udayjain2102/nittanymotorsports/mule/docs/REPORT.md

# NM26 mule: design report

Generated by `python report.py` on 2026-10-11. It holds every design check the code runs, the key analysis results, and every automated test with its outcome. Don't edit it by hand; re-run the script. For what was done and why, see [PROJECT_LOG.md](PROJECT_LOG.md). For the physical tests, see [TEST_PLAN.md](TEST_PLAN.md).

## Key results

| Quantity | Value | From |
|---|---|---|
| Frame | 124 members, 49.4 kg, 71 pieces | `mule.py`, `fab.py` |
| Torsional stiffness | 2399 N·m/deg | `fea.py` |
| Roll-over 6/5/9 kN (legacy AF4 loads), worse of hoop-base supports and inertia relief, safety factor vs welded 4130 yield 340 MPa (criterion under advisor review) | main 1.22, front 1.11 | `fea.py` |
| Frontal impact 95 kN (F.8.7.2), frame safety factor vs welded UTS | 1.26 | `fea.py` |
| Wheel-load cases, worst frame safety factor | 1.34 | `loads.py` |
| Worst link buckling safety factor | 3.8 (rear pushrod (kerb in 1g corner)) | `loads.py` |
| Springs front / rear | 282 / 208 lb/in | `springs.py` |
| Launch, frame safety factor | 1.39 | `powertrain.py` |
| 2000 N pedal, frame safety factor | 1.27 | `brakes.py` |
| 20 g harness crash, frame safety factor vs welded UTS | 1.34 | `harness.py` |
| Mass, front split, CG height, tilt angle | 300 kg, 48.2 %, 325 mm, 61.9 deg | `mass.py` |

## Design checks: 232/232 pass

### FSAE rules (V, F, T) (`mule.py`): 28/28 pass

| | Check | Result |
|---|---|---|
| PASS | V.1.2 wheelbase >=1525 | 1750 |
| PASS | V.1.3.2 small/large track >=75% | 1.00 |
| PASS | V.1.4.2 lower SIS to ground <=90 (should <=75) | 57.1 |
| PASS | F.6.4.4 upper SIS top edge 290-345 above lower SIS bottom | 325.8 |
| PASS | F.3.4.1 size J I>=11320, A>=173 | I=43221 A=270 |
| PASS | F.3.4.1 size H I>=11320, A>=173 | I=24065 A=222 |
| PASS | F.3.4.1 size A I>=11320, A>=173 | I=11626 A=174 |
| PASS | F.3.4.1 size B I>=8509, A>=114 | I=8722 A=123 |
| PASS | F.3.4.1 size C I>=6695, A>=91 | I=6885 A=94 |
| PASS | F.5.8.4 main hoop inside width at base >=380 | 559 |
| PASS | F.5.9.4 MH brace attach <=160 below top | 19.0 |
| PASS | F.5.9.5 MH/brace included angle >=30 | 40.8 deg |
| PASS | F.6.3.4 FH brace attach <=50 below top | 15.9 |
| PASS | F.5.7.4 FH top >= steering wheel top | 866 vs 720 |
| PASS | F.5.7.5 FH <=250 forward of steering wheel | 64 |
| PASS | T.1.4.4 controls below FH top | steering wheel |
| PASS | F.5.6.4a helmet >=50 from MH-FH line | 70 |
| PASS | F.5.6.4b helmet >=50 from MH-brace line | 259 |
| PASS | T.2.1.d upright seat (<=30 deg) | 20 |
| PASS | F.5.6.6 hip->pedal >=915 | 915 |
| PASS | F.8.4.3 bulkhead <=400x350 (no X-brace needed) | 385x335 |
| PASS | F.8.6.3 pedal box 25 mm clear of AIP | 31 |
| PASS | F.8.5.6a IA bottom leading edge <=175 above lower SIS bottom | 63 |
| PASS | F.8.4.2 IA >=200 long, >=200 wide, >=100 high |  |
| PASS | T.2.6.1 shoulder belt angle -20..+10 | -8.1 deg |
| PASS | T.2.6.2 shoulder belt spacing 175-235 | 200 |
| PASS | T.1.5.1a seat not below top of lowest tube | 90 vs 88.9 |
| PASS | frame clear of front tires (steer room >=80) | 327 |

### FSAE frame structure rules (F.1.17, F.3.2.1, F.5, F.6, T.1.3, V.1.1) (`frame_rules.py`): 40/40 pass

| | Check | Result |
|---|---|---|
| PASS | F.5.2.1 every bend radius (tube centreline) >= 3 x tube OD | H: CLR 102 vs 95, J: CLR 127 vs 114 |
| PASS | frame tubes that share no joint stay >= 3 mm apart (no tube passes through another; ours, fab) | none |
| PASS | F.3.2.1 every tube meets the size its job requires | all OK |
| PASS | F.1.17 / F.5.6.2 Primary Structure triangulated in side view (right): no primary joint can move in a pin-jointed truss | 19 joints; none movable |
| PASS | F.1.17 / F.5.6.2 Primary Structure triangulated in side view (left): no primary joint can move in a pin-jointed truss | 19 joints; none movable |
| PASS | F.5.6.3 main hoop bends below its braces are at nodes triangulated in side view | all triangulated |
| PASS | F.5.6.3 front hoop bends below its braces are at nodes triangulated in side view | all triangulated |
| PASS | F.5.2.3 every bent primary member has a same-size support tube within 30 deg of its plane at its farthest point | all supported |
| PASS | F.5.7.3/F.5.7.2 front hoop is one piece from the lowest frame member side to side | 1 piece(s), ends at y [73, 73] |
| PASS | F.5.7 front hoop above the upper side impact < 20 deg from vertical | 0.0 deg |
| PASS | F.5.8.3/F.5.8.2 main hoop is one piece from the lowest frame member side to side | 1 piece(s), ends at y [73, 73] |
| PASS | F.5.8 main hoop above the upper side impact < 10 deg from vertical | 0.0 deg |
| PASS | F.5.8.3b main hoop below the upper side impact not rearward > 10 deg | -0.0 deg |
| PASS | F.5.9 two mh braces, one per side, each straight | 2 brace(s) |
| PASS | F.5.9.3 main hoop and its braces on opposite sides of the vertical through the top | hoop body dx 0 |
| PASS | F.6.3 two fh braces, one per side, each straight | 2 brace(s) |
| PASS | F.6.3.2 front hoop braces extend forward |  |
| PASS | F.6.3.3 front hoop braces end at the bulkhead or a triangulated node |  |
| PASS | F.6.3.5 front hoop above the side impact does not lean rearward > 10 deg (else extra braces) |  |
| PASS | F.5.11.4 no engine or suspension mounts on the main hoop or brace spans | none |
| PASS | F.6.2.3a upper bulkhead support within 50 mm of the bulkhead top and of the upper side impact at the front hoop |  |
| PASS | F.6.2.3c lower bulkhead support from the bulkhead base to the front hoop base |  |
| PASS | F.6.2.3d bulkhead support diagonal fitted (triangulation checked by the truss test) |  |
| PASS | F.6.2 front bulkhead is a closed perimeter (the AIP mounts around it) | closed |
| PASS | F.3.2.1 every lap / anti-sub tab node sits on a harness-size (or larger) tube | all |
| PASS | F.6.2.3b upper bulkhead support <= 100 mm above the upper side impact, or triangulated back (side-view truss test) | 43 mm |
| PASS | F.6.4.4/5 upper side impact connects the main hoop and front hoop |  |
| PASS | F.6.4.4/5 lower side impact connects the main hoop and front hoop |  |
| PASS | F.6.4.6 diagonal side impact joins upper and lower members between the hoops |  |
| PASS | F.6.4.3 three or more side impact members each side |  |
| PASS | F.6.5.1 shoulder harness bar is one piece attached to the main hoop both sides |  |
| PASS | F.6.5.2 shoulder bar straight (a bent bar would need braces at the bends) |  |
| PASS | F.6.5.3 shoulder bar loaded only by the shoulder harness | only harness tabs |
| PASS | F.6.6.2a upper brace support runs from the brace foot to the upper side impact node on the main hoop |  |
| PASS | F.6.6.2b lower brace support ends at the lower side impact node on the main hoop |  |
| PASS | F.5.14 steering rack inside the Primary Structure (no separate protection needed) | rack ends z ±210 |
| PASS | T.1.3.1 driver's hips inside the Major Structure | 0 of 36 hip points outside (hip half-width 200 assumed) |
| PASS | T.1.3.2 driver's legs ahead of the front hoop inside the structural tubing in side and front view (95th male, estimated) | knee top at x 1432, y 506; 0 side-view / 0 front-view leg points outside |
| PASS | T.1.3.2 / ours: no tube within 10 mm of the driver's legs and feet (95th male capsules, estimated) | 22 mm (FBH support upper) |
| PASS | V.1.1 nothing in the tyre zones: above, beside, or within 75 mm fore/aft (frame, attenuator) | clear |

### Frame strength: roll-over, frontal impact, buckling (`fea.py`): 12/12 pass

| | Check | Result |
|---|---|---|
| PASS | frontal impact: 95 kN IA peak (F.8.7.2) through the front structure, FoS >= 1.0 vs welded UTS | 1.26 (FBH support upper); crash case: local yield accepted |
| PASS | Main hoop roll-over 6/5/9 kN (legacy AF4 loads; ours), worse of hoop-base supports and inertia relief, FoS >= 1.0 vs 340 MPa | 1.22; vs F.3.4.2 welded 180 MPa: 0.65 |
| PASS | Main hoop roll-over deflection <= 25 mm | 9.7 mm |
| PASS | Front hoop roll-over 6/5/9 kN (legacy AF4 loads; ours), worse of hoop-base supports and inertia relief, FoS >= 1.0 vs 340 MPa | 1.11; vs F.3.4.2 welded 180 MPa: 0.59 |
| PASS | Front hoop roll-over deflection <= 25 mm | 7.1 mm |
| PASS | buckling: roll-over (6/5/9 kN, worst support), Euler load >= 1.0 x compression in every frame tube (pin-ended; ours) | 2.26 (Main hoop brace) |
| PASS | buckling: frontal impact 95 kN (F.8.7.2), Euler load >= 1.0 x compression in every frame tube (pin-ended; ours) | 2.94 (Upper side impact) |
| PASS | buckling: wheel loads, Euler load >= 1.5 x compression in every frame tube (pin-ended; ours) | 4.92 (Main hoop brace) |
| PASS | buckling: launch, Euler load >= 1.5 x compression in every frame tube (pin-ended; ours) | 3.20 (Engine bay floor diagonal) |
| PASS | buckling: 2000 N pedal, Euler load >= 1.5 x compression in every frame tube (pin-ended; ours) | 35.11 (Front hoop lower brace) |
| PASS | buckling: 20 g harness, Euler load >= 1.0 x compression in every frame tube (pin-ended; ours) | 42.88 (Diagonal side impact) |
| PASS | buckling: wing mounts, Euler load >= 1.5 x compression in every frame tube (pin-ended; ours) | 70.63 (Wing strut) |

### Suspension kinematics (`suspension.py`): 12/12 pass

| | Check | Result |
|---|---|---|
| PASS | front roll centre 15-60 mm | 39 mm |
| PASS | front no lock-up over +/-50 mm (V.3.1.1: 50 mm usable; design +50/-25) |  |
| PASS | front camber gain -1.2..-0.3 deg per 25 mm bump | -0.75 deg @+25, -1.57 @+50, +1.35 @-50; track +0.1 mm @+50 |
| PASS | front Bl inside 13in wheel (\|dy\|<=125, 30<=inset<=110) | dy=118 inset=62 |
| PASS | front Bu inside 13in wheel (\|dy\|<=125, 30<=inset<=110) | dy=120 inset=102 |
| PASS | front KPI 0-10 deg, scrub 0-40 mm | KPI 9.6 deg, scrub 38 mm |
| PASS | rear roll centre 25-80 mm | 50 mm |
| PASS | rear no lock-up over +/-50 mm (V.3.1.1: 50 mm usable; design +50/-25) |  |
| PASS | rear camber gain -1.2..-0.3 deg per 25 mm bump | -0.70 deg @+25, -1.44 @+50, +1.36 @-50; track +0.5 mm @+50 |
| PASS | rear Bl inside 13in wheel (\|dy\|<=125, 30<=inset<=110) | dy=114 inset=65 |
| PASS | rear Bu inside 13in wheel (\|dy\|<=125, 30<=inset<=110) | dy=110 inset=80 |
| PASS | rear KPI 0-10 deg, scrub 0-80 mm | KPI 3.8 deg, scrub 55 mm |

### Rockers and shocks (`rocker.py`): 12/12 pass

| | Check | Result |
|---|---|---|
| PASS | front shock stays in 165-230 mm over +50/-25 mm wheel | 169-224 mm (static 207) |
| PASS | front motion ratio within 10% of springs.py target | 0.72 vs 0.72 |
| PASS | front ratio change over travel -5..+20% (not regressive) | +12% (bump vs droop) |
| PASS | front rocker swing < 35 deg each way | +9/-20 deg |
| PASS | front shock body clears frame tubes >= 5 mm | 41 mm (upper ring_sus) |
| PASS | front rocker arms 40-150 mm | pushrod arm 92, shock arm 109 mm |
| PASS | rear shock stays in 165-230 mm over +50/-25 mm wheel | 168-225 mm (static 207) |
| PASS | rear motion ratio within 10% of springs.py target | 0.75 vs 0.75 |
| PASS | rear ratio change over travel -5..+20% (not regressive) | +11% (bump vs droop) |
| PASS | rear rocker swing < 35 deg each way | +8/-17 deg |
| PASS | rear shock body clears frame tubes >= 5 mm | 72 mm (steer) |
| PASS | rear rocker arms 40-150 mm | pushrod arm 60, shock arm 135 mm |

### Steering (`steering.py`): 5/5 pass

| | Check | Result |
|---|---|---|
| PASS | bump steer \|toe\| <= 0.25 deg over +/-50 mm | -50: -0.11, -25: -0.05, +25: +0.06, +50: +0.12 deg |
| PASS | rear bump steer \|toe\| <= 0.25 deg over +/-50 mm (toe link) | -50: -0.01, -25: -0.00, +25: +0.00, +50: +0.01 deg |
| PASS | rack travel for 23 deg inner lock <= 35 mm | 29.6 mm each side |
| PASS | Ackermann 0-120 % | inner 23.0 / outer 20.6 deg = 50 % |
| PASS | tyre/rim clears arms, rods, frame at full lock (3D) | min gap 10 mm (lower bh_lsus) |

### Side view, caster, pitch, steering ratio (`sideview.py`): 10/10 pass

| | Check | Result |
|---|---|---|
| PASS | front caster 3-7 deg | 4.6 deg |
| PASS | front mechanical trail 5-30 mm | 11.5 mm |
| PASS | anti-dive / anti-squat 0-40 % | anti-dive 0 %, anti-squat 12 % |
| PASS | dive at 1.5 g braking <= 60 % of bump travel | 21 mm front, pitch 1.54 deg |
| PASS | squat at 1 g acceleration <= 60 % of bump travel | 15 mm rear |
| PASS | roll-centre migration <= 2 mm per mm of heave (+/-25 mm) | front +39/-38, rear +44/-44 mm; front RC at full dive 7 mm |
| PASS | bump steer at full lock <= 0.5 deg over +/-25 mm | 0.30 deg |
| PASS | overall steering ratio 4-7 : 1 | 4.1:1, 89 deg to full lock |
| PASS | lock-to-lock <= 180 deg (no hand-over-hand) | 178 deg |
| PASS | steering rim force at 1.5 g <= 120 N (ours) | 105 N (14.2 N*m); kickback 9.3 N*m per 1 kN on one front tyre |

### Roll, static camber, jacking (`roll.py`): 10/10 pass

| | Check | Result |
|---|---|---|
| PASS | front lateral load transfer share within front weight 48 % +0..+12 points (ours: mild understeer) | LLTD 53.0 % front (roll stiffness 55 % front, no bars) |
| PASS | roll gradient 0.5-2.0 deg/g (ours) | 1.47 deg/g, 2.2 deg at 1.5 g |
| PASS | front static camber -3.5..0 deg | -2.5 deg |
| PASS | front outside-wheel camber to ground -2.0..-0.3 deg at 1.5 g (ours) | outside -1.00, inside -4.04 deg |
| PASS | front roll centre stays above ground in roll (jacking keeps its sign) | height 28 mm (static 39); lateral shift -192 mm = -87 mm/deg (low RCs move far sideways) |
| PASS | front jacking lift <= 5 mm at 1.5 g (ours) | -9 N, lift -0.2 mm |
| PASS | rear static camber -3.5..0 deg | -2.0 deg |
| PASS | rear outside-wheel camber to ground -2.0..-0.3 deg at 1.5 g (ours) | outside -0.46, inside -3.56 deg |
| PASS | rear roll centre stays above ground in roll (jacking keeps its sign) | height 36 mm (static 50); lateral shift -214 mm = -97 mm/deg (low RCs move far sideways) |
| PASS | rear jacking lift <= 5 mm at 1.5 g (ours) | 6 N, lift 0.2 mm |

### Compliance steer and camber (pickup stiffness) (`compliance.py`): 2/2 pass

| | Check | Result |
|---|---|---|
| PASS | front compliance at 1.5g corner: toe and camber <= 0.25 deg (ours) | toe 0.109 in, camber -0.028 deg; worst arm stretch 0.062 mm |
| PASS | rear compliance at 1.5g corner: toe and camber <= 0.25 deg (ours) | toe 0.185 out, camber +0.063 deg; worst arm stretch 0.095 mm |

### Uprights and hubs (`uprights.py`): 16/16 pass

| | Check | Result |
|---|---|---|
| PASS | front bearing static safety s0 >= 1.5 (all cases) | 2.40 (SKF 6209-2RS1 (45x85x19 deep groove)) |
| PASS | front bearing L10 >= 3x 2000 km | 365 vs 3.7 Mrev |
| PASS | front hub shaft FoS >= 1.5 (bending + torsion) | 9.5 |
| PASS | front upright arms FoS >= 1.5 (7075-T6) | 2.9 (lower arm 67 mm (3g bump)) |
| PASS | front wheel studs slip torque >= 1.5x max wheel torque | 1469 vs 461 N*m |
| PASS | front rotor + caliper inside rim barrel | 145 vs 155 mm |
| PASS | front upright body clears rotor >= 10 mm | 12 mm |
| PASS | front ball joints within the bearing housing span | BJs z -102/-62, bearings -79/-24 mm from wheel centre |
| PASS | rear bearing static safety s0 >= 1.5 (all cases) | 2.22 (SKF 6209-2RS1 (45x85x19 deep groove)) |
| PASS | rear bearing L10 >= 3x 2000 km | 287 vs 3.7 Mrev |
| PASS | rear hub shaft FoS >= 1.5 (bending + torsion) | 5.2 |
| PASS | rear upright arms FoS >= 1.5 (7075-T6) | 1.6 (lower arm 64 mm (3g bump)) |
| PASS | rear wheel studs slip torque >= 1.5x max wheel torque | 1469 vs 852 N*m |
| PASS | rear rotor + caliper inside rim barrel | 145 vs 155 mm |
| PASS | rear upright body clears rotor >= 10 mm | 12 mm |
| PASS | rear ball joints within the bearing housing span | BJs z -80/-65, bearings -79/-24 mm from wheel centre |

### Powertrain (`powertrain.py`): 15/15 pass

| | Check | Result |
|---|---|---|
| PASS | top speed at redline 100-130 km/h | 117 km/h (13/50 = 3.85) |
| PASS | 1st gear can reach the traction limit | 928 vs 852 N*m |
| PASS | chain centre distance >= r1 + r2 + 25 mm | 200 mm (min 185) |
| PASS | wrap on the front sprocket >= 120 deg | 125 deg |
| PASS | even-link chain fits inside the carrier adjustment | 60 links -> centre 205 mm (+5, adjust +/-20) |
| PASS | chain tension safety >= 4 (traction-limited) | 6.7 kN vs 36 kN |
| PASS | sprockets/chain clear frame tubes >= 10 mm | 18 mm (Rear side bay diagonal (bulkhead pickups)) |
| PASS | sprockets/chain >= 50 mm above ground | 126 mm |
| PASS | chain line outboard of the engine, inboard of the spool posts | z = -180 (engine side -170, posts -234) |
| PASS | CV angle <= limit over +/-50 mm travel | 10.2 deg (shaft 277 mm) |
| PASS | CV plunge <= limit | 4.5 mm |
| PASS | rear toe link clears the CV half-shaft >= 10 mm over travel (boot included) | 54 mm |
| PASS | engine envelope clear of main hoop / firewall | engine front 470, firewall 480 |
| PASS | no frame tube passes through the engine envelope (except within 60 mm of a mount) | none |
| PASS | frame FoS >= 1.2 under full-traction launch | 1.39 (Rear susp ring) |

### Brakes and pedal box (`brakes.py`): 14/14 pass

| | Check | Result |
|---|---|---|
| PASS | lock all four at mu 1.5 with <= 700 N (T.3.1.2c) | 676 N at split 0.587 (front 83 bar, rear 38 bar) |
| PASS | balance split for mu 1.0-1.5 inside the adjuster | 0.443-0.567 (+0.02 front margin), adjuster 0.40-0.60 |
| PASS | lock-up pressure <= Wilwood max operating 138 bar (2000 psi) | front 83, rear 38 bar |
| PASS | line pressure at 2000 N <= 300 bar (T.3.2.2; ASSUMED proof rating, OPEN until written ratings) | front 267, rear 111 bar: above the 138 bar operating rating, so the parts' proof rating decides |
| PASS | MC stroke at 2000 N <= 50 % of stroke | front 10.7, rear 3.2 of 27.9 mm |
| PASS | BOTS: >= 10 mm beyond pedal travel at 2000 N | trip 55 vs 34.3 mm |
| PASS | BOTS: trips >= 10 mm before either circuit's MC bottoms | front lost 80, rear lost 80 mm |
| PASS | pedal swing at a lost circuit <= 30 deg | 27 deg |
| PASS | pedal blade FoS >= 1.5 at 2000 N | 3.91 |
| PASS | pivot bolt FoS >= 1.5 at 2000 N | 7.79 |
| PASS | balance bar FoS >= 1.5 at 2000 N | 2.36 |
| PASS | frame FoS >= 1.2 at 2000 N pedal load | 1.27 (Pedal box cross (rear)) |
| PASS | MC front inside PEDAL_BOX_LEN (F.8.6.3 stack-up) | 2084 vs 2086 |
| PASS | rotor temperature rise, one stop from top speed <= 150 C | front 126, rear 45 C |

### Cockpit templates (T.1.1, T.1.2) (`cockpit.py`): 2/2 pass

| | Check | Result |
|---|---|---|
| PASS | T.1.1 cockpit opening template passes (>= 0 mm) | worst 1 mm at y=365 (Upper side impact) |
| PASS | T.1.2 cross-section template passes to 100 mm behind the pedals (>= 0 mm) | worst 10 mm at x=1226 (Cockpit floor V (anti-sub)) |

### Harness (T.2) (`harness.py`): 8/8 pass

| | Check | Result |
|---|---|---|
| PASS | T.2.5.4a lap belt side-view angle 45-65 deg | 55.0 deg (tab at x=914 on the lower SIS) |
| PASS | T.2.7.1 anti-sub angle <= 20 deg, mount in line or forward | 0.0 deg from vertical |
| PASS | T.2.6.1 shoulder belt angle -20..+10 deg | -8.1 deg |
| PASS | T.2.4.3a tab double tearout >= 15 kN (one belt per tab) | 31.7 kN |
| PASS | T.2.4.3b tab thickness >= 1.6 mm | 3.2 mm |
| PASS | T.2.4.4 tab weld (both sides) >= 15 kN | 48.9 kN |
| PASS | T.2.5.8 / T.2.6.4 / T.2.7.5 bolt sizes | lap M10, shoulder M10, anti-sub M8 |
| PASS | frame FoS >= 1.0 vs welded UTS under a 20 g harness load | 1.34 (Shoulder harness bar); vs welded yield 0.80 (local yielding in a crash is accepted) |

### Shutdown circuit and wiring (IC.9, T.9) (`shutdown.py`): 14/14 pass

| | Check | Result |
|---|---|---|
| PASS | IC.9.2 opening e-stop kills ignition + fuel pump | powered: ['DRS servo', 'brake light', 'fan', 'starter'] |
| PASS | IC.9.2 opening bots kills ignition + fuel pump | powered: ['DRS servo', 'brake light', 'fan', 'starter'] |
| PASS | IC.9.2 opening inertia switch kills ignition + fuel pump | powered: ['DRS servo', 'brake light', 'fan', 'starter'] |
| PASS | IC.9.2 opening primary master switch kills ignition + fuel pump | powered: nothing |
| PASS | IC.9.3.2a primary master switch cuts ALL loads |  |
| PASS | IC.9.3.2b master switch direct acting (no relay upstream) | battery -> fuse -> PMS |
| PASS | every wire: load <= ampacity, fuse <= ampacity | all OK |
| PASS | every branch off the bus is fused (starter excepted) | all OK |
| PASS | switch and relay ratings >= their current | all OK |
| PASS | voltage drop to pump / ignition <= 0.5 V | fuel pump 0.23 V, ignition/ECU 0.23 V |
| PASS | T.9.2.1 battery inside the structure, below the shoulder belt mount | y=150 vs 620 |
| PASS | T.9.3.1 master switch: right side, at the main hoop, shoulder height | x=560, y=665, z=332 |
| PASS | IC.9.4.1b cockpit main switch >= 24 mm | 40 mm |
| PASS | T.3.4 brake light >= 15 cm2, LED line >= 150 mm, wheel-centre to shoulder height, on centreline | 18 cm2, y=520 |

### Rear wing and DRS (T.7, IN.6.2) (`aero.py`): 10/10 pass

| | Check | Result |
|---|---|---|
| PASS | T.7.3.3 wing is behind the head-restraint plane (inside the rear aero zone) | front -59 vs plane x 533 |
| PASS | T.7.5b no more than 250 mm behind the rear tyres | rear edge x -501 vs limit -510 |
| PASS | T.7.6.3 inboard of the rear tyres' inner faces | endplate outer face 506 vs 520 mm |
| PASS | T.7.7.1a no higher than 1200 mm in either flap position | 1188 mm |
| PASS | IN.6.2.2 200 N push on a wing mount deflects <= 25 mm (any direction) | 0.1 mm |
| PASS | T.7.1.3b wing does not oscillate: mount frequency >= 25 Hz (ours, above wheel hop) | 154 Hz |
| PASS | wing mounts: top-speed load x 1.5 + 3 g bump, FoS >= 1.5 vs welded yield | FoS 37.27 |
| PASS | flap servo stall torque >= 2 x (spring + aero moment) at top speed | servo 15 vs 14.9 N*m (aero 3.2, spring 4.2) |
| PASS | DRS reduces wing drag >= 50 % | at 60 km/h: closed 126 N down / 24 N drag, open 43 / 8 N (ASSUMED coefficients) |
| PASS | front axle keeps >= 90 % of its static load at top speed (ours: limits high-speed understeer) | front -110 N (-8 %), rear +587 N at 117 km/h, closed flap |

### Mass and CG budget (`mass.py`): 5/5 pass

| | Check | Result |
|---|---|---|
| PASS | loads.MASS covers the budget (>= total) | budget 300 kg vs assumed 310 |
| PASS | loads.CG_H covers the budget (>= CG height) | budget 325 mm vs assumed 345 |
| PASS | loads.FRONT_SPLIT within 3 % of the budget | budget 48.2 % vs assumed 48 % |
| PASS | springs.UNSPRUNG within 1.5 kg of the budget | budget 16.2 kg vs assumed 15.0 |
| PASS | tilt test IN.11.2.2: rollover angle >= 60 deg | 61.9 deg (CG 325 mm) |

### Event simulation (acceleration, skidpad) (`lapsim.py`): 5/5 pass

| | Check | Result |
|---|---|---|
| PASS | acceleration 75 m <= 5.5 s (ours; point mass, lower bound) | 5.05 s, 89 km/h at the line (Michigan 2025 median 4.617) |
| PASS | skidpad lap <= 6.0 s (ours; point mass at grip 1.2) | 5.38 s at 36 km/h, R 8.62 m (Michigan 2025 median 5.515) |
| PASS | autocross average speed >= 40 km/h (low end of the D.11.1.1 course design speed) | 62.5 s, 48 km/h on our 0.8 km course; hairpins at 5.0 m radius (car minimum 5.0 m) (Michigan 2025: best 48.878, median 55.725 s, other course) |
| PASS | drag does not limit top speed (drag-limited speed > geared top speed) | drag-limited 134 vs geared 117 km/h (drag area 1.0 m^2) |
| PASS | bolt-on rear wing with DRS would not slow any event (vs no wing; ASSUMED coefficients, wing not fitted on the base mule) | accel -0.00 s, skidpad -0.04 s, autocross -0.60 s with the wing |

### Reality-gap robustness (tube tolerances, joint flex, mass error; docs/SIM_TO_REAL.md) (`robustness.py`): 12/12 pass

| | Check | Result |
|---|---|---|
| PASS | robust: Main hoop roll-over (vs welded 4130 ultimate) FoS >= 1.00 in all 32 tolerance samples (seed 7; walls ±10 %, joints ±2 mm, stiffness 60-100 %) | worst 1.34 |
| PASS | robust: Front hoop roll-over (vs welded 4130 ultimate) FoS >= 1.00 in all 32 tolerance samples (seed 7; walls ±10 %, joints ±2 mm, stiffness 60-100 %) | worst 1.10 |
| PASS | robust: wheel loads FoS >= 1.00 in all 32 tolerance samples (seed 7; walls ±10 %, joints ±2 mm, stiffness 60-100 %) | worst 1.17 |
| PASS | robust: launch FoS >= 1.00 in all 32 tolerance samples (seed 7; walls ±10 %, joints ±2 mm, stiffness 60-100 %) | worst 1.11 |
| PASS | robust: 2000 N pedal FoS >= 1.00 in all 32 tolerance samples (seed 7; walls ±10 %, joints ±2 mm, stiffness 60-100 %) | worst 1.10 |
| PASS | robust: 20 g harness (vs welded UTS) FoS >= 1.00 in all 32 tolerance samples (seed 7; walls ±10 %, joints ±2 mm, stiffness 60-100 %) | worst 1.20 |
| PASS | robust: wing mounts / 1.5 FoS >= 1.00 in all 32 tolerance samples (seed 7; walls ±10 %, joints ±2 mm, stiffness 60-100 %) | worst 22.49 |
| PASS | robust: frontal impact 95 kN (vs welded UTS) FoS >= 1.00 in all 32 tolerance samples (seed 7; walls ±10 %, joints ±2 mm, stiffness 60-100 %) | worst 1.09 |
| PASS | robust: buckling, all cases (Euler / compression) FoS >= 1.00 in all 32 tolerance samples (seed 7; walls ±10 %, joints ±2 mm, stiffness 60-100 %) | worst 1.42 |
| PASS | robust: worst sampled torsion (joint flex modelled) >= 2 x suspension roll stiffness | 1778 vs 1003 N*m/deg (cross-check: 2/3 x nominal FEA = 1600) |
| PASS | robust: tilt >= 60 deg with every mass item ±10 % (5th percentile) | 5/50/95 %: 61.8 / 61.9 / 62.1 deg; mass 289-312 kg |
| PASS | robust: tilt >= 60 deg if mass estimates err together (high items +10 %, low items -10 %) | 61.5 deg (CG +6 mm). Weigh parts as they arrive; IN.11.2 is a hard rule |

## Automated tests (`pytest -q tests`): 97/97 pass

Each `test_all_*_checks_pass` test runs one module's checks above; the others test the math directly (hand calculations, equilibrium, limiting cases).

| Test | Outcome | Seconds |
|---|---|---|
| `tests/test_aero.py::test_all_aero_checks_pass` | pass | 0.16 |
| `tests/test_aero.py::test_forces_are_q_s_c` | pass | 0.0 |
| `tests/test_aero.py::test_axle_split_sums_to_downforce` | pass | 0.0 |
| `tests/test_aero.py::test_drs_truth_table_fails_closed` | pass | 0.0 |
| `tests/test_aero.py::test_flap_rotates_about_its_pivot` | pass | 0.0 |
| `tests/test_brakes.py::test_all_brake_checks_pass` | pass | 0.01 |
| `tests/test_brakes.py::test_axle_loads_sum_to_weight_and_transfer_forward` | pass | 0.0 |
| `tests/test_brakes.py::test_front_lock_pressure_hand_calc` | pass | 0.0 |
| `tests/test_brakes.py::test_lock_point_locks_both_axles_at_once` | pass | 0.0 |
| `tests/test_brakes.py::test_pedal_travel_lever_rule` | pass | 0.0 |
| `tests/test_brakes.py::test_pressure_at_split_matches_bar_force` | pass | 0.0 |
| `tests/test_cad_parts.py::test_part_files_match_csv` | pass | 0.0 |
| `tests/test_cad_parts.py::test_assembly_step_has_every_part` | pass | 0.35 |
| `tests/test_cockpit.py::test_templates_pass` | pass | 29.04 |
| `tests/test_cockpit.py::test_polygon_clearance_sign` | pass | 0.0 |
| `tests/test_cockpit.py::test_t12_template_size` | pass | 0.0 |
| `tests/test_fab.py::test_perpendicular_cope_long_point` | pass | 0.0 |
| `tests/test_fab.py::test_90_degree_bend_program` | pass | 0.0 |
| `tests/test_fab.py::test_pieces_cover_every_member_once` | pass | 0.0 |
| `tests/test_fab.py::test_hoops_bendable_with_legal_radius` | pass | 0.0 |
| `tests/test_fab.py::test_every_tube_end_has_a_joint_and_never_copes_onto_a_smaller_tube` | pass | 0.4 |
| `tests/test_fab.py::test_outputs_written` | pass | 10.43 |
| `tests/test_fea.py::test_cantilever_and_inertia_relief` | pass | 0.01 |
| `tests/test_fea.py::test_hoop_cases_and_torsion` | pass | 0.13 |
| `tests/test_fea.py::test_inertia_relief_stress_independent_of_support_node` | pass | 0.02 |
| `tests/test_frame_opt.py::test_current_sizing_passes_all_gates` | pass | 1.17 |
| `tests/test_frame_opt.py::test_write_changes_only_the_named_group` | pass | 0.0 |
| `tests/test_frame_rules.py::test_all_frame_rule_checks_pass` | pass | 0.64 |
| `tests/test_frame_rules.py::test_missing_side_impact_diagonal_breaks_triangulation` | pass | 0.58 |
| `tests/test_frame_rules.py::test_undersized_main_hoop_fails_tube_size` | pass | 0.61 |
| `tests/test_frame_rules.py::test_bent_main_hoop_brace_fails` | pass | 0.57 |
| `tests/test_frame_rules.py::test_mount_on_main_hoop_brace_span_fails` | pass | 0.61 |
| `tests/test_frame_rules.py::test_tube_in_front_tyre_zone_fails` | pass | 0.56 |
| `tests/test_frame_rules.py::test_kinked_upper_bulkhead_support_without_same_size_support_fails` | pass | 0.55 |
| `tests/test_frame_rules.py::test_lower_support_kink_with_smaller_ring_cross_fails` | pass | 0.57 |
| `tests/test_frame_rules.py::test_main_hoop_bend_without_side_view_tube_fails` | pass | 0.55 |
| `tests/test_frame_rules.py::test_leg_above_the_structure_fails` | pass | 0.52 |
| `tests/test_harness.py::test_all_harness_checks_pass` | pass | 0.01 |
| `tests/test_harness.py::test_tab_tearout_hand_calc` | pass | 0.0 |
| `tests/test_harness.py::test_lap_tab_placed_at_the_target_angle` | pass | 0.0 |
| `tests/test_lapsim.py::test_all_lapsim_checks_pass` | pass | 0.24 |
| `tests/test_lapsim.py::test_skidpad_is_steady_state_circle` | pass | 0.0 |
| `tests/test_lapsim.py::test_traction_limited_accel_matches_constant_acceleration` | pass | 0.0 |
| `tests/test_lapsim.py::test_autocross_on_one_long_circle_is_steady_cornering` | pass | 0.01 |
| `tests/test_loads.py::test_321_support_statics` | pass | 0.0 |
| `tests/test_loads.py::test_upright_equilibrium_every_case` | pass | 0.0 |
| `tests/test_loads.py::test_links_dont_buckle_and_frame_holds` | pass | 0.24 |
| `tests/test_mass.py::test_all_mass_checks_pass` | pass | 0.0 |
| `tests/test_mass.py::test_summary_is_mass_weighted` | pass | 0.0 |
| `tests/test_mass.py::test_frame_mass_matches_member_sum` | pass | 0.0 |
| `tests/test_powertrain.py::test_all_powertrain_checks_pass` | pass | 0.09 |
| `tests/test_powertrain.py::test_chain_length_formula_equal_sprockets` | pass | 0.0 |
| `tests/test_powertrain.py::test_centre_for_links_inverts_chain_links` | pass | 0.0 |
| `tests/test_powertrain.py::test_engine_mounts_balance_the_chain_force` | pass | 0.0 |
| `tests/test_powertrain.py::test_kit_fit_passes_small_block_and_fails_big_one` | pass | 0.0 |
| `tests/test_robustness.py::test_all_robustness_checks_pass` | pass | 14.65 |
| `tests/test_robustness.py::test_random_draws_are_fixed_per_tube` | pass | 0.0 |
| `tests/test_rocker.py::test_all_rocker_checks_pass` | pass | 0.03 |
| `tests/test_rocker.py::test_shock_compresses_in_bump` | pass | 0.0 |
| `tests/test_rocker.py::test_rocker_load_split_balances_force_and_moment` | pass | 0.06 |
| `tests/test_roll_compliance.py::test_all_roll_and_compliance_checks_pass` | pass | 0.09 |
| `tests/test_roll_compliance.py::test_no_lateral_g_gives_static_values` | pass | 0.03 |
| `tests/test_roll_compliance.py::test_rigid_links_and_frame_give_zero_compliance` | pass | 0.02 |
| `tests/test_rules.py::test_all_rule_checks_pass` | pass | 0.0 |
| `tests/test_rules.py::test_tube_sizes_meet_F_3_4_1` | pass | 0.0 |
| `tests/test_rules.py::test_frame_is_symmetric` | pass | 0.0 |
| `tests/test_rules.py::test_no_zero_length_or_duplicate_members` | pass | 0.0 |
| `tests/test_rules.py::test_belly_pan_sits_under_lowest_tubes` | pass | 0.06 |
| `tests/test_rules.py::test_suspension_links_are_symmetric_pairs` | pass | 0.0 |
| `tests/test_rules.py::test_readme_colour_key_matches_the_model` | pass | 0.0 |
| `tests/test_rules.py::test_every_cad_colour_group_has_a_part_code` | pass | 0.0 |
| `tests/test_shutdown.py::test_all_shutdown_checks_pass` | pass | 0.0 |
| `tests/test_shutdown.py::test_all_closed_runs_the_engine` | pass | 0.0 |
| `tests/test_shutdown.py::test_any_series_device_open_kills_the_engine` | pass | 0.0 |
| `tests/test_sideview.py::test_all_sideview_checks_pass` | pass | 0.27 |
| `tests/test_sideview.py::test_caster_trail_hand_calc` | pass | 0.0 |
| `tests/test_sideview.py::test_parallel_horizontal_pivots_give_zero_anti` | pass | 0.0 |
| `tests/test_sideview.py::test_ride_rate_is_series_springs` | pass | 0.0 |
| `tests/test_sideview.py::test_steering_effort_hand_calc` | pass | 0.13 |
| `tests/test_springs.py::test_springs_and_stroke_are_buyable` | pass | 0.0 |
| `tests/test_springs.py::test_spring_split_gives_mild_understeer_balance` | pass | 0.01 |
| `tests/test_springs.py::test_motion_ratio_and_travel_meet_targets` | pass | 0.0 |
| `tests/test_steering.py::test_all_steering_checks_pass` | pass | 0.1 |
| `tests/test_steering.py::test_kingpin_rotation_is_rigid` | pass | 0.0 |
| `tests/test_suspension.py::test_parallel_equal_arms_have_no_camber_gain` | pass | 0.0 |
| `tests/test_suspension.py::test_all_suspension_checks_pass` | pass | 0.0 |
| `tests/test_suspension.py::test_upright_moves_rigidly` | pass | 0.0 |
| `tests/test_test_plan.py::test_brake_numbers` | pass | 0.0 |
| `tests/test_test_plan.py::test_frame_numbers` | pass | 0.12 |
| `tests/test_test_plan.py::test_tilt_margin` | pass | 0.0 |
| `tests/test_test_plan.py::test_gearing_and_ride` | pass | 0.0 |
| `tests/test_test_plan.py::test_event_predictions` | pass | 0.0 |
| `tests/test_test_plan.py::test_mass_numbers` | pass | 0.0 |
| `tests/test_uprights.py::test_all_upright_checks_pass` | pass | 0.0 |
| `tests/test_uprights.py::test_bearing_split_overhung_lever_rule` | pass | 0.0 |
| `tests/test_uprights.py::test_lateral_load_goes_axial_and_adds_moment` | pass | 0.0 |
| `tests/test_uprights.py::test_stud_slip_torque_formula` | pass | 0.0 |
