udayjain2102/nittanymotorsports/history/frame_v5_49.4kg/docs/REPORT.md

# NM26 mule: design report

Generated by `python report.py` on 2026-10-10. It holds every design check the code runs, the key analysis results, and every automated test with its outcome. Don't edit it by hand; re-run the script. For what was done and why, see [PROJECT_LOG.md](PROJECT_LOG.md). For the physical tests, see [TEST_PLAN.md](TEST_PLAN.md).

## Key results

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

## Design checks: 232/232 pass

### FSAE rules (V, F, T) (`mule.py`): 28/28 pass

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

### Frame strength: roll-over, frontal impact, buckling (`fea.py`): 12/12 pass

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

### Suspension kinematics (`suspension.py`): 12/12 pass

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

### Rockers and shocks (`rocker.py`): 12/12 pass

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

### Steering (`steering.py`): 5/5 pass

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

### Side view, caster, pitch, steering ratio (`sideview.py`): 10/10 pass

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

### Roll, static camber, jacking (`roll.py`): 10/10 pass

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

### Compliance steer and camber (pickup stiffness) (`compliance.py`): 2/2 pass

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

### Uprights and hubs (`uprights.py`): 16/16 pass

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

### Powertrain (`powertrain.py`): 15/15 pass

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

### Brakes and pedal box (`brakes.py`): 14/14 pass

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

### Cockpit templates (T.1.1, T.1.2) (`cockpit.py`): 2/2 pass

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

### Harness (T.2) (`harness.py`): 8/8 pass

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

### Shutdown circuit and wiring (IC.9, T.9) (`shutdown.py`): 14/14 pass

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

### Rear wing and DRS (T.7, IN.6.2) (`aero.py`): 10/10 pass

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

### Mass and CG budget (`mass.py`): 5/5 pass

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

### Event simulation (acceleration, skidpad) (`lapsim.py`): 5/5 pass

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

## Automated tests (`pytest -q tests`): 97/97 pass

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

| Test | Outcome | Seconds |
|---|---|---|
| `tests/test_aero.py::test_all_aero_checks_pass` | pass | 0.17 |
| `tests/test_aero.py::test_forces_are_q_s_c` | pass | 0.0 |
| `tests/test_aero.py::test_axle_split_sums_to_downforce` | pass | 0.0 |
| `tests/test_aero.py::test_drs_truth_table_fails_closed` | pass | 0.0 |
| `tests/test_aero.py::test_flap_rotates_about_its_pivot` | pass | 0.0 |
| `tests/test_brakes.py::test_all_brake_checks_pass` | pass | 0.01 |
| `tests/test_brakes.py::test_axle_loads_sum_to_weight_and_transfer_forward` | pass | 0.0 |
| `tests/test_brakes.py::test_front_lock_pressure_hand_calc` | pass | 0.0 |
| `tests/test_brakes.py::test_lock_point_locks_both_axles_at_once` | pass | 0.0 |
| `tests/test_brakes.py::test_pedal_travel_lever_rule` | pass | 0.0 |
| `tests/test_brakes.py::test_pressure_at_split_matches_bar_force` | pass | 0.0 |
| `tests/test_cad_parts.py::test_part_files_match_csv` | pass | 0.0 |
| `tests/test_cad_parts.py::test_assembly_step_has_every_part` | pass | 0.37 |
| `tests/test_cockpit.py::test_templates_pass` | pass | 29.85 |
| `tests/test_cockpit.py::test_polygon_clearance_sign` | pass | 0.0 |
| `tests/test_cockpit.py::test_t12_template_size` | pass | 0.0 |
| `tests/test_fab.py::test_perpendicular_cope_long_point` | pass | 0.0 |
| `tests/test_fab.py::test_90_degree_bend_program` | pass | 0.0 |
| `tests/test_fab.py::test_pieces_cover_every_member_once` | pass | 0.0 |
| `tests/test_fab.py::test_hoops_bendable_with_legal_radius` | pass | 0.0 |
| `tests/test_fab.py::test_every_tube_end_has_a_joint_and_never_copes_onto_a_smaller_tube` | pass | 0.41 |
| `tests/test_fab.py::test_outputs_written` | pass | 10.3 |
| `tests/test_fea.py::test_cantilever_and_inertia_relief` | pass | 0.01 |
| `tests/test_fea.py::test_hoop_cases_and_torsion` | pass | 0.12 |
| `tests/test_fea.py::test_inertia_relief_stress_independent_of_support_node` | pass | 0.02 |
| `tests/test_frame_opt.py::test_current_sizing_passes_all_gates` | pass | 1.03 |
| `tests/test_frame_opt.py::test_write_changes_only_the_named_group` | pass | 0.0 |
| `tests/test_frame_rules.py::test_all_frame_rule_checks_pass` | pass | 0.53 |
| `tests/test_frame_rules.py::test_missing_side_impact_diagonal_breaks_triangulation` | pass | 0.5 |
| `tests/test_frame_rules.py::test_undersized_main_hoop_fails_tube_size` | pass | 0.52 |
| `tests/test_frame_rules.py::test_bent_main_hoop_brace_fails` | pass | 0.44 |
| `tests/test_frame_rules.py::test_mount_on_main_hoop_brace_span_fails` | pass | 0.52 |
| `tests/test_frame_rules.py::test_tube_in_front_tyre_zone_fails` | pass | 0.52 |
| `tests/test_frame_rules.py::test_kinked_upper_bulkhead_support_without_same_size_support_fails` | pass | 0.53 |
| `tests/test_frame_rules.py::test_lower_support_kink_with_smaller_ring_cross_fails` | pass | 0.52 |
| `tests/test_frame_rules.py::test_main_hoop_bend_without_side_view_tube_fails` | pass | 0.49 |
| `tests/test_frame_rules.py::test_leg_above_the_structure_fails` | pass | 0.52 |
| `tests/test_harness.py::test_all_harness_checks_pass` | pass | 0.01 |
| `tests/test_harness.py::test_tab_tearout_hand_calc` | pass | 0.0 |
| `tests/test_harness.py::test_lap_tab_placed_at_the_target_angle` | pass | 0.0 |
| `tests/test_lapsim.py::test_all_lapsim_checks_pass` | pass | 0.24 |
| `tests/test_lapsim.py::test_skidpad_is_steady_state_circle` | pass | 0.0 |
| `tests/test_lapsim.py::test_traction_limited_accel_matches_constant_acceleration` | pass | 0.0 |
| `tests/test_lapsim.py::test_autocross_on_one_long_circle_is_steady_cornering` | pass | 0.01 |
| `tests/test_loads.py::test_321_support_statics` | pass | 0.0 |
| `tests/test_loads.py::test_upright_equilibrium_every_case` | pass | 0.0 |
| `tests/test_loads.py::test_links_dont_buckle_and_frame_holds` | pass | 0.25 |
| `tests/test_mass.py::test_all_mass_checks_pass` | pass | 0.0 |
| `tests/test_mass.py::test_summary_is_mass_weighted` | pass | 0.0 |
| `tests/test_mass.py::test_frame_mass_matches_member_sum` | pass | 0.0 |
| `tests/test_powertrain.py::test_all_powertrain_checks_pass` | pass | 0.09 |
| `tests/test_powertrain.py::test_chain_length_formula_equal_sprockets` | pass | 0.0 |
| `tests/test_powertrain.py::test_centre_for_links_inverts_chain_links` | pass | 0.0 |
| `tests/test_powertrain.py::test_engine_mounts_balance_the_chain_force` | pass | 0.0 |
| `tests/test_powertrain.py::test_kit_fit_passes_small_block_and_fails_big_one` | pass | 0.0 |
| `tests/test_robustness.py::test_all_robustness_checks_pass` | pass | 15.11 |
| `tests/test_robustness.py::test_random_draws_are_fixed_per_tube` | pass | 0.0 |
| `tests/test_rocker.py::test_all_rocker_checks_pass` | pass | 0.03 |
| `tests/test_rocker.py::test_shock_compresses_in_bump` | pass | 0.0 |
| `tests/test_rocker.py::test_rocker_load_split_balances_force_and_moment` | pass | 0.06 |
| `tests/test_roll_compliance.py::test_all_roll_and_compliance_checks_pass` | pass | 0.09 |
| `tests/test_roll_compliance.py::test_no_lateral_g_gives_static_values` | pass | 0.03 |
| `tests/test_roll_compliance.py::test_rigid_links_and_frame_give_zero_compliance` | pass | 0.02 |
| `tests/test_rules.py::test_all_rule_checks_pass` | pass | 0.0 |
| `tests/test_rules.py::test_tube_sizes_meet_F_3_4_1` | pass | 0.0 |
| `tests/test_rules.py::test_frame_is_symmetric` | pass | 0.0 |
| `tests/test_rules.py::test_no_zero_length_or_duplicate_members` | pass | 0.0 |
| `tests/test_rules.py::test_belly_pan_sits_under_lowest_tubes` | pass | 0.02 |
| `tests/test_rules.py::test_suspension_links_are_symmetric_pairs` | pass | 0.0 |
| `tests/test_rules.py::test_readme_colour_key_matches_the_model` | pass | 0.0 |
| `tests/test_rules.py::test_every_cad_colour_group_has_a_part_code` | pass | 0.0 |
| `tests/test_shutdown.py::test_all_shutdown_checks_pass` | pass | 0.0 |
| `tests/test_shutdown.py::test_all_closed_runs_the_engine` | pass | 0.0 |
| `tests/test_shutdown.py::test_any_series_device_open_kills_the_engine` | pass | 0.0 |
| `tests/test_sideview.py::test_all_sideview_checks_pass` | pass | 0.27 |
| `tests/test_sideview.py::test_caster_trail_hand_calc` | pass | 0.0 |
| `tests/test_sideview.py::test_parallel_horizontal_pivots_give_zero_anti` | pass | 0.0 |
| `tests/test_sideview.py::test_ride_rate_is_series_springs` | pass | 0.0 |
| `tests/test_sideview.py::test_steering_effort_hand_calc` | pass | 0.13 |
| `tests/test_springs.py::test_springs_and_stroke_are_buyable` | pass | 0.0 |
| `tests/test_springs.py::test_spring_split_gives_mild_understeer_balance` | pass | 0.01 |
| `tests/test_springs.py::test_motion_ratio_and_travel_meet_targets` | pass | 0.0 |
| `tests/test_steering.py::test_all_steering_checks_pass` | pass | 0.1 |
| `tests/test_steering.py::test_kingpin_rotation_is_rigid` | pass | 0.0 |
| `tests/test_suspension.py::test_parallel_equal_arms_have_no_camber_gain` | pass | 0.0 |
| `tests/test_suspension.py::test_all_suspension_checks_pass` | pass | 0.0 |
| `tests/test_suspension.py::test_upright_moves_rigidly` | pass | 0.0 |
| `tests/test_test_plan.py::test_brake_numbers` | pass | 0.0 |
| `tests/test_test_plan.py::test_frame_numbers` | pass | 0.12 |
| `tests/test_test_plan.py::test_tilt_margin` | pass | 0.0 |
| `tests/test_test_plan.py::test_gearing_and_ride` | pass | 0.0 |
| `tests/test_test_plan.py::test_event_predictions` | pass | 0.0 |
| `tests/test_test_plan.py::test_mass_numbers` | pass | 0.0 |
| `tests/test_uprights.py::test_all_upright_checks_pass` | pass | 0.0 |
| `tests/test_uprights.py::test_bearing_split_overhung_lever_rule` | pass | 0.0 |
| `tests/test_uprights.py::test_lateral_load_goes_axial_and_adds_moment` | pass | 0.0 |
| `tests/test_uprights.py::test_stud_slip_torque_formula` | pass | 0.0 |
