udayjain2102/nittanymotorsports/WHATS_NEXT.md

# What's next

In order. Tick them off here as they're done. The costs come from [`mule/docs/BUDGET_PLAN.md`](mule/docs/BUDGET_PLAN.md), the parts from [`mule/docs/PARTS_LIST.md`](mule/docs/PARTS_LIST.md).
Last updated 2026-10-10. Engine chosen (CRF450R 2018+); frame 49.4 kg (the 50.4 kg post-audit frame minus two tubes from the topology study, merged 10 Oct), every check passing; total to a driving car about **$7,700–11,600** (list prices; see the jugaad plan for the donated/sponsored route).

## Funding is smaller: jugaad plan
- [ ] No limit yet. [`mule/docs/JUGAAD_PLAN.md`](mule/docs/JUGAAD_PLAN.md): about $6,200–10,700 paying for everything, about $4,000–6,000 with a donated engine and sponsored tube (real prices, 1 Oct 2026).
- [ ] Before applying: ask for an engine donation / crashed 2018+ CRF450R (dealers, riders, alumni), a tube sponsor (local steel distributor), and used parts from nearby teams.
- [ ] Decide steel by who welds it: 4130 (TIG, 49.4 kg) or 1020 DOM (team MIG; branch `jugaad-1020` was sized before the audit gates and must be re-run). Same price per foot.

## This week (no money needed)
- [ ] Ask nearby FSAE teams for used 13″ wheels, slicks, MTB coil shocks, rod ends and uprights.
- [ ] Ask Keizer and Hoosier about FSAE sponsorship or discounts.
- [ ] Submit the funding request for **step 0 ($100–200)** and **step 1 ($1,350–2,300)**.
- [ ] Borrow or find a CRF450R 2018+ to measure (a dealer, a team member's bike or another FSAE team). The frame can't be finalised without its mount points.

## Frame quote and review
- [ ] Send the shop the whole `mule/quote/` folder (frame STEP, material list, shop data, cover note) for a preliminary quote, in 4130 and 1020 DOM.
- [ ] Ask the faculty advisor or an FSAE alum to review the roll-over criterion (welded 4130: 340 MPa yield, 410 MPa ultimate; `SIM_TO_REAL.md`) and the TIG procedure. If the shop quotes 1020 DOM, the criterion has to be redone for that steel.

## Clean-sheet frame designs (history: C2 won at 44.3 kg; after the audit gates the same layout is 50.4 kg; the topology study took it to 49.4 kg)
Realistic target with the current safety standards: **~44–45 kg** for the frame types tried so far; the 30s need a different packaging (see WORKDONE §8).
- [x] B1 front box ahead of the leg template: 51 kg, rejected (branch `clean-sheet-B`).
- [x] C1 "short" (branch `clean-sheet-short`): 46.5 kg, 74 pieces, torsion 2305 (main: 46.4 kg, 78, 2004). Same mass, stiffer, more margin, fewer pieces; helmet clearance thinner (54 vs 65 mm). **No weight win**; keep as the candidate if stiffness/fewer pieces matter more than 0.1 kg.
- [x] **C2 node-mounted rear** (developed on branch `clean-sheet-C2`, now merged into `main`): **44.3 kg**, 73 pieces, torsion 1946, every check passing. −2.1 kg against `main`, the best concept so far. Thinner: robust tilt 60.3°, rear upright arm FoS 1.6. Combining it with C1's seat/front hoop is untested.
- [x] C3 direct-acting front shocks: **checked, not built.** No frame node is within a shock's length of the upright (nearest usable 384 mm; shocks are 207–223 mm at ride). It would need a front outrigger tower each side (≈1.2 kg), about cancelling the rockers it removes, with a wishbone clash risk. Details in PROJECT_LOG.
- [x] Winner so far: C2, merged into `main`; CAD, shop data and the quote package regenerated. If C3 or a C1+C2 combination beats it, merge that the same way.
- [x] Topology study (branch `topo-experiment`, merged 10 Oct): two tubes removed, 50.4 → 49.4 kg; adding diagonals saved only 0.08 kg for 8 tubes, so none added. Details in `mule/docs/VERSIONS.md`.
- [x] Uploaded frame v5 (49.4 kg) to Fusion as `NM26_Assembly_v8` (12 Oct).
- [ ] Give `frame_opt.py` a rule that a straight run of one tube keeps one size (it can currently size two collinear parts differently, which can't be coped).

## Frame audit, 1 Oct 2026: fix before ordering tube
A read-only audit found problems the passing checks hide. Fixed on 2 Oct (branch `audit-fixes`) except the first item, which needs the advisor. Detail in `mule/docs/PROJECT_LOG.md`.
- [ ] **Roll-hoop strength criterion (advisor decision).** Sized to 340 MPa under the worse of two supports: main 1.23, front 1.18. At 180 MPa no tube on the ladder works (1.5 × 0.095 main hoop still 1.5× over), so F.3.4.2 reads as the SES equivalency basis, not an absolute load check. Original note: `fea.py` uses a self-chosen 340/410 MPa welded allowable and legacy AF4 loads; the 2026 rules have no AF section, and F.3.4.2 sets welded steel at 180/300 MPa "for ANY steel" in SES calculations. Hoop FoS 1.02–1.09 drops to about 0.55 at 180 MPa and below 1.0 under other reasonable supports. Decide the criterion with the advisor, then re-size.
  - Same question for the crash cases (95 kN frontal, 20 g harness): they use F.3.4.2's 300 MPa welded UTS and gave the 50.4 kg frame (now 49.4 kg after the topology study). Against the welded-4130 410 MPa the roll-over case already uses, the frame sizes to **46.65 kg** (checked 2 Oct). Show the advisor both.
- [x] **F.5.2.3 bent tubes.** Fixed: check rewritten to the rule (same size, within 30°); upper support straightened, ring-bottom cross sized to the lower support. Original note: The check accepts any stiffer tube at a kink; the rule needs a support of the same diameter and thickness. The upper bulkhead support kinks about 8.5° at `ring_top` with only an out-of-plane post; the lower one kinks at `ring_bot` with a smaller cross. Straighten them or add compliant supports, and fix the check.
- [x] **F.5.6.3 main-hoop bend at `mh_bar`.** Fixed: check needs a side-view tube; new C tube from the bend to the rear ring top. Original note: It passes only because the lateral shoulder bar is counted; the rule needs side-view triangulation (or < 25 mm from an attachment point). Move the bend or add a side-view tube.
- [x] **Fab data.** Fixed: square-cut ends run past the joint (hoop legs +16 mm), hoop-corner jig points on the bent tube, tube clash check (the bulkhead diagonal went through the pedal-box node: moved). Ask the bender about the 78 mm main-hoop top straight. Original note: Hoop legs and ring posts end at node centrelines, so tubes coped onto them overhang air; several nodes take 6–7 tubes. Hoop corner nodes sit 28–35 mm outside the real bent tube. Re-issue cut lengths and jig points from the real bend radius.
- [x] **Missing analyses.** Added: frontal 95 kN (FoS 1.31 vs 300 MPa), member buckling in every case, inertia-relief roll-over. Original note: No frontal-impact load path (F.8.7.2, 95 kN through the bulkhead) and no member buckling check (main-hoop brace at about 0.63 of its Euler load).
- [x] **Robustness gate is overfit.** Fixed: the report checks 32 fresh samples (seed 7); the optimiser sizes on its own 16 with a 1.08 margin. Original note: The optimiser sized tubes against the same 16 seeded samples; fresh seeds give front-hoop FoS 0.974 and harness 0.975. Use fresh samples or a margin.
- [x] **Harness case.** Fixed: 100 kg driver, driver no longer in the inertia relief (FoS 1.33 vs 300 MPa). Original note: Driver mass is 80 kg but the cockpit is sized to the 95th-percentile male (about 100 kg); at 100 kg the 20 g case falls below 1.0.
- [x] **RULES_MATRIX** Fixed: F.5.2.1 now a real check, F.5.3.3/F.6.2.2 build items, T.1.3.2 leg check added (F.5.9.7 doesn't exist). Original note: marks F.5.2.1, F.5.3.3 and F.6.2.2 as automated with no real check; T.1.3.2 (legs below structure ahead of the front hoop) is missing.

## Before ordering frame tube: pin down the engine
The frame's engine mounts are welded in step 1, so the engine has to be known first.
- [x] Choose the engine: **Honda CRF450R 2018+** (electric start is standard from 2018; a 2017 only if it already has Honda's electric-start kit). The kit engine (Predator 420 + CVT) was ruled out: it does not fit the 450 bay (`python powertrain.py`, Option A).
- [x] Service-manual data in `ENGINE` in `powertrain.py`: primary 66/28, gears 32/15, 29/17, 27/19, 23/19, 24/23, dry mass 30.9 kg (2017–18 service manual p. 1-4/1-5). Rev limit not found yet.
- [ ] Measure the engine (or a borrowed one) for mount points, countershaft position and envelope; enter them in `ENGINE` and make `python report.py` pass **before** ordering tube.

## Step 0: mock-up ($100–200)
- [ ] Build the plywood/conduit buck (`mule/docs/BUILD_PLAN.md` §2m).
- [ ] Fit the tallest and the smallest driver; check the T.1.1/T.1.2 templates; time a 5 s exit.
- [ ] Fix anything that fails in `mule/mule.py` **before** ordering tube, and re-run `python report.py`.

## Step 1: frame ($1,350–2,300)
- [ ] Order 4130 tube from `mule/fab/tube_order_list.csv` (+25 %), plus tabs, plate and filler.
- [ ] Build the jig from `mule/fab/jig_node_coordinates.csv`; cut and cope from `mule/fab/tube_cut_sheet.csv`; bend hoops from `mule/fab/hoop_bend_program.csv`.
- [ ] Weld the frame. Run TEST_PLAN stage 1 (weight, twist stiffness: predicted 2399 N·m/deg FEA, pass ≥ 1000 measured).
- [ ] Take photos and results to the next funding request.

## Steps 2–4: to a driving car
- [ ] Step 2, rolling chassis ($1,800–2,500): suspension, used shocks, fabricated steel uprights (re-check in `uprights.py`), used wheels and tyres, cheap rack. Then TEST_PLAN stage 2.
- [ ] Step 3, engine and drive ($2,600–4,000 with a used 450). This is over the ~$2,500 per request, so split it: **3a** the engine ($1,500–2,800, a running 2018+ CRF450R with electric start), then **3b** chain, sprockets, spool, CV shafts, cooling, exhaust and fuel. Check the engine against the measured numbers before 3b.
- [ ] Before step 4: email Wilwood (GP200, PS-1 calipers), Tilton (78-series master cylinders) and the hose supplier for their **maximum (proof/burst) pressure ratings in writing**. The 2000 N pedal test needs 267 bar (3,870 psi); Wilwood's published maximum operating pressure is 2000 psi (138 bar), normal lock-up needs 80 bar. *(On hold for now.)*
- [ ] Step 4, brakes, safety and electrics ($1,800–2,600): buy only brake parts whose written proof rating covers 267 bar; buy the harness new. Then TEST_PLAN stages 3–6. **First drive.**

## After it drives
- [ ] Weigh the car and enter real masses in `mule/mass.py`: the tilt margin is about 1.5–1.9° (61.9° nominal, 61.5° if the mass estimates all err the same way).
- [ ] TEST_PLAN stage 7 (skidpad); put the measured grip back into `lapsim.py`.
- [ ] Upgrades, one request each: new tyres → Kaz rack → rear wing + DRS (bolt-on; set `aero.FITTED = True` and re-run everything) → data logging.

## Keeping the repo useful
- After every test stage, run the real-to-sim loop in `mule/docs/SIM_TO_REAL.md`: record predicted vs measured, fix the model input that was wrong, re-run `report.py`.
- Weigh every part as it arrives and enter it in `mule/mass.py`: the tilt margin is about 1.5–1.9°.
- Every FSAE rule is a hard requirement. A design change must keep all automated checks passing, and `mule/docs/RULES_MATRIX.md` lists the build/inspection items to tick off.
- **Nothing is ever deleted.** Before a change that regenerates CAD, shop data or the quote package, freeze the current version: `python snapshot.py frame_vN_<mass>kg` in `mule/` (it goes to the top-level `history/` folder), and add a git tag with the same name.
- Every design change: edit the code, run `python report.py` in `mule/`, add a line to `mule/docs/PROJECT_LOG.md`, then commit and push (GitHub re-runs every check).
- A day's work goes into `WORKDONE.md` as a short summary; the detail stays in `PROJECT_LOG.md`.
- No MATLAB needed: everything runs in Python (see the README quick start for the setup).
- New Fusion uploads go in `adi laptop files > Nittany Motorsports` as the next version. Current: `NM26_Assembly_v8` (49.4 kg frame v5, no wing, 12 Oct 2026). v7 is the 50.4 kg post-audit frame and v6 the same with a stray DRS wire; v5 (44.3 kg) and v4 are in the same folder; next is `_v9`. Every version's differences: `mule/docs/VERSIONS.md`. v4 (the first 50.1 kg frame) is still in the same folder; nothing is deleted.
