udayjain2102/nittanymotorsports/history/frame_v5_49.4kg/quote/material_list.csv

material | size | pieces | total cut length m | longest piece mm | 20 ft sticks | order
4130 round tube (normalized) | 1.500" OD x 0.095" wall | 4 | 4.01 | 2765 | 1 | 20 ft
4130 round tube (normalized) | 1.250" OD x 0.095" wall | 10 | 8.49 | 1989 | 2 | 40 ft
4130 round tube (normalized) | 1.000" OD x 0.065" wall | 16 | 6.88 | 902 | 2 | 40 ft
4130 round tube (normalized) | 1.000" OD x 0.049" wall | 29 | 12.72 | 1287 | 3 | 60 ft
4130 round tube (normalized) | 1.000" OD x 0.095" wall | 12 | 7.07 | 1244 | 2 | 40 ft
4130 sheet | 0.125" (3.2 mm) | 44 | 0.039 m2 net | 34 x 26 mm blanks | - | 12" x 12" sheet
Steel bar/tube for rocker pivot bushings | 5/8" OD, bore to suit the rocker bolt | 4 | 0.19 | 48 | - | 1 ft
