udayjain2102/nittanymotorsports/history/frame_v5_49.4kg/cad/parts/NM26-FRM-071_tube_A_Main_hoop_brace_R.step

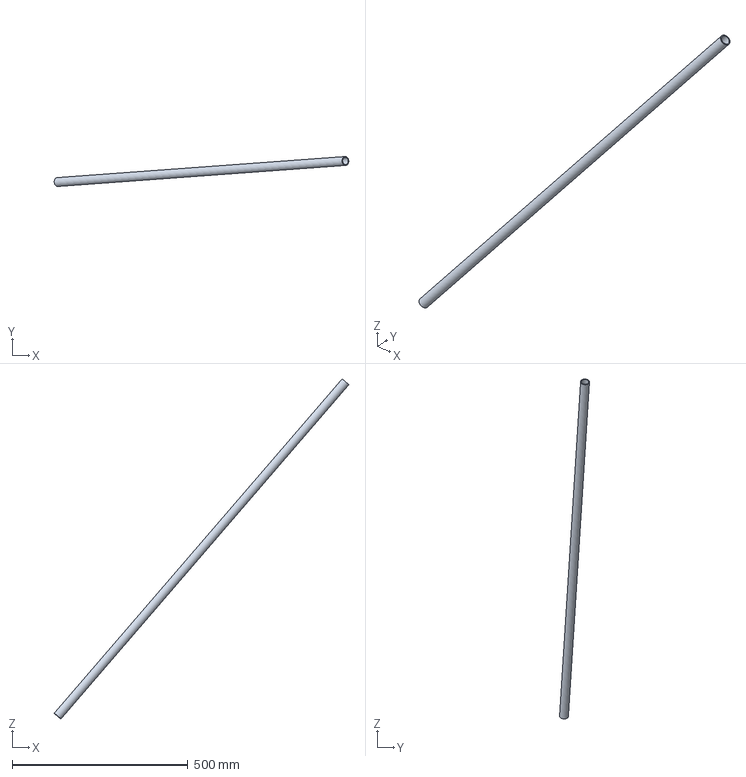
[picture p3: CAD file, 2026-10-11]
history/frame_v5_49.4kg/cad/parts/NM26-FRM-071_tube_A_Main_hoop_brace_R.step
839.3 x 85.4 x 968.6 mm
