udayjain2102/nittanymotorsports/history/frame_v5_49.4kg/cad/parts/NM26-FRM-011_tube_J_Main_hoop_R_3of4.step

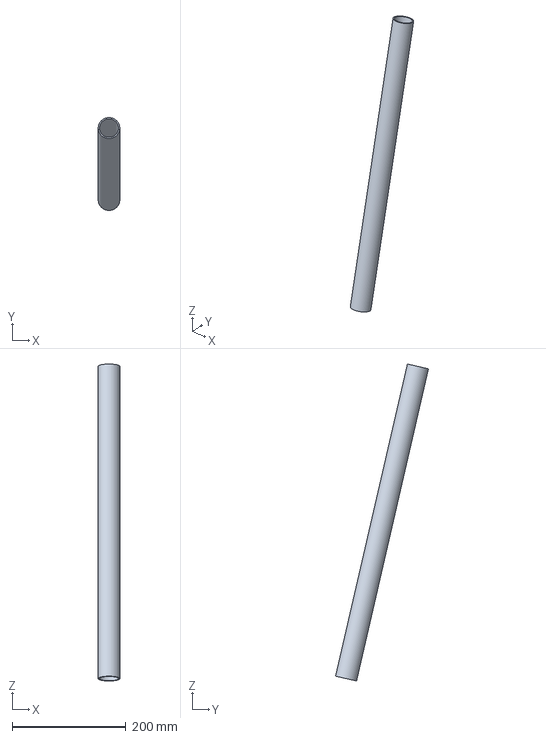
[picture p4: CAD file, 2026-10-11]
history/frame_v5_49.4kg/cad/parts/NM26-FRM-011_tube_J_Main_hoop_R_3of4.step
38.1 x 163.8 x 558.5 mm
