udayjain2102/nittanymotorsports/history/frame_v1_50.1kg/cad/parts/NM26-FRM-073_tube_A_Main_hoop_brace_R.step

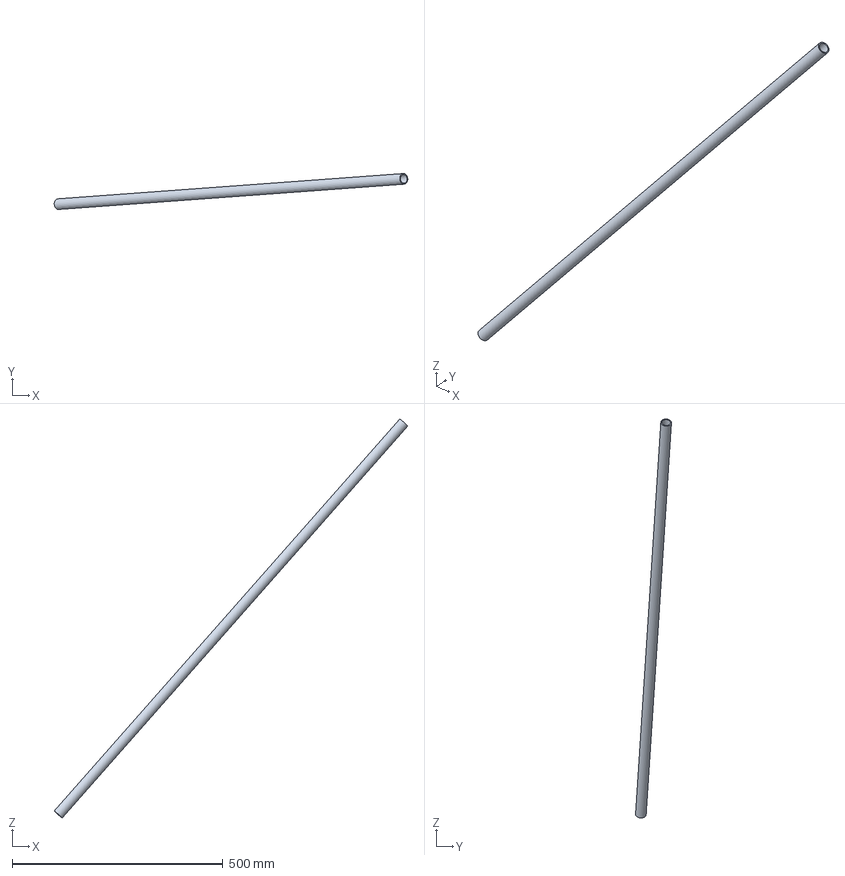
[picture p5: CAD file, 2026-09-30]
history/frame_v1_50.1kg/cad/parts/NM26-FRM-073_tube_A_Main_hoop_brace_R.step
839.1 x 85.4 x 946.8 mm
