udayjain2102/nittanymotorsports/history/frame_v5_49.4kg/cad/parts/NM26-FRM-106_tube_H_Main_hoop_mid_cross_-_firewall_+_top_engine_mounts_L.step

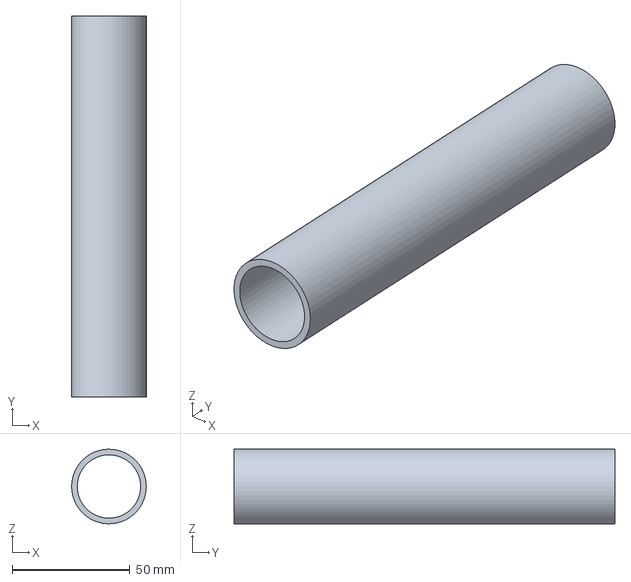
[picture p6: CAD file, 2026-10-11]
history/frame_v5_49.4kg/cad/parts/NM26-FRM-106_tube_H_Main_hoop_mid_cross_-_firewall_+_top_engine_mounts_L.step
31.7 x 162.0 x 31.7 mm
