udayjain2102/nittanymotorsports/history/frame_v1_50.1kg/cad/parts/NM26-FRM-011_tube_H_Main_hoop_R_3of4.step

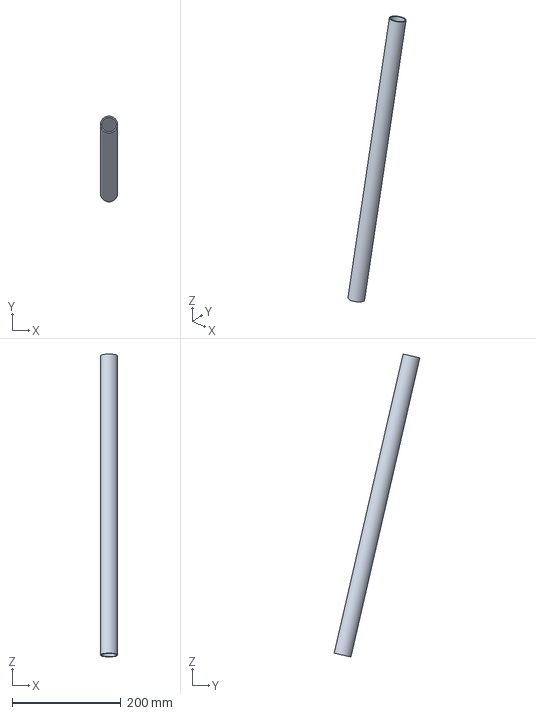
[picture p7: CAD file, 2026-09-30]
history/frame_v1_50.1kg/cad/parts/NM26-FRM-011_tube_H_Main_hoop_R_3of4.step
31.7 x 157.6 x 557.1 mm
