udayjain2102/nittanymotorsports/history/frame_v1_50.1kg/cad/parts/NM26-FRM-119_tube_A_Main_hoop_base_cross_+_front_engine_mounts_R.step

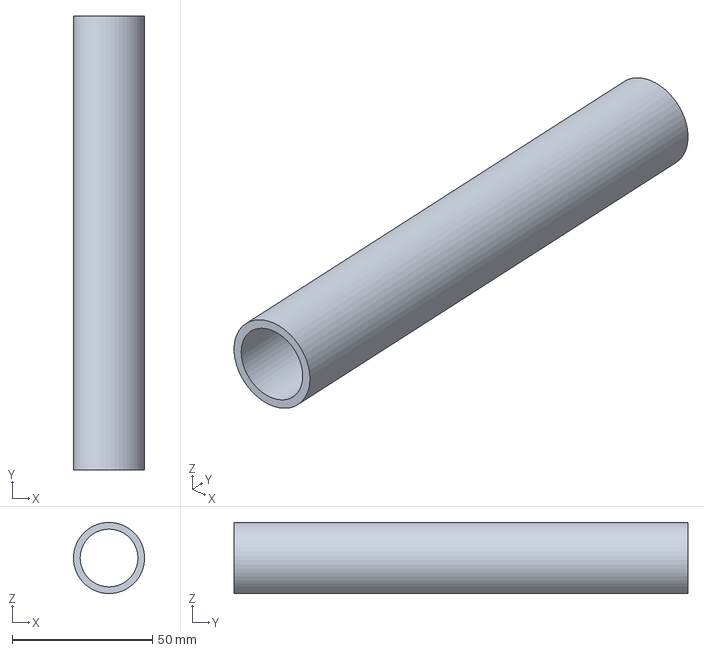
[picture p8: CAD file, 2026-09-30]
history/frame_v1_50.1kg/cad/parts/NM26-FRM-119_tube_A_Main_hoop_base_cross_+_front_engine_mounts_R.step
25.4 x 162.0 x 25.4 mm
