udayjain2102/nittanymotorsports/history/frame_v1_50.1kg/cad/parts/NM26-FRM-010_tube_H_Main_hoop_L_2of4.step

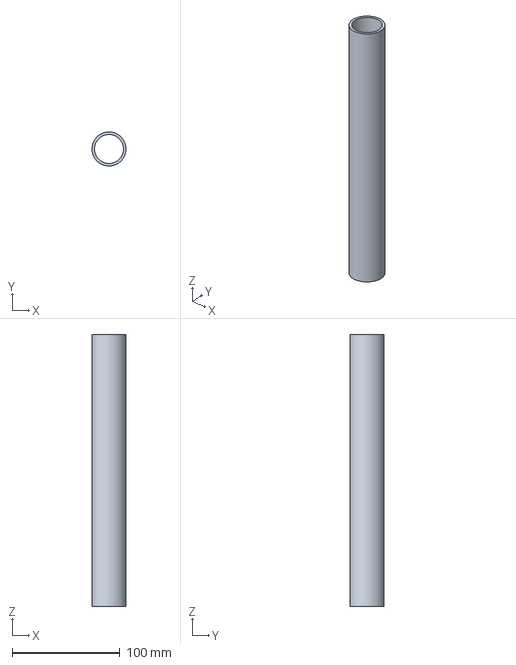
[picture p9: CAD file, 2026-09-30]
history/frame_v1_50.1kg/cad/parts/NM26-FRM-010_tube_H_Main_hoop_L_2of4.step
31.7 x 31.7 x 253.0 mm
