udayjain2102/nittanymotorsports/history/frame_v5_49.4kg/cad/parts/NM26-FRM-008_tube_J_Main_hoop_L_1of4.step

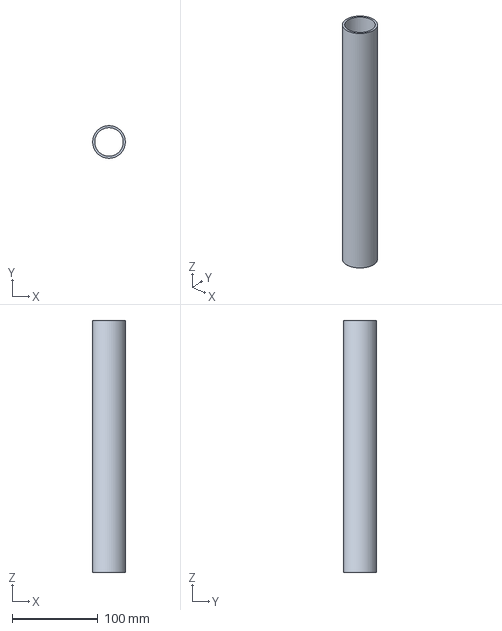
[picture p10: CAD file, 2026-10-11]
history/frame_v5_49.4kg/cad/parts/NM26-FRM-008_tube_J_Main_hoop_L_1of4.step
38.1 x 38.1 x 294.0 mm
