udayjain2102/nittanymotorsports/history/frame_v5_49.4kg/cad/parts/NM26-FRM-111_tube_H_Main_hoop_base_cross_+_front_engine_mounts_C.step

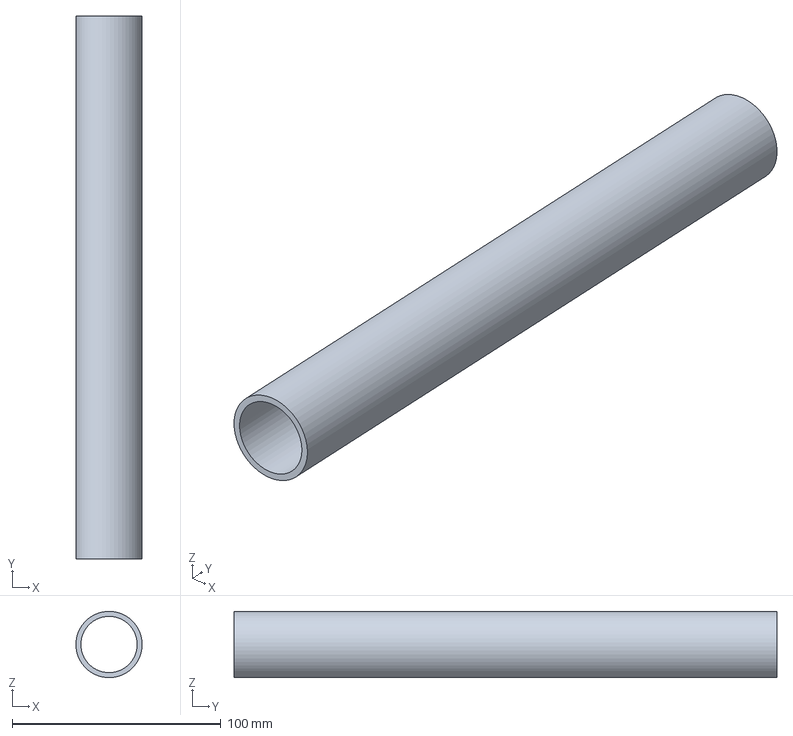
[picture p11: CAD file, 2026-10-11]
history/frame_v5_49.4kg/cad/parts/NM26-FRM-111_tube_H_Main_hoop_base_cross_+_front_engine_mounts_C.step
31.7 x 260.0 x 31.7 mm
