udayjain2102/nittanymotorsports/history/frame_v1_50.1kg/cad/parts/NM26-FRM-130_tube_A_Main_hoop_base_cross_+_front_engine_mounts_C.step

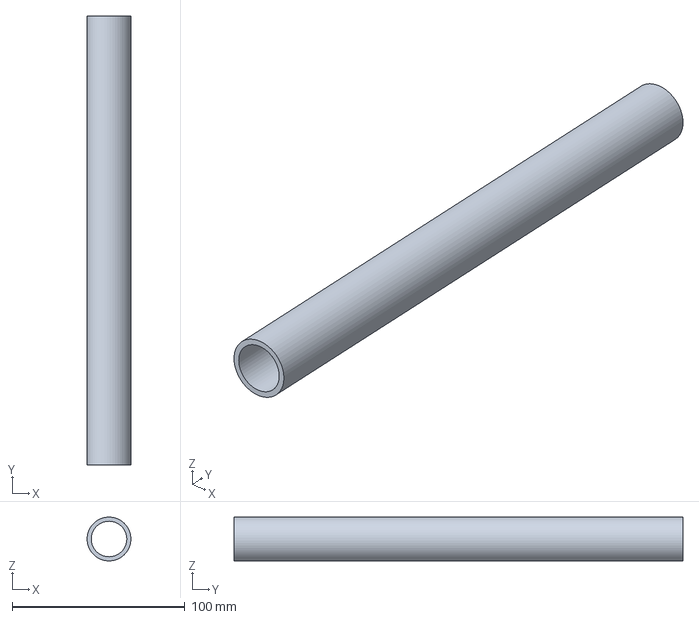
[picture p12: CAD file, 2026-09-30]
history/frame_v1_50.1kg/cad/parts/NM26-FRM-130_tube_A_Main_hoop_base_cross_+_front_engine_mounts_C.step
25.4 x 260.0 x 25.4 mm
