udayjain2102/nittanymotorsports/history/frame_v5_49.4kg/cad/parts/NM26-FRM-091_tube_C_Main_hoop_bend_support_R.step

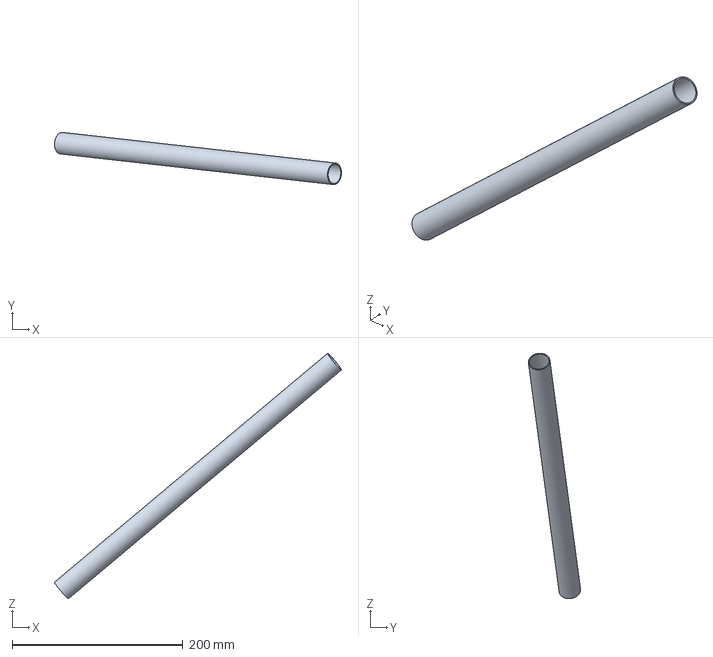
[picture p13: CAD file, 2026-10-11]
history/frame_v5_49.4kg/cad/parts/NM26-FRM-091_tube_C_Main_hoop_bend_support_R.step
336.4 x 61.2 x 287.7 mm
