udayjain2102/nittanymotorsports/history/frame_v1_50.1kg/cad/parts/NM26-AER-001_rear_wing_main_plane.step

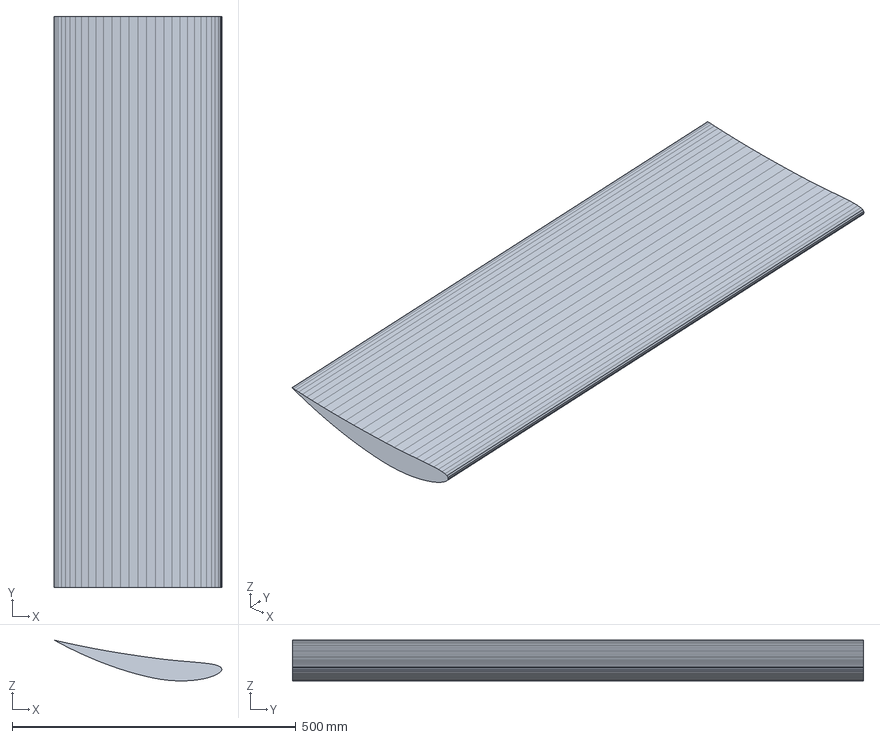
[picture p14: CAD file, 2026-09-30]
history/frame_v1_50.1kg/cad/parts/NM26-AER-001_rear_wing_main_plane.step
295.4 x 1006.0 x 72.0 mm
