udayjain2102/nittanymotorsports/history/frame_v5_49.4kg/cad/parts/NM26-FRM-013_tube_J_Main_hoop_R_4of4.step

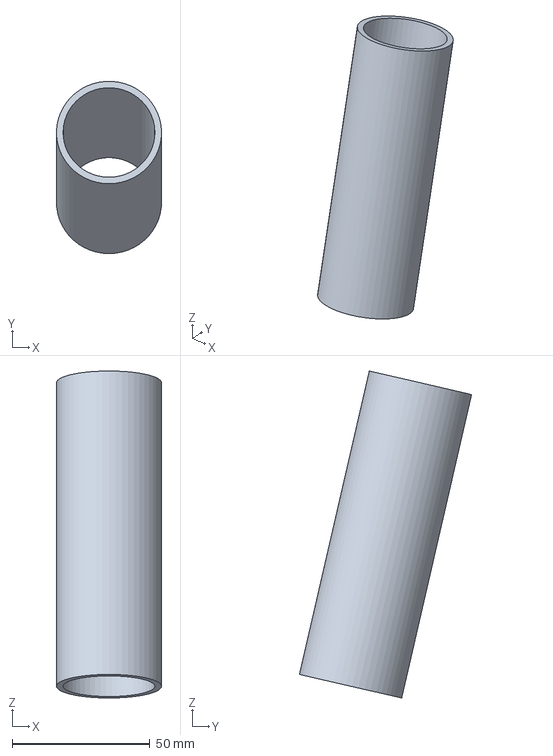
[picture p16: CAD file, 2026-10-11]
history/frame_v5_49.4kg/cad/parts/NM26-FRM-013_tube_J_Main_hoop_R_4of4.step
38.1 x 62.4 x 118.5 mm
