udayjain2102/nittanymotorsports/history/frame_v1_50.1kg/cad/parts/NM26-FRM-013_tube_H_Main_hoop_R_4of4.step

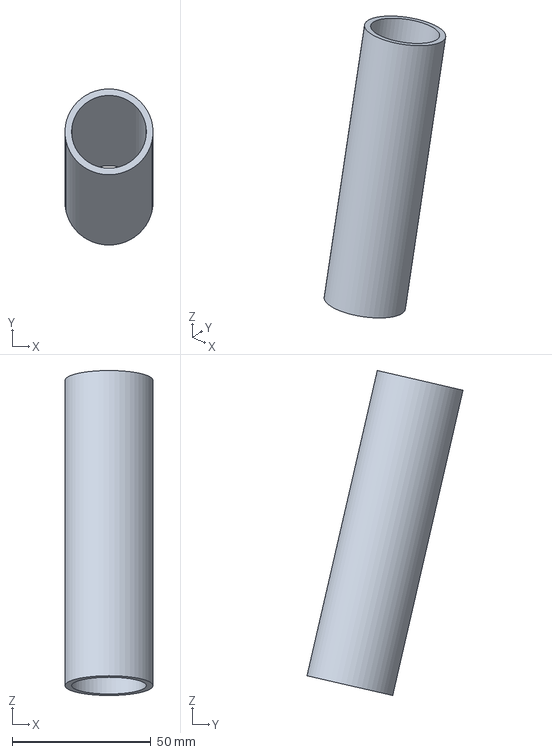
[picture p17: CAD file, 2026-09-30]
history/frame_v1_50.1kg/cad/parts/NM26-FRM-013_tube_H_Main_hoop_R_4of4.step
31.7 x 56.2 x 117.1 mm
