udayjain2102/nittanymotorsports/history/frame_v5_49.4kg/cad/parts/NM26-FRM-112_tube_J_Main_hoop_C.step

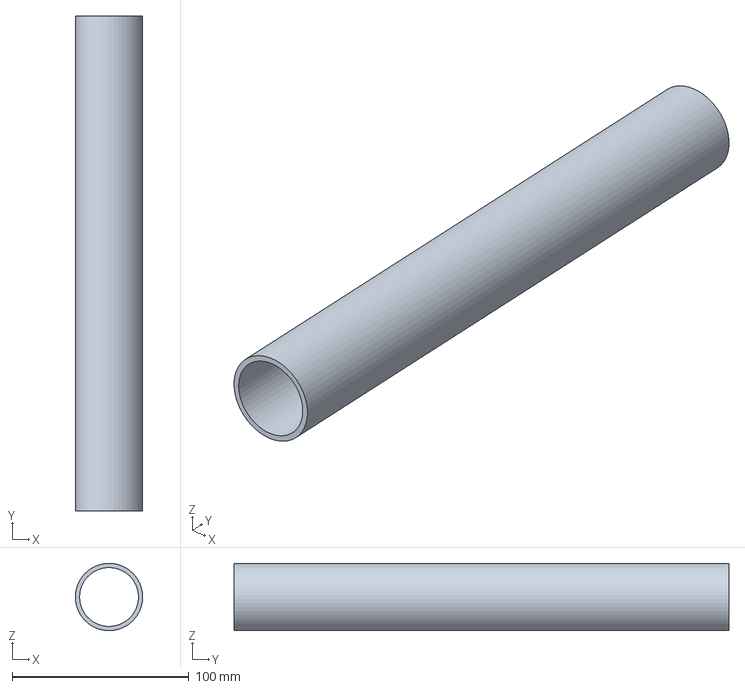
[picture p18: CAD file, 2026-10-11]
history/frame_v5_49.4kg/cad/parts/NM26-FRM-112_tube_J_Main_hoop_C.step
38.1 x 280.0 x 38.1 mm
