udayjain2102/nittanymotorsports/history/frame_v1_50.1kg/cad/parts/NM26-AER-006_wing_brace_to_main_hoop_R.step

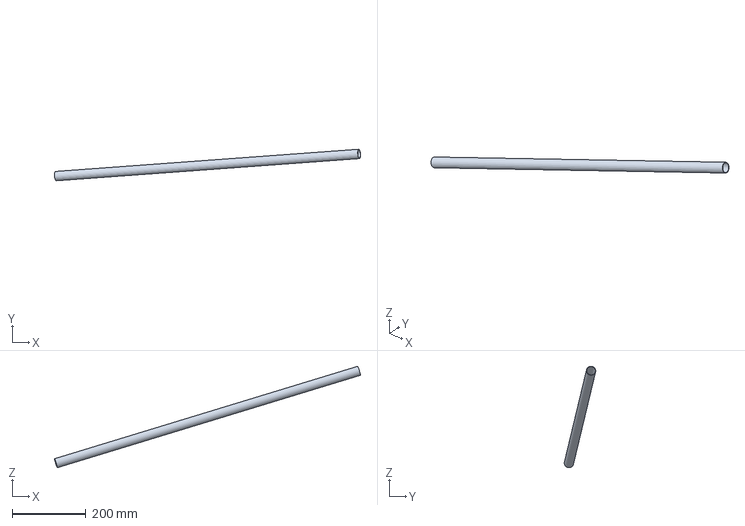
[picture p19: CAD file, 2026-09-30]
history/frame_v1_50.1kg/cad/parts/NM26-AER-006_wing_brace_to_main_hoop_R.step
827.6 x 85.3 x 274.3 mm
