udayjain2102/nittanymotorsports/history/frame_v1_50.1kg/cad/parts/NM26-FRM-008_tube_H_Main_hoop_L_1of4.step

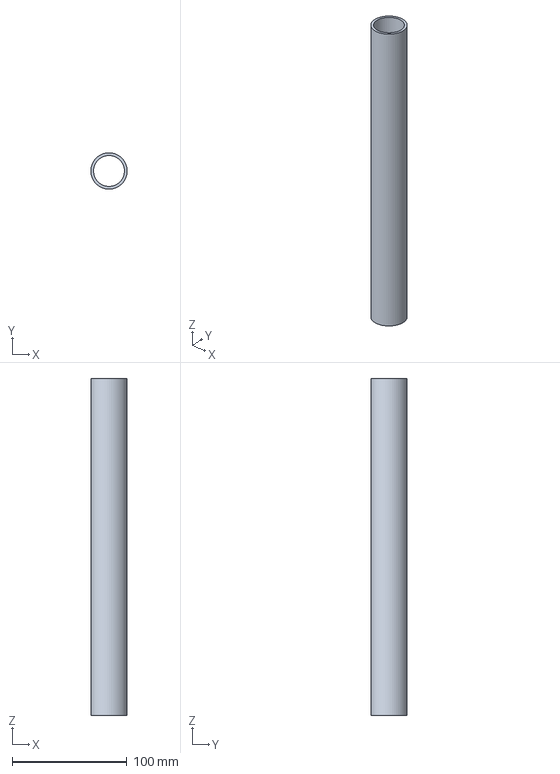
[picture p20: CAD file, 2026-09-30]
history/frame_v1_50.1kg/cad/parts/NM26-FRM-008_tube_H_Main_hoop_L_1of4.step
31.7 x 31.7 x 294.0 mm
