udayjain2102/nittanymotorsports/history/frame_v1_50.1kg/cad/parts/NM26-FRM-131_tube_H_Main_hoop_C.step

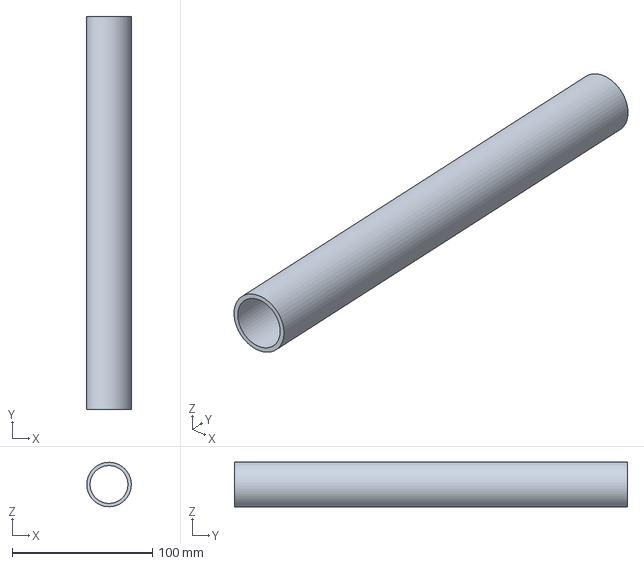
[picture p21: CAD file, 2026-09-30]
history/frame_v1_50.1kg/cad/parts/NM26-FRM-131_tube_H_Main_hoop_C.step
31.7 x 280.0 x 31.7 mm
