udayjain2102/nittanymotorsports/history/frame_v5_49.4kg/cad/parts/NM26-FRM-074_tube_B_Main_hoop_brace_L.step

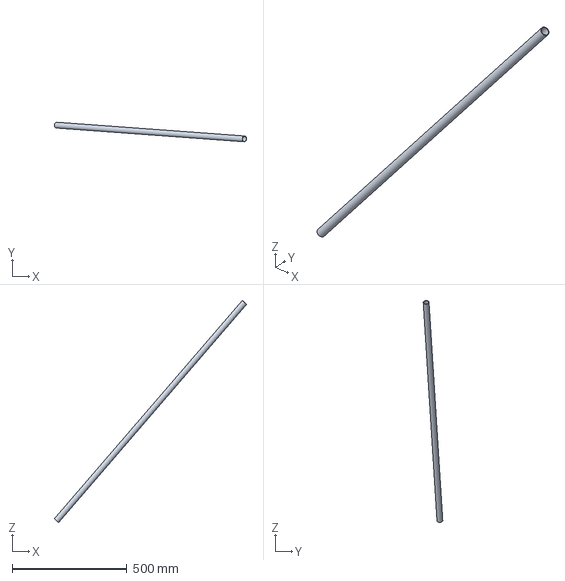
[picture p22: CAD file, 2026-10-01]
history/frame_v5_49.4kg/cad/parts/NM26-FRM-074_tube_B_Main_hoop_brace_L.step
839.3 x 85.4 x 968.6 mm
