udayjain2102/nittanymotorsports/history/frame_v1_50.1kg/cad/parts/NM26-FRM-057_tube_C_FBH_support_lower_R.step

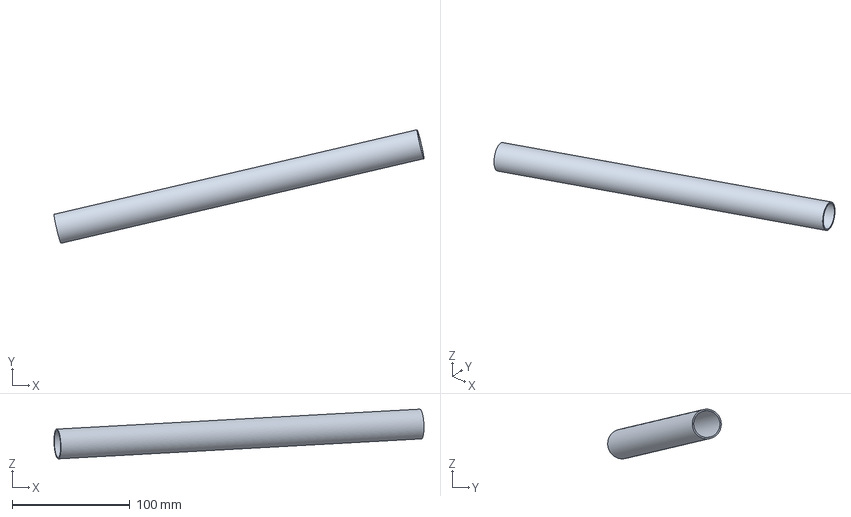
[picture p23: CAD file, 2026-09-30]
history/frame_v1_50.1kg/cad/parts/NM26-FRM-057_tube_C_FBH_support_lower_R.step
314.9 x 96.7 x 42.4 mm
