udayjain2102/nittanymotorsports/history/frame_v5_49.4kg/cad/parts/NM26-FRM-067_tube_J_Front_susp_ring_R_2of3.step

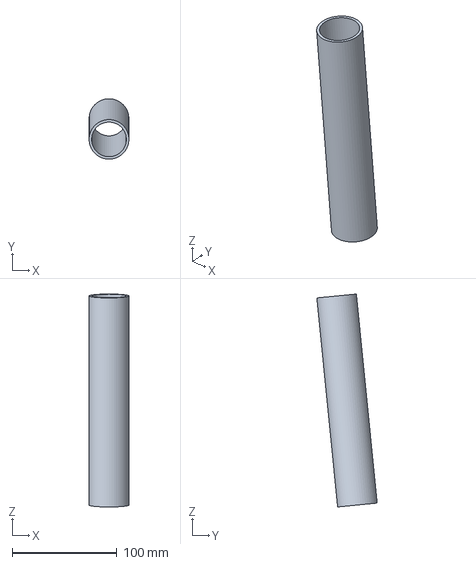
[picture p24: CAD file, 2026-10-11]
history/frame_v5_49.4kg/cad/parts/NM26-FRM-067_tube_J_Front_susp_ring_R_2of3.step
38.1 x 57.8 x 203.8 mm
