udayjain2102/nittanymotorsports/history/frame_v5_49.4kg/cad/simple/NM26_Mule.step

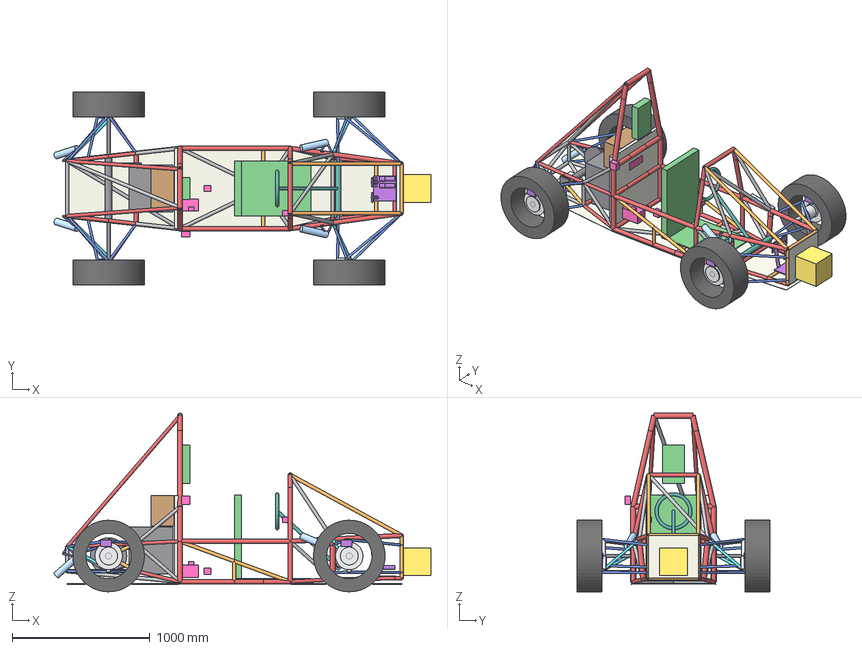
[picture p25: CAD file, 2026-10-11]
history/frame_v5_49.4kg/cad/simple/NM26_Mule.step
2741.3 x 1400.0 x 1298.9 mm
NM26-FRM-001_frame_size_J
NM26-FRM-002_frame_size_H
NM26-FRM-003_frame_size_A
NM26-FRM-004_frame_size_B
NM26-FRM-005_frame_size_C
NM26-WHL-001_tire_front_R
NM26-UPR-001_upright_front_R
NM26-UPR-002_hub_front_R
NM26-UPR-003_rotor_front_R
NM26-BRK-001_caliper_front_R
NM26-SUS-001_lower_ring_lsus_front_R
NM26-SUS-002_lower_bh_lsus_front_R
NM26-SUS-003_upper_ring_sus_front_R
NM26-SUS-004_upper_bh_sus_front_R
NM26-SUS-005_steer_front_R
NM26-SUS-006_pushrod_front_R
NM26-WHL-002_tire_front_L
NM26-UPR-004_upright_front_L
NM26-UPR-005_hub_front_L
NM26-UPR-006_rotor_front_L
NM26-BRK-002_caliper_front_L
NM26-SUS-007_lower_ring_lsus_front_L
NM26-SUS-008_lower_bh_lsus_front_L
NM26-SUS-009_upper_ring_sus_front_L
NM26-SUS-010_upper_bh_sus_front_L
NM26-SUS-011_steer_front_L
NM26-SUS-012_pushrod_front_L
NM26-WHL-003_tire_rear_R
NM26-UPR-007_upright_rear_R
NM26-UPR-008_hub_rear_R
NM26-UPR-009_rotor_rear_R
NM26-BRK-003_caliper_rear_R
NM26-SUS-013_lower_rr_bot_rear_R
NM26-SUS-014_lower_r_bot_rear_R
NM26-SUS-015_upper_rr_top_rear_R
NM26-SUS-016_upper_r_top_rear_R
NM26-SUS-017_steer_rear_R
NM26-SUS-018_pushrod_rear_R
NM26-WHL-004_tire_rear_L
NM26-UPR-010_upright_rear_L
NM26-UPR-011_hub_rear_L
NM26-UPR-012_rotor_rear_L
NM26-BRK-004_caliper_rear_L
NM26-SUS-019_lower_rr_bot_rear_L
NM26-SUS-020_lower_r_bot_rear_L
NM26-SUS-021_upper_rr_top_rear_L
NM26-SUS-022_upper_r_top_rear_L
NM26-SUS-023_steer_rear_L
NM26-SUS-024_pushrod_rear_L
NM26-SUS-025_rocker_front_R_arm_pushrod
NM26-SUS-026_rocker_front_R_arm_shock
NM26-SUS-027_rocker_front_R_arm_tie
NM26-SUS-028_shock_front_R
NM26-SUS-029_rocker_front_L_arm_pushrod
NM26-SUS-030_rocker_front_L_arm_shock
NM26-SUS-031_rocker_front_L_arm_tie
NM26-SUS-032_shock_front_L
NM26-SUS-033_rocker_rear_R_arm_pushrod
NM26-SUS-034_rocker_rear_R_arm_shock
NM26-SUS-035_rocker_rear_R_arm_tie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
