udayjain2102/nittanymotorsports/history/frame_v5_49.4kg/fusion_gd/NM26_GD_obstacles.step

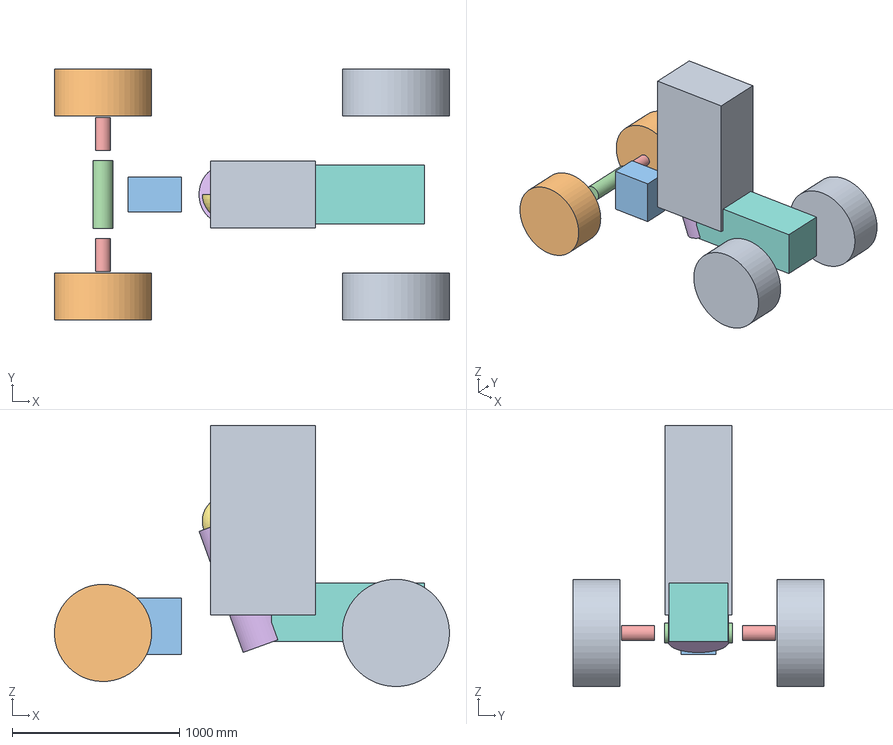
[picture p26: CAD file, 2026-10-01]
history/frame_v5_49.4kg/fusion_gd/NM26_GD_obstacles.step
2360.4 x 1500.0 x 1559.8 mm
wheel_front_R
wheel_front_L
wheel_rear_R
wheel_rear_L
engine_envelope
rear_spool
rear_cv_shaft_R
rear_cv_shaft_L
driver_torso
driver_head
driver_legs_T12
cockpit_opening_T11
