udayjain2102/nittanymotorsports/history/frame_v5_49.4kg/quote/NM26_Frame_Weldment.step

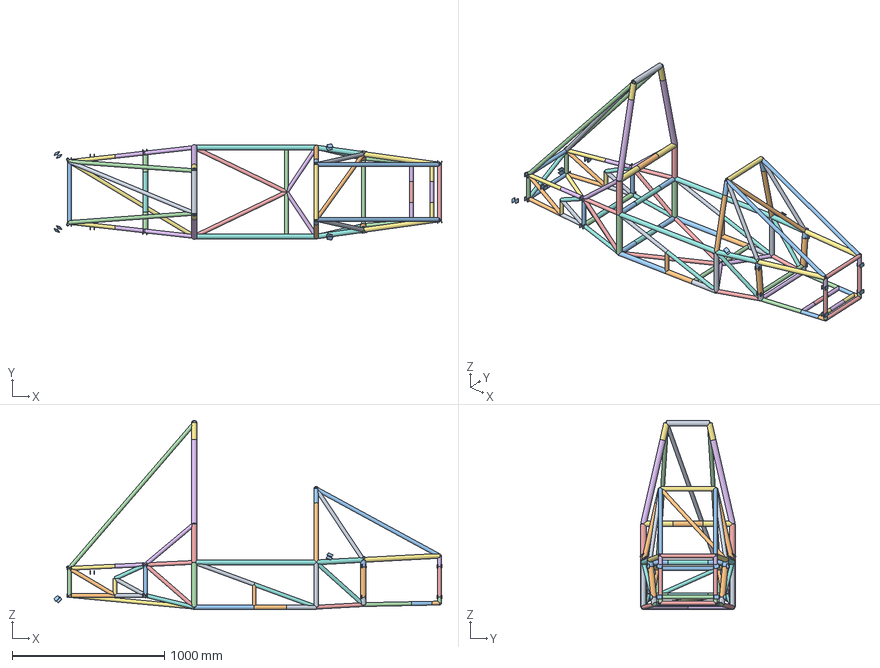
[picture p27: CAD file, 2026-10-11]
history/frame_v5_49.4kg/quote/NM26_Frame_Weldment.step
2547.0 x 633.4 x 1241.9 mm
NM26-FRM-001_tube_H_Front_hoop_R_1of3
NM26-FRM-002_tube_H_Front_hoop_L_1of3
NM26-FRM-003_tube_H_Front_hoop_R_2of3
NM26-FRM-004_tube_H_Front_hoop_L_2of3
NM26-FRM-005_tube_H_Front_hoop_R_3of3
NM26-FRM-006_tube_H_Front_hoop_L_3of3
NM26-FRM-007_tube_J_Main_hoop_R_1of4
NM26-FRM-008_tube_J_Main_hoop_L_1of4
NM26-FRM-009_tube_J_Main_hoop_R_2of4
NM26-FRM-010_tube_J_Main_hoop_L_2of4
NM26-FRM-011_tube_J_Main_hoop_R_3of4
NM26-FRM-012_tube_J_Main_hoop_L_3of4
NM26-FRM-013_tube_J_Main_hoop_R_4of4
NM26-FRM-014_tube_J_Main_hoop_L_4of4
NM26-FRM-015_tube_H_Upper_side_impact_R
NM26-FRM-016_tube_H_Upper_side_impact_L
NM26-FRM-017_tube_H_Lower_side_impact_R_1of3
NM26-FRM-018_tube_H_Lower_side_impact_L_1of3
NM26-FRM-019_tube_H_Lower_side_impact_R_2of3
NM26-FRM-020_tube_H_Lower_side_impact_L_2of3
NM26-FRM-021_tube_H_Lower_side_impact_R_3of3
NM26-FRM-022_tube_H_Lower_side_impact_L_3of3
NM26-FRM-023_tube_B_Anti-sub_floor_cross_R
NM26-FRM-024_tube_B_Anti-sub_floor_cross_L
NM26-FRM-025_tube_C_Cockpit_floor_V_R_2of2
NM26-FRM-026_tube_C_Cockpit_floor_V_L_2of2
NM26-FRM-027_tube_C_Cockpit_floor_V_R_1of2
NM26-FRM-028_tube_C_Cockpit_floor_V_L_1of2
NM26-FRM-029_tube_J_Shoulder_harness_bar_R
NM26-FRM-030_tube_J_Shoulder_harness_bar_L
NM26-FRM-031_tube_B_Diagonal_side_impact_R_1of2
NM26-FRM-032_tube_B_Diagonal_side_impact_L_1of2
NM26-FRM-033_tube_B_Diagonal_side_impact_R_2of2
NM26-FRM-034_tube_B_Diagonal_side_impact_L_2of2
NM26-FRM-035_tube_B_Lap_belt_tab_brace_R
NM26-FRM-036_tube_B_Lap_belt_tab_brace_L
NM26-FRM-037_tube_B_Front_hoop_brace_R
NM26-FRM-038_tube_B_Front_hoop_brace_L
NM26-FRM-039_tube_B_Front_bulkhead_R_1of3
NM26-FRM-040_tube_B_Front_bulkhead_L_1of3
NM26-FRM-041_tube_B_Front_bulkhead_R_2of3
NM26-FRM-042_tube_B_Front_bulkhead_L_2of3
NM26-FRM-043_tube_B_Front_bulkhead_R_3of3
NM26-FRM-044_tube_B_Front_bulkhead_L_3of3
NM26-FRM-045_tube_H_FBH_support_upper_R_2of2
NM26-FRM-046_tube_H_FBH_support_upper_L_2of2
NM26-FRM-047_tube_H_FBH_support_upper_R_1of2
NM26-FRM-048_tube_H_FBH_support_upper_L_1of2
NM26-FRM-049_tube_C_Front_hoop_lower_brace_R
NM26-FRM-050_tube_C_Front_hoop_lower_brace_L
NM26-FRM-051_tube_A_FBH_support_lower_R_3of3
NM26-FRM-052_tube_A_FBH_support_lower_L_3of3
NM26-FRM-053_tube_A_FBH_support_lower_R_2of3
NM26-FRM-054_tube_A_FBH_support_lower_L_2of3
NM26-FRM-055_tube_A_FBH_support_lower_R_1of3
NM26-FRM-056_tube_A_FBH_support_lower_L_1of3
NM26-FRM-057_tube_A_FBH_support_lower_R
NM26-FRM-058_tube_A_FBH_support_lower_L
NM26-FRM-059_tube_B_Pedal_box_cross_R
NM26-FRM-060_tube_B_Pedal_box_cross_L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
