udayjain2102/nittanymotorsports/history/frame_v1_50.1kg/cad/parts/NM26-BRK-005_pedal_box.step

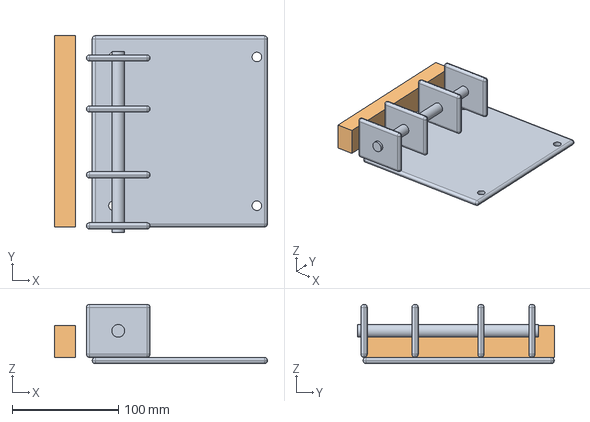
[picture p28: CAD file, 2026-09-30]
history/frame_v1_50.1kg/cad/parts/NM26-BRK-005_pedal_box.step
200.5 x 185.0 x 56.0 mm
