udayjain2102/nittanymotorsports/history/frame_v5_49.4kg/cad/parts/NM26-FRM-040_tube_B_Front_bulkhead_L_1of3.step

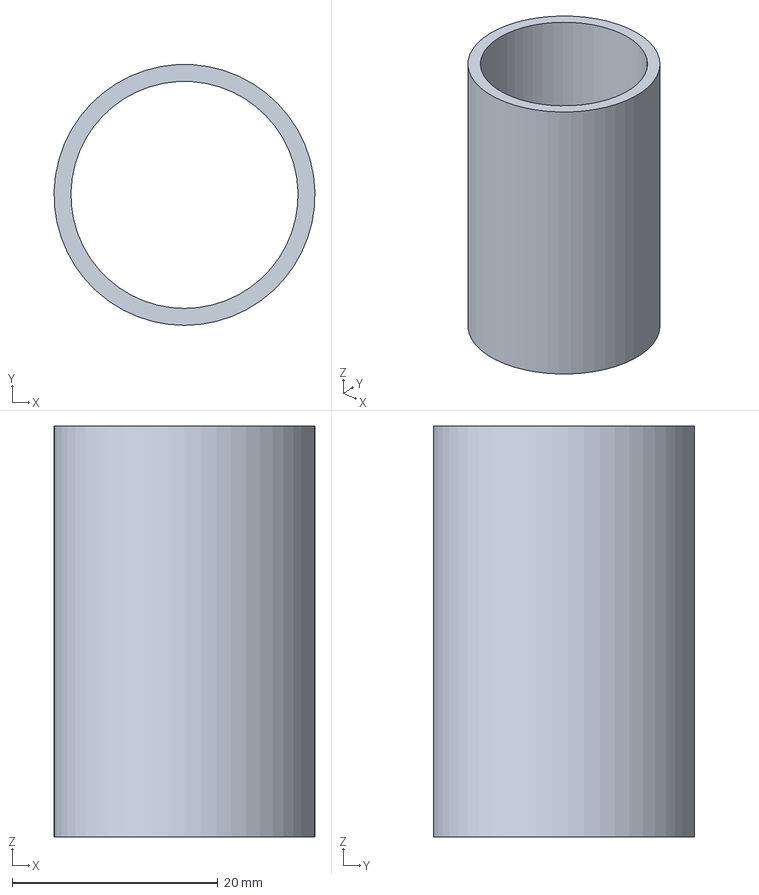
[picture p29: CAD file, 2026-10-11]
history/frame_v5_49.4kg/cad/parts/NM26-FRM-040_tube_B_Front_bulkhead_L_1of3.step
25.4 x 25.4 x 40.0 mm
