udayjain2102/nittanymotorsports/history/frame_v5_49.4kg/cad/simple/NM26_Frame_FEA.step

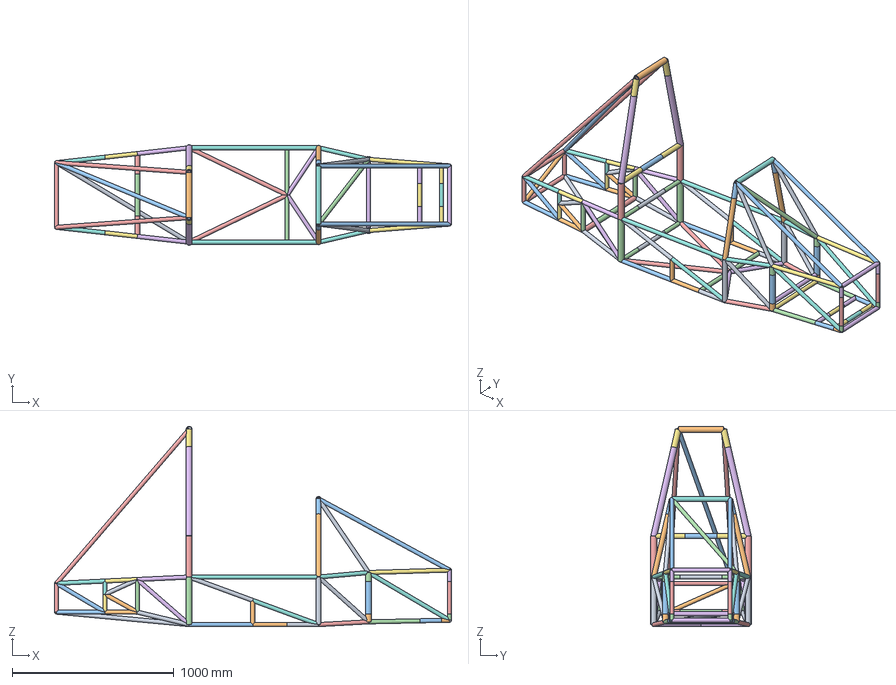
[picture p30: CAD file, 2026-10-01]
history/frame_v5_49.4kg/cad/simple/NM26_Frame_FEA.step
2455.4 x 622.1 x 1238.7 mm
