udayjain2102/nittanymotorsports/history/frame_v5_49.4kg/fusion_gd/NM26_GD_preserve.step

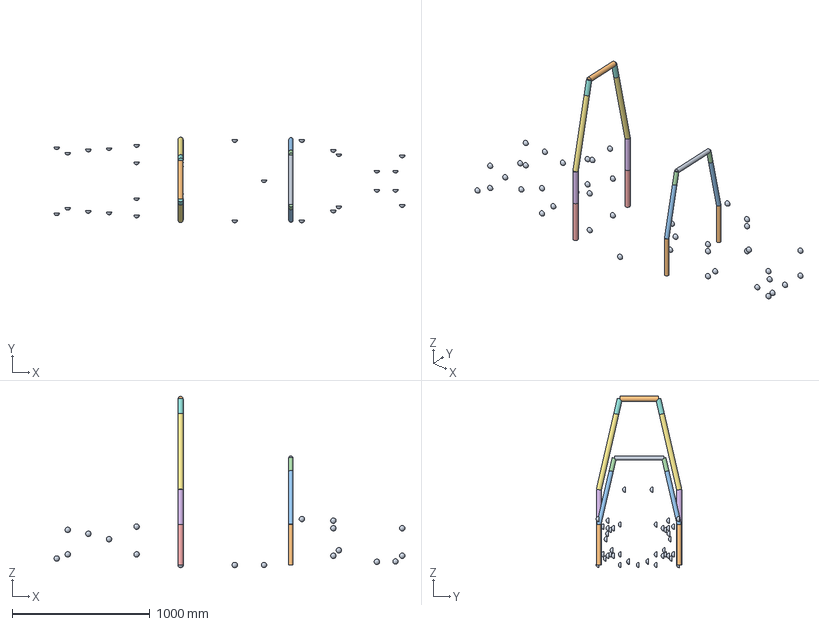
[picture p31: CAD file, 2026-10-01]
history/frame_v5_49.4kg/fusion_gd/NM26_GD_preserve.step
2550.0 x 623.0 x 1246.0 mm
front_pickup_ring_lsus_R
front_pickup_ring_lsus_L
front_pickup_bh_lsus_R
front_pickup_bh_lsus_L
front_pickup_ring_sus_R
front_pickup_ring_sus_L
front_pickup_bh_sus_R
front_pickup_bh_sus_L
front_rocker_pivot_R
front_rocker_pivot_L
front_shock_mount_R
front_shock_mount_L
rear_pickup_rr_bot_R
rear_pickup_rr_bot_L
rear_pickup_r_bot_R
rear_pickup_r_bot_L
rear_pickup_rr_top_R
rear_pickup_rr_top_L
rear_pickup_r_top_R
rear_pickup_r_top_L
rear_rocker_pivot_R
rear_rocker_pivot_L
rear_shock_mount_R
rear_shock_mount_L
rear_toe_link_R
rear_toe_link_L
rack_mount_R
rack_mount_L
mount_em_fb_R
mount_em_fb_L
mount_em_ft_R
mount_em_ft_L
mount_em_rb_R
mount_em_rb_L
mount_sb_R
mount_sb_L
mount_lap_R
mount_lap_L
mount_pb0m_R
mount_pb0m_L
mount_pb1m_R
mount_pb1m_L
mount_sp_c_R
mount_sp_c_L
mount_anti_sub
hoop_front_0
hoop_front_1
hoop_front_2
hoop_front_3
hoop_front_4
hoop_front_5
hoop_main_6
hoop_main_7
hoop_main_8
hoop_main_9
hoop_main_10
hoop_main_11
hoop_main_12
hoop_main_13
hoop_front_111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
