udayjain2102/nittanymotorsports/history/frame_v1_50.1kg/cad/parts/NM26-FRM-019_tube_B_Lower_side_impact_R_2of3.step

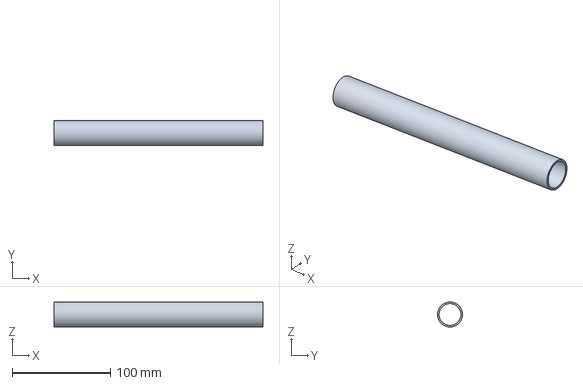
[picture p32: CAD file, 2026-09-30]
history/frame_v1_50.1kg/cad/parts/NM26-FRM-019_tube_B_Lower_side_impact_R_2of3.step
212.4 x 25.4 x 25.4 mm
