udayjain2102/nittanymotorsports/history/frame_v5_49.4kg/cad/parts/NM26-FRM-110_tube_H_Front_hoop_C.step

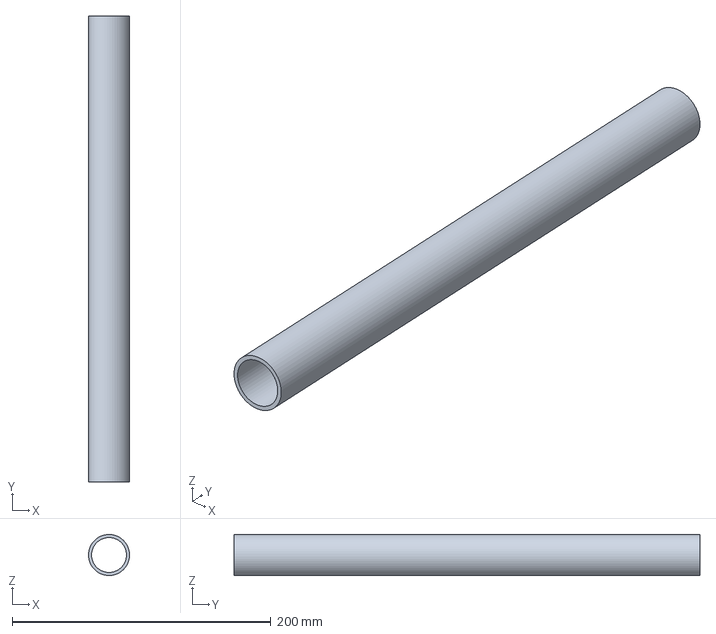
[picture p33: CAD file, 2026-10-11]
history/frame_v5_49.4kg/cad/parts/NM26-FRM-110_tube_H_Front_hoop_C.step
31.7 x 360.0 x 31.7 mm
