udayjain2102/nittanymotorsports/history/frame_v1_50.1kg/cad/parts/NM26-FRM-088_tube_H_Rear_susp_ring_L_1of3.step

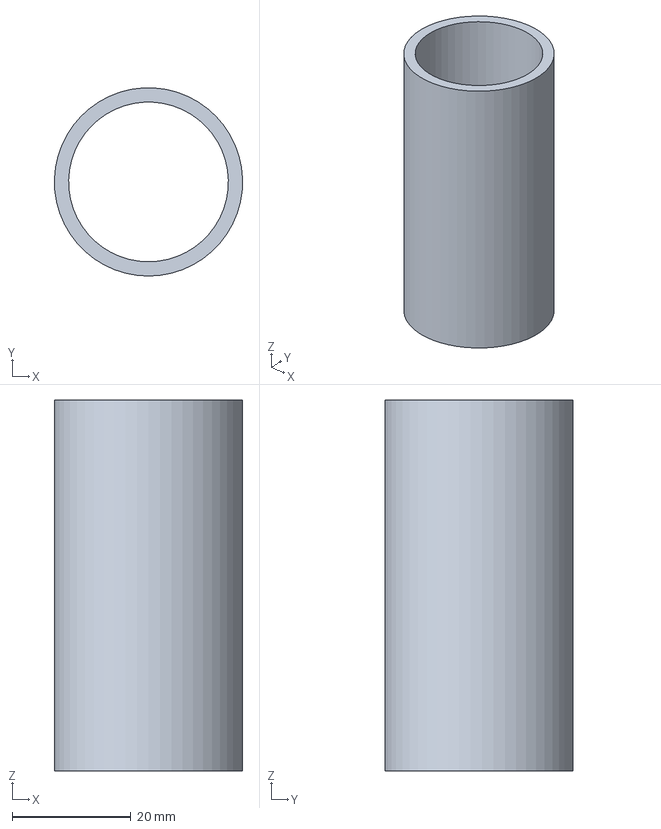
[picture p34: CAD file, 2026-09-30]
history/frame_v1_50.1kg/cad/parts/NM26-FRM-088_tube_H_Rear_susp_ring_L_1of3.step
31.7 x 31.7 x 62.6 mm
