udayjain2102/nittanymotorsports/history/frame_v5_49.4kg/cad/parts/NM26-BRK-011_master_cyl_rear_0.812in.step

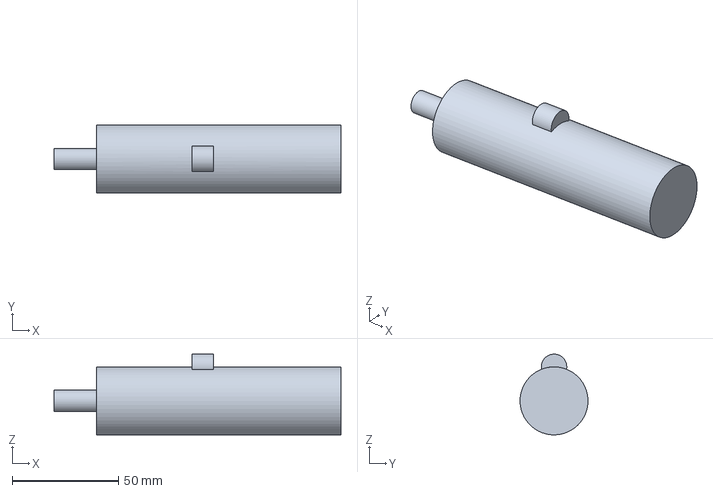
[picture p35: CAD file, 2026-10-11]
history/frame_v5_49.4kg/cad/parts/NM26-BRK-011_master_cyl_rear_0.812in.step
135.0 x 32.0 x 38.0 mm
