udayjain2102/nittanymotorsports/history/frame_v1_50.1kg/cad/parts/NM26-SUS-007_lower_a_arm_front_L.step

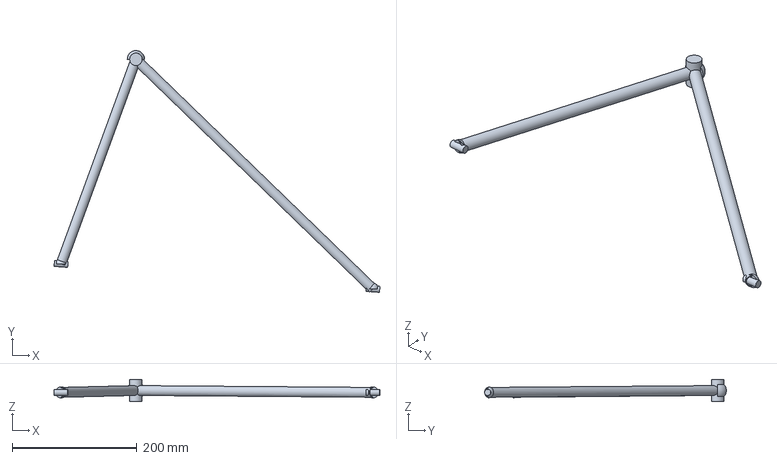
[picture p36: CAD file, 2026-09-30]
history/frame_v1_50.1kg/cad/parts/NM26-SUS-007_lower_a_arm_front_L.step
522.7 x 387.8 x 36.0 mm
