udayjain2102/nittanymotorsports/history/frame_v5_49.4kg/cad/parts/NM26-FRM-125_pickup_tab_front_lower_wishbone_at_front_ring_R.step

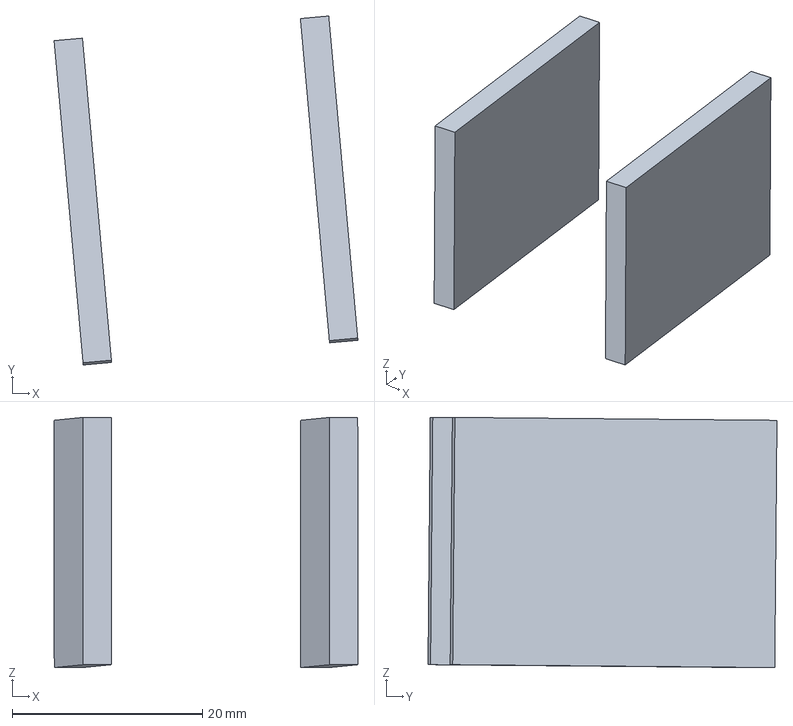
[picture p37: CAD file, 2026-10-11]
history/frame_v5_49.4kg/cad/parts/NM26-FRM-125_pickup_tab_front_lower_wishbone_at_front_ring_R.step
32.0 x 36.7 x 26.3 mm
