udayjain2102/nittanymotorsports/history/frame_v1_50.1kg/cad/parts/NM26-FRM-076_tube_B_MH_brace_support_upper_L_3of3.step

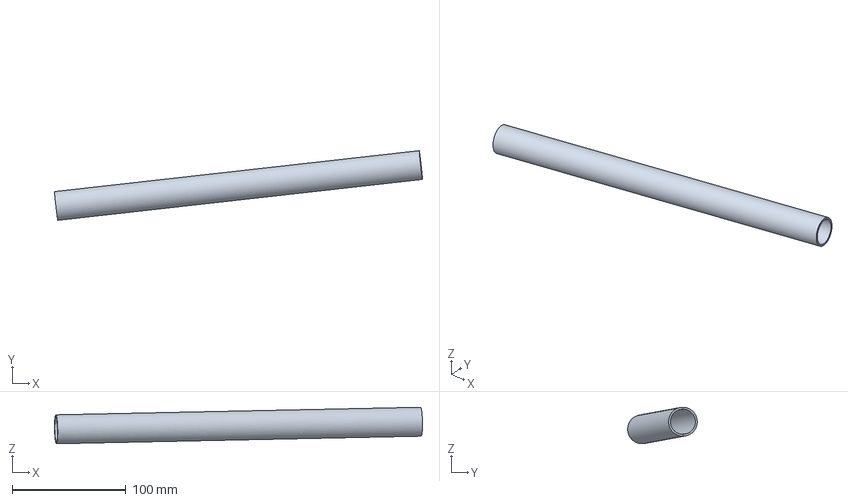
[picture p38: CAD file, 2026-09-30]
history/frame_v1_50.1kg/cad/parts/NM26-FRM-076_tube_B_MH_brace_support_upper_L_3of3.step
322.9 x 61.1 x 32.0 mm
