udayjain2102/nittanymotorsports/history/frame_v5_49.4kg/cad/parts/NM26-RTG-012_wire_inertia_switch_to_kill_relay.step

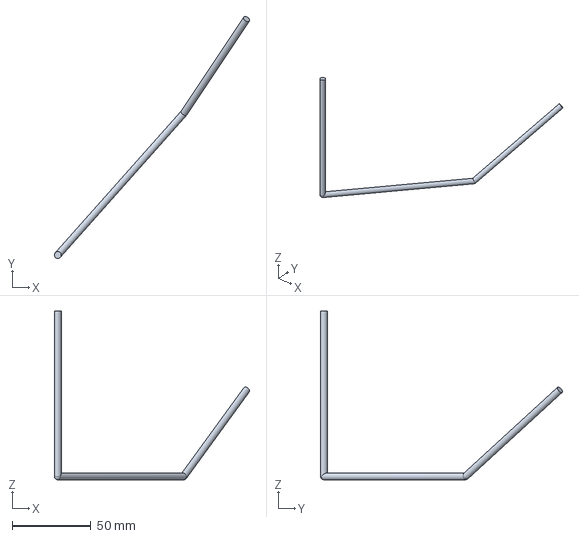
[picture p39: CAD file, 2026-10-11]
history/frame_v5_49.4kg/cad/parts/NM26-RTG-012_wire_inertia_switch_to_kill_relay.step
124.2 x 153.8 x 107.2 mm
