udayjain2102/nittanymotorsports/history/frame_v1_50.1kg/cad/parts/NM26-FRM-089_tube_H_Rear_susp_ring_R_2of3.step

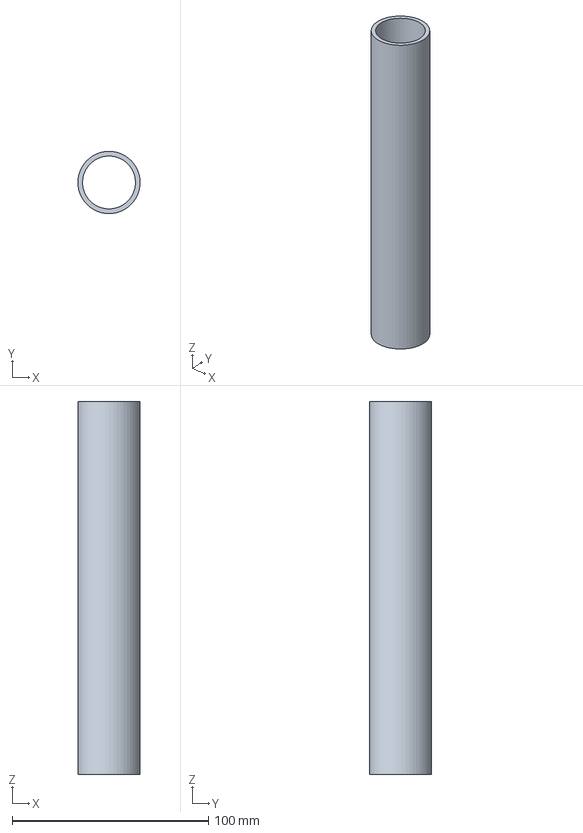
[picture p40: CAD file, 2026-09-30]
history/frame_v1_50.1kg/cad/parts/NM26-FRM-089_tube_H_Rear_susp_ring_R_2of3.step
31.7 x 31.7 x 190.0 mm
