udayjain2102/nittanymotorsports/history/frame_v5_49.4kg/cad/parts/NM26-RTG-017_wire_primary_master_switch_to_starter.step

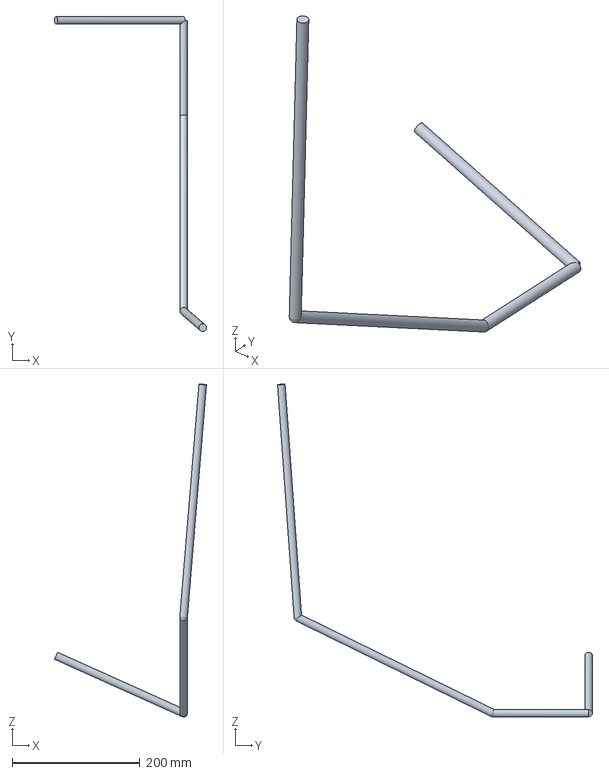
[picture p41: CAD file, 2026-10-11]
history/frame_v5_49.4kg/cad/parts/NM26-RTG-017_wire_primary_master_switch_to_starter.step
238.4 x 494.0 x 522.1 mm
