udayjain2102/nittanymotorsports/history/frame_v1_50.1kg/cad/parts/NM26-STR-001_steering_wheel.step

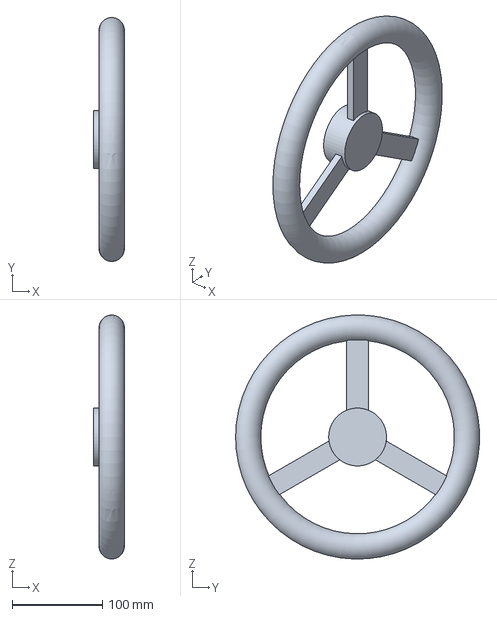
[picture p42: CAD file, 2026-09-30]
history/frame_v1_50.1kg/cad/parts/NM26-STR-001_steering_wheel.step
34.0 x 269.8 x 269.9 mm
