udayjain2102/nittanymotorsports/history/frame_v5_49.4kg/cad/parts/NM26-FRM-109_tube_A_Lower_FBH_support_cross_C.step

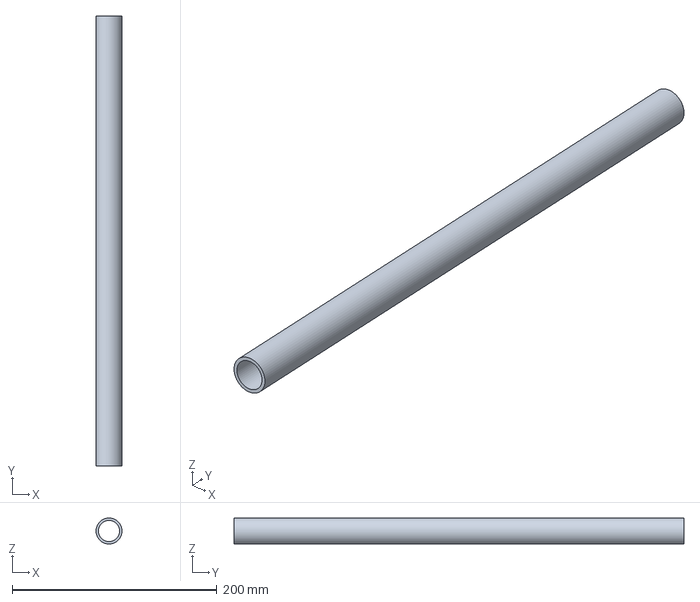
[picture p43: CAD file, 2026-10-11]
history/frame_v5_49.4kg/cad/parts/NM26-FRM-109_tube_A_Lower_FBH_support_cross_C.step
25.4 x 440.0 x 25.4 mm
