udayjain2102/nittanymotorsports/history/frame_v1_50.1kg/cad/parts/NM26-PWT-012_engine_starter_motor.step

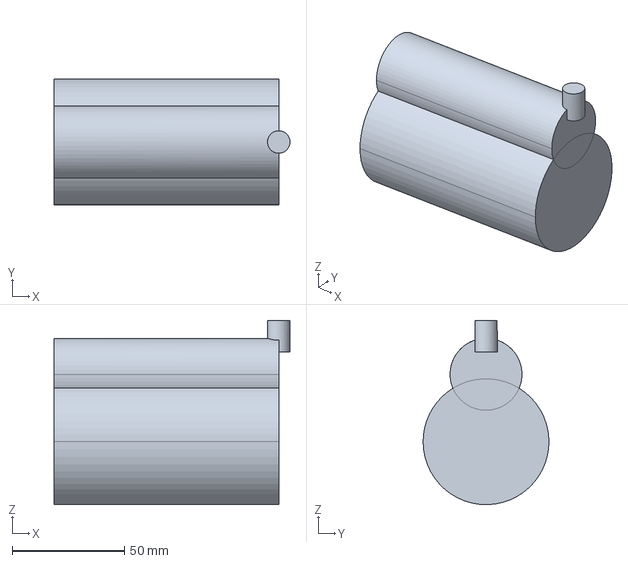
[picture p44: CAD file, 2026-09-30]
history/frame_v1_50.1kg/cad/parts/NM26-PWT-012_engine_starter_motor.step
105.0 x 56.0 x 82.0 mm
