udayjain2102/nittanymotorsports/history/frame_v5_49.4kg/cad/parts/NM26-FRM-117_tube_C_Front_pickup_cross_C.step

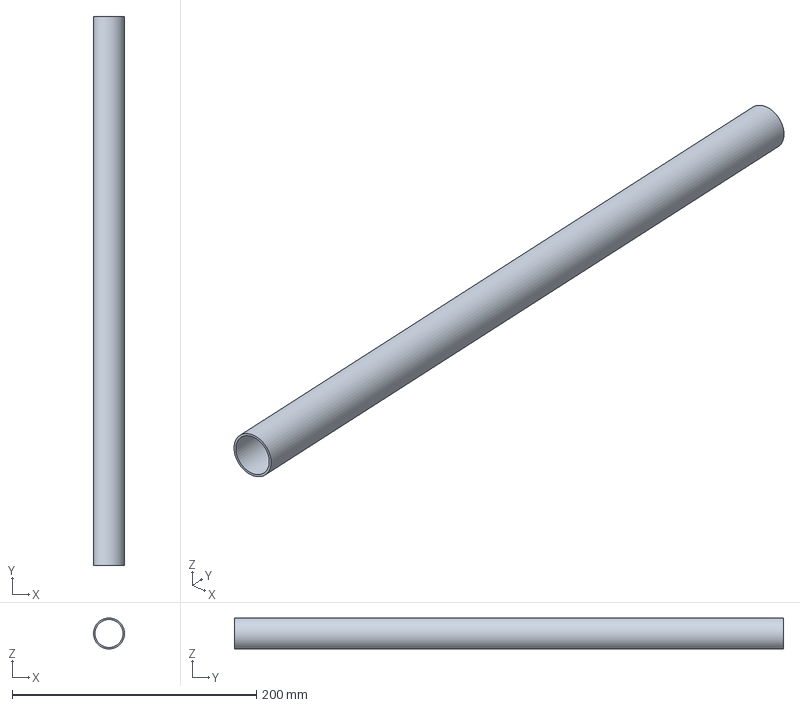
[picture p45: CAD file, 2026-10-11]
history/frame_v5_49.4kg/cad/parts/NM26-FRM-117_tube_C_Front_pickup_cross_C.step
25.4 x 450.0 x 25.4 mm
