udayjain2102/nittanymotorsports/history/frame_v1_50.1kg/cad/parts/NM26-RTG-011_wire_bots_to_inertia_switch.step

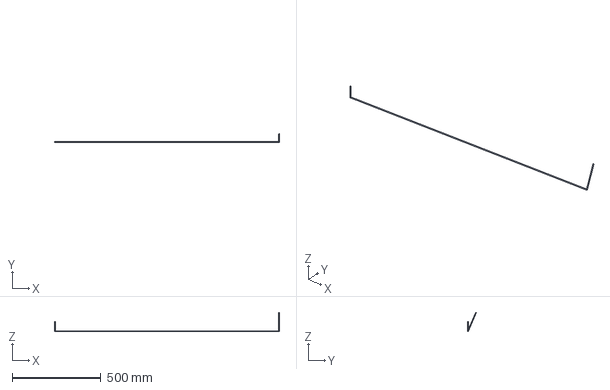
[picture p46: CAD file, 2026-09-30]
history/frame_v1_50.1kg/cad/parts/NM26-RTG-011_wire_bots_to_inertia_switch.step
1265.5 x 49.2 x 108.1 mm
