udayjain2102/nittanymotorsports/history/frame_v1_50.1kg/cad/parts/NM26-BDY-004_belly_pan_1.6mm.step

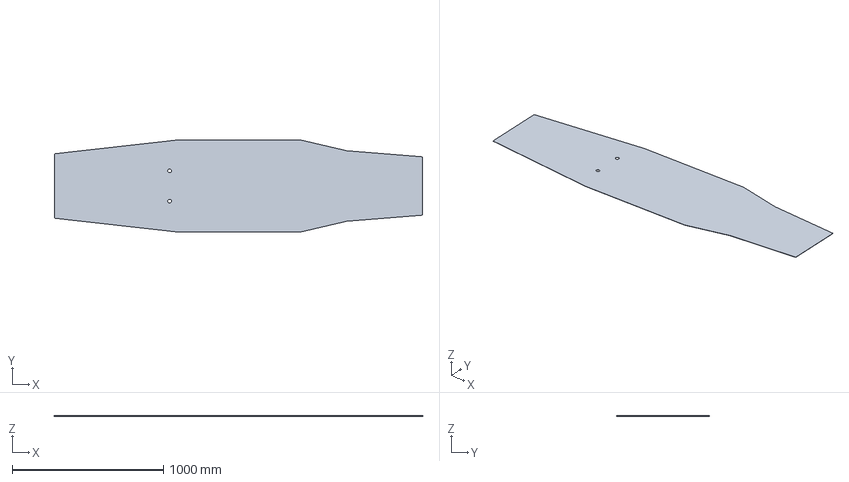
[picture p47: CAD file, 2026-09-30]
history/frame_v1_50.1kg/cad/parts/NM26-BDY-004_belly_pan_1.6mm.step
2430.0 x 609.4 x 1.60 mm
