udayjain2102/nittanymotorsports/history/frame_v5_49.4kg/cad/parts/NM26-FRM-149_shock_tab_rear_L.step

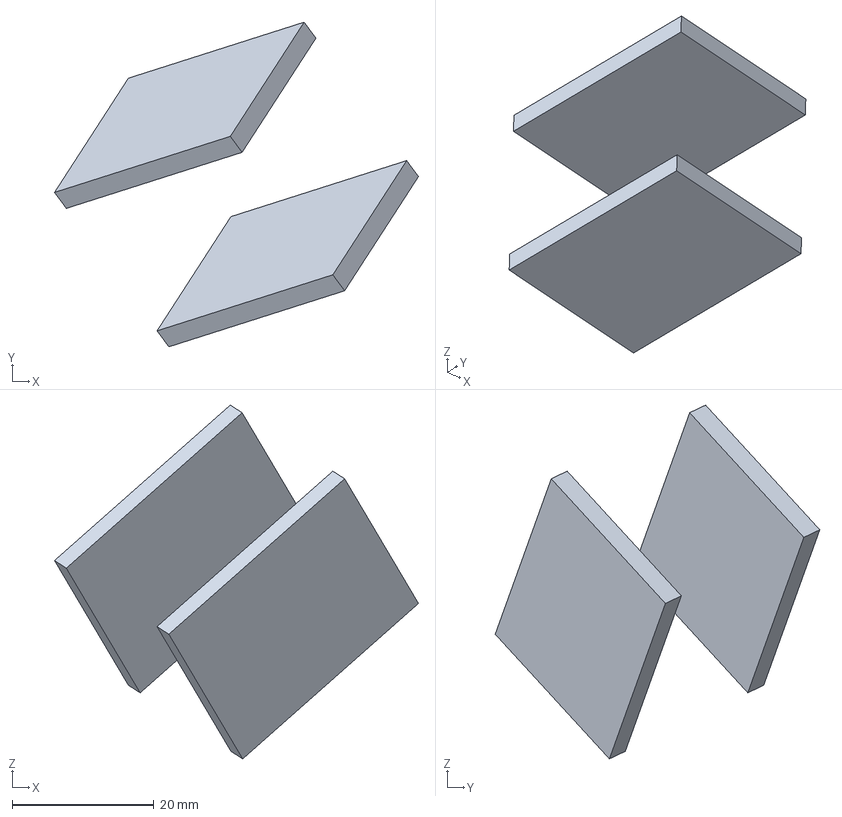
[picture p48: CAD file, 2026-10-11]
history/frame_v5_49.4kg/cad/parts/NM26-FRM-149_shock_tab_rear_L.step
51.3 x 45.7 x 49.9 mm
