udayjain2102/nittanymotorsports/history/frame_v1_50.1kg/cad/parts/NM26-FRM-170_toe_link_tab_rear_L.step

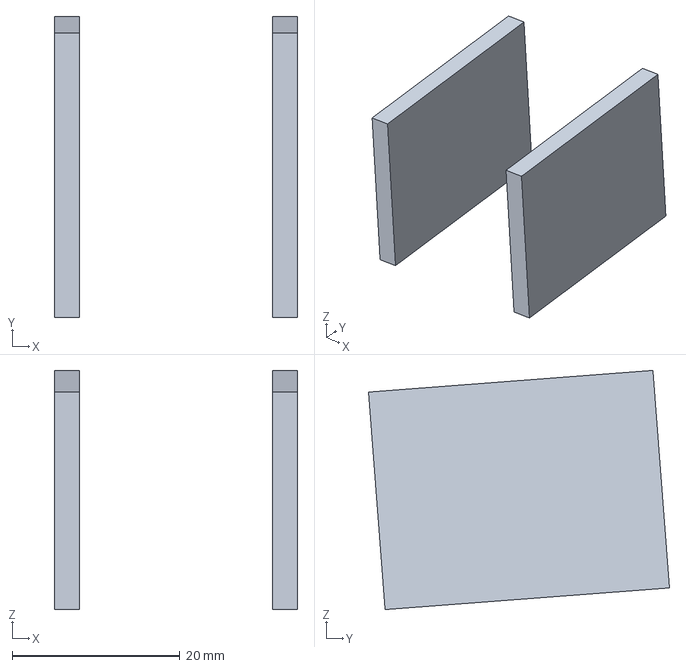
[picture p49: CAD file, 2026-09-30]
history/frame_v1_50.1kg/cad/parts/NM26-FRM-170_toe_link_tab_rear_L.step
29.0 x 35.9 x 28.5 mm
