udayjain2102/nittanymotorsports/history/frame_v1_50.1kg/cad/parts/NM26-FRM-040_tube_H_Front_bulkhead_L_1of3.step

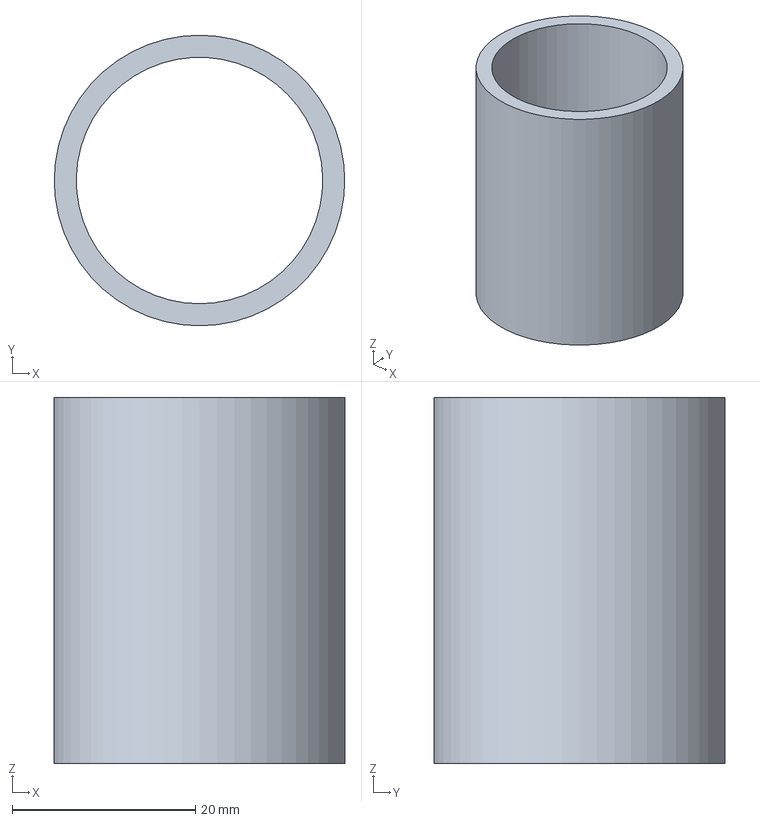
[picture p50: CAD file, 2026-09-30]
history/frame_v1_50.1kg/cad/parts/NM26-FRM-040_tube_H_Front_bulkhead_L_1of3.step
31.8 x 31.8 x 40.0 mm
