udayjain2102/nittanymotorsports/history/frame_v5_49.4kg/cad/parts/NM26-FRM-038_tube_B_Front_hoop_brace_L.step

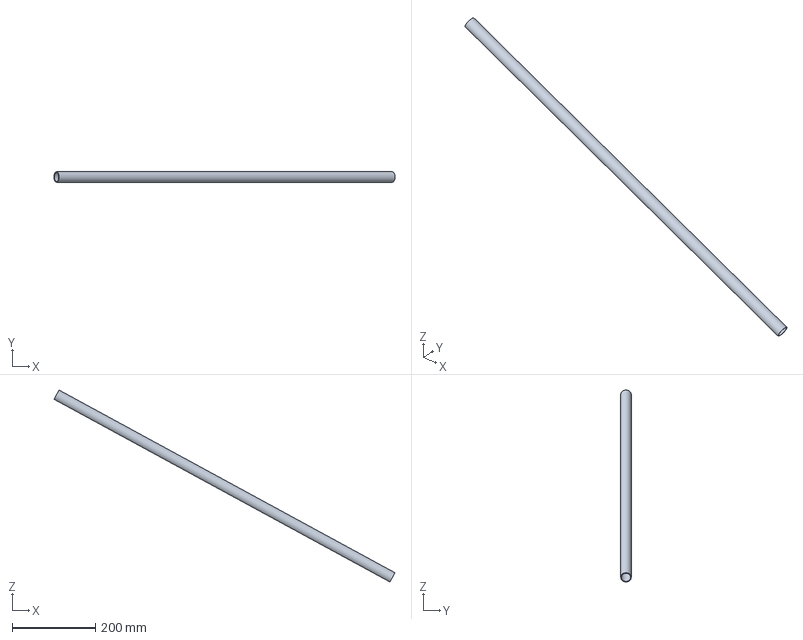
[picture p51: CAD file, 2026-10-11]
history/frame_v5_49.4kg/cad/parts/NM26-FRM-038_tube_B_Front_hoop_brace_L.step
821.1 x 25.4 x 462.3 mm
