udayjain2102/nittanymotorsports/history/frame_v1_50.1kg/cad/parts/NM26-PWT-007_engine_throttle_body_and_injector.step

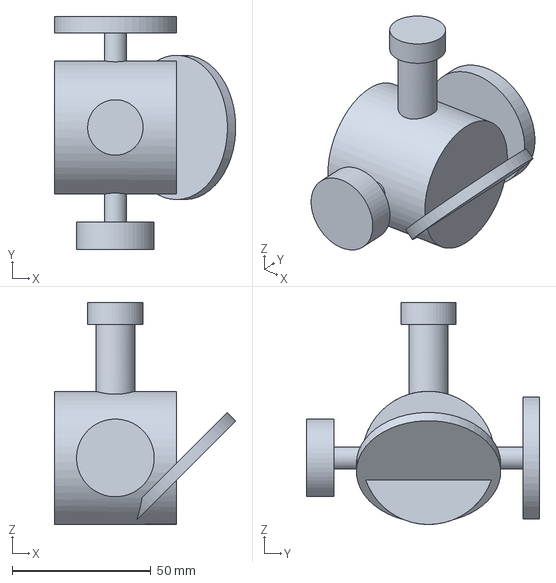
[picture p52: CAD file, 2026-09-30]
history/frame_v1_50.1kg/cad/parts/NM26-PWT-007_engine_throttle_body_and_injector.step
65.3 x 84.0 x 80.0 mm
