udayjain2102/nittanymotorsports/history/frame_v5_49.4kg/cad/parts/NM26-RTG-020_wire_battery_to_chassis_ground.step

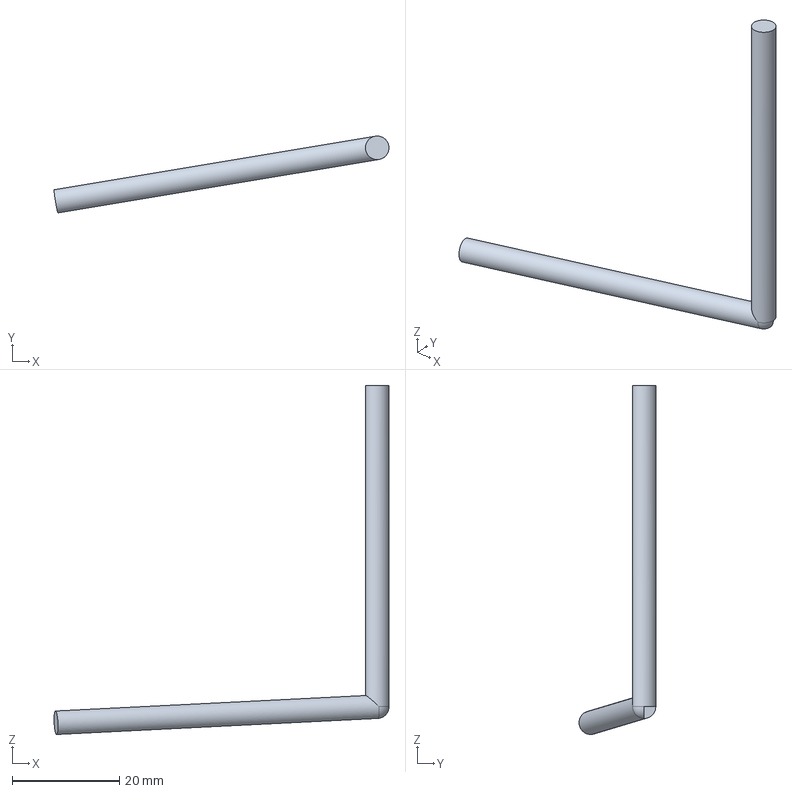
[picture p53: CAD file, 2026-10-11]
history/frame_v5_49.4kg/cad/parts/NM26-RTG-020_wire_battery_to_chassis_ground.step
62.6 x 14.4 x 65.2 mm
