udayjain2102/nittanymotorsports/history/frame_v1_50.1kg/cad/parts/NM26-SUS-019_lower_a_arm_rear_L.step

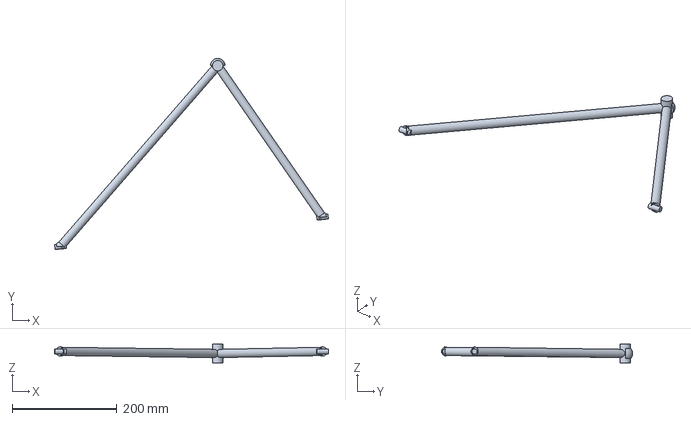
[picture p54: CAD file, 2026-09-30]
history/frame_v1_50.1kg/cad/parts/NM26-SUS-019_lower_a_arm_rear_L.step
523.0 x 365.1 x 36.0 mm
