udayjain2102/nittanymotorsports/history/frame_v5_49.4kg/cad/parts/NM26-UPR-020_upright_rear_L.step

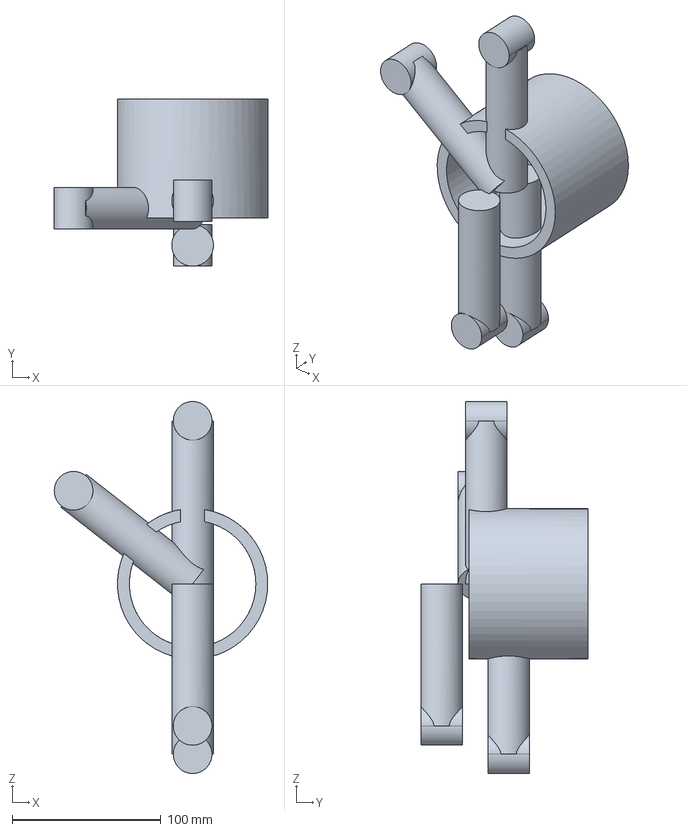
[picture p55: CAD file, 2026-10-11]
history/frame_v5_49.4kg/cad/parts/NM26-UPR-020_upright_rear_L.step
143.5 x 112.5 x 250.0 mm
