udayjain2102/nittanymotorsports/history/frame_v5_49.4kg/cad/parts/NM26-SUS-015_toe_link_rear_R.step

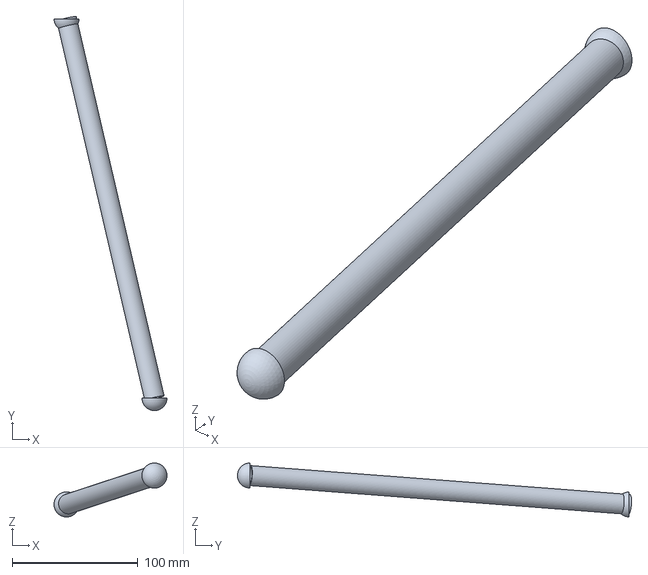
[picture p57: CAD file, 2026-10-11]
history/frame_v5_49.4kg/cad/parts/NM26-SUS-015_toe_link_rear_R.step
90.0 x 313.9 x 43.0 mm
