udayjain2102/nittanymotorsports/history/frame_v1_50.1kg/cad/parts/NM26-FRM-155_pickup_tab_rear_upper_wishbone_at_rear_ring_R.step

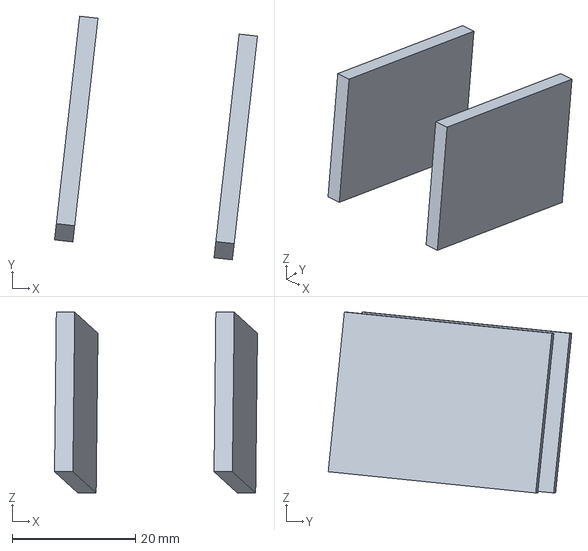
[picture p58: CAD file, 2026-09-30]
history/frame_v1_50.1kg/cad/parts/NM26-FRM-155_pickup_tab_rear_upper_wishbone_at_rear_ring_R.step
32.9 x 39.5 x 29.3 mm
