udayjain2102/nittanymotorsports/history/frame_v5_49.4kg/cad/parts/NM26-FRM-118_tube_B_Pedal_box_cross_C.step

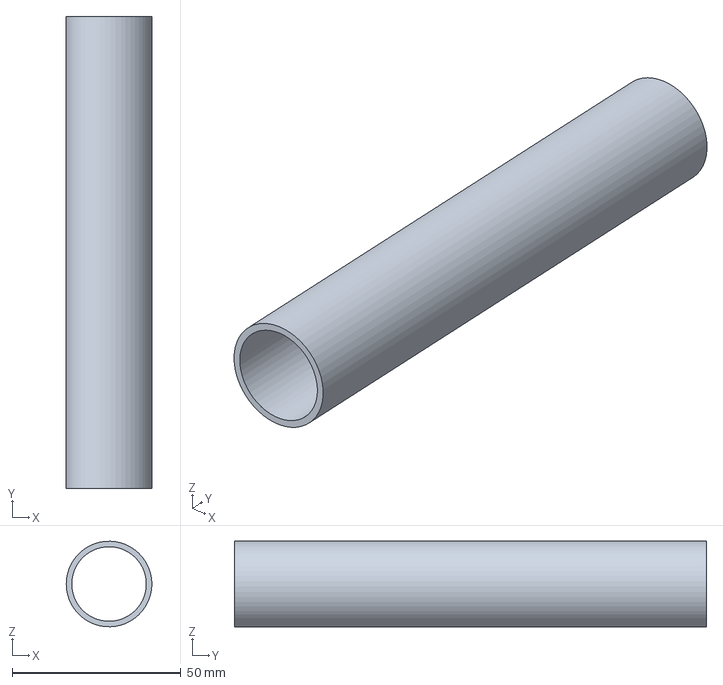
[picture p59: CAD file, 2026-10-11]
history/frame_v5_49.4kg/cad/parts/NM26-FRM-118_tube_B_Pedal_box_cross_C.step
25.4 x 140.0 x 25.4 mm
