udayjain2102/nittanymotorsports/history/frame_v1_50.1kg/cad/parts/NM26-FRM-029_tube_J_Shoulder_harness_bar_R.step

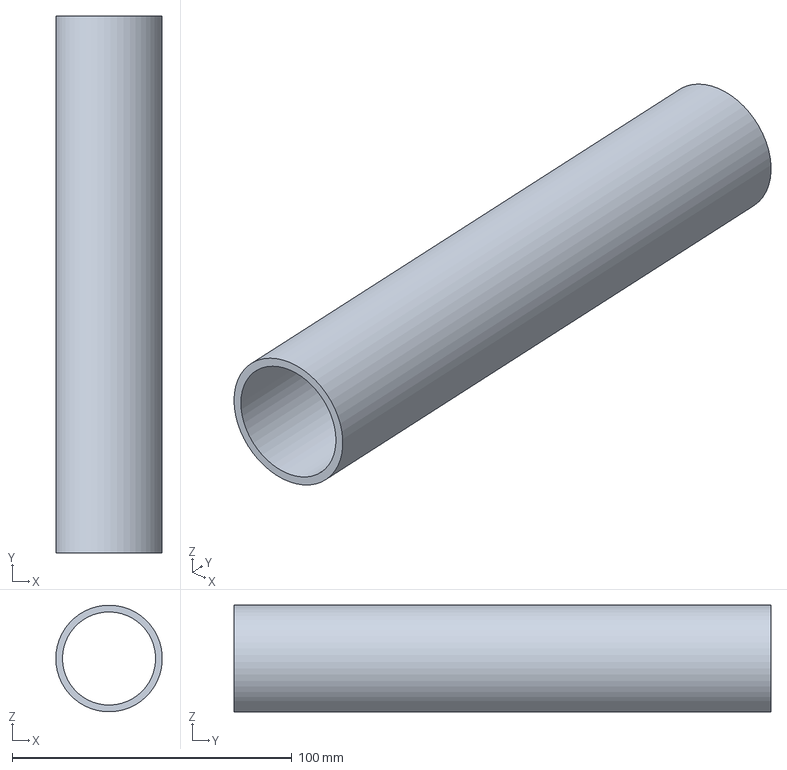
[picture p60: CAD file, 2026-09-30]
history/frame_v1_50.1kg/cad/parts/NM26-FRM-029_tube_J_Shoulder_harness_bar_R.step
38.1 x 192.0 x 38.1 mm
