udayjain2102/nittanymotorsports/history/frame_v5_49.4kg/cad/parts/NM26-UPR-009_rotor_drilled_front_L.step

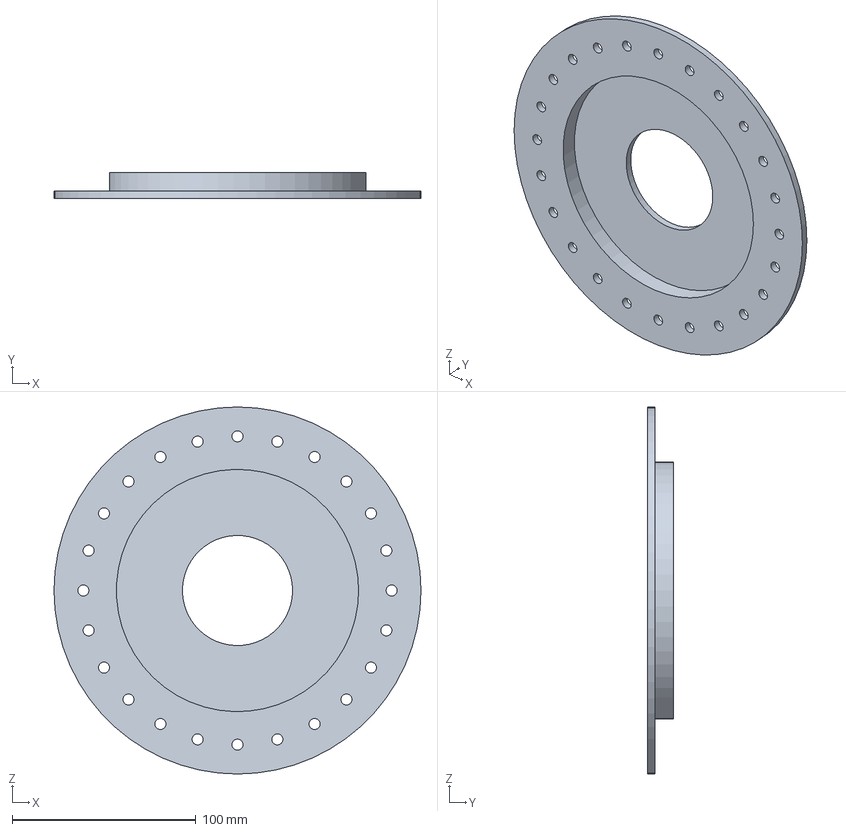
[picture p61: CAD file, 2026-10-11]
history/frame_v5_49.4kg/cad/parts/NM26-UPR-009_rotor_drilled_front_L.step
200.0 x 14.0 x 200.0 mm
