udayjain2102/nittanymotorsports/history/frame_v1_50.1kg/cad/parts/NM26-PWT-006_engine_spark_plug_coil.step

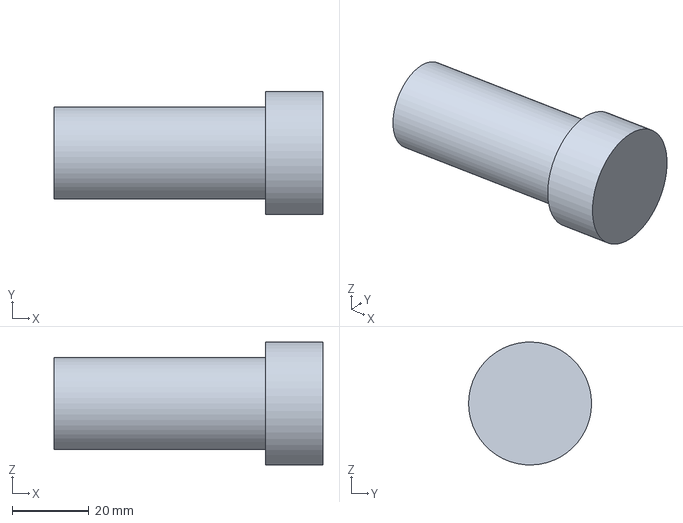
[picture p62: CAD file, 2026-09-30]
history/frame_v1_50.1kg/cad/parts/NM26-PWT-006_engine_spark_plug_coil.step
70.0 x 32.0 x 32.0 mm
