udayjain2102/nittanymotorsports/history/frame_v5_49.4kg/cad/parts/NM26-FRM-100_tube_C_Rear_side_bay_diagonal_L.step

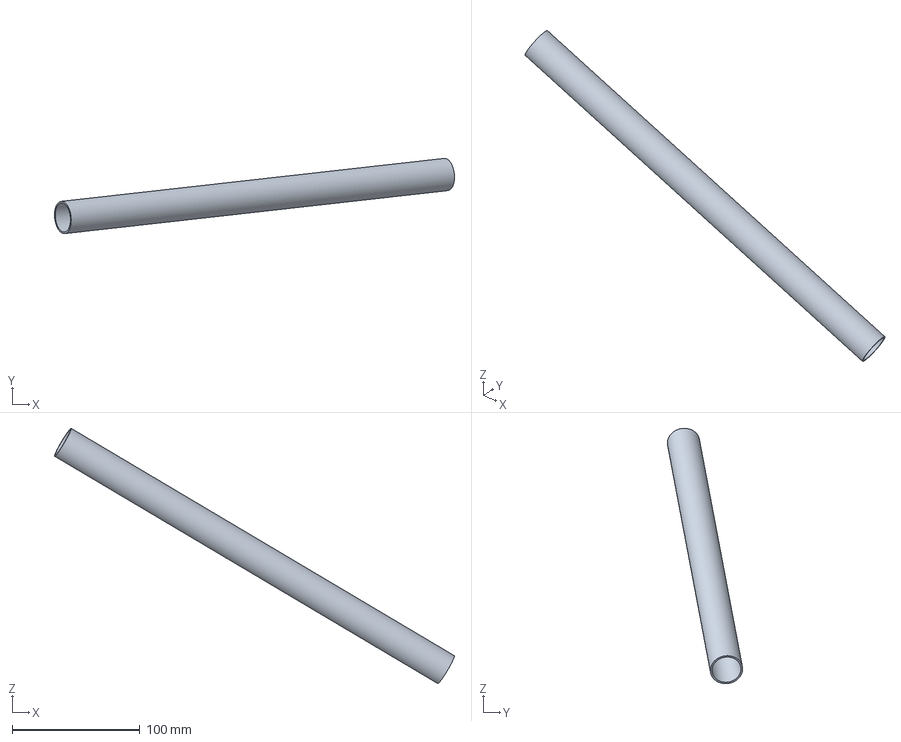
[picture p63: CAD file, 2026-10-11]
history/frame_v5_49.4kg/cad/parts/NM26-FRM-100_tube_C_Rear_side_bay_diagonal_L.step
313.1 x 58.9 x 199.9 mm
