udayjain2102/nittanymotorsports/history/frame_v1_50.1kg/cad/parts/NM26-FRM-025_tube_C_Cockpit_floor_V_R_2of2.step

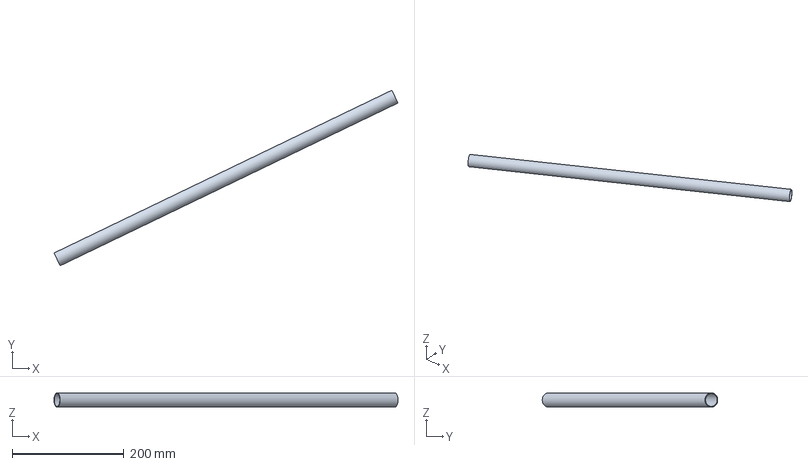
[picture p64: CAD file, 2026-09-30]
history/frame_v1_50.1kg/cad/parts/NM26-FRM-025_tube_C_Cockpit_floor_V_R_2of2.step
617.1 x 314.9 x 25.4 mm
