udayjain2102/nittanymotorsports/history/frame_v5_49.4kg/cad/parts/NM26-FRM-074_tube_A_MH_brace_support_upper_L_3of3.step

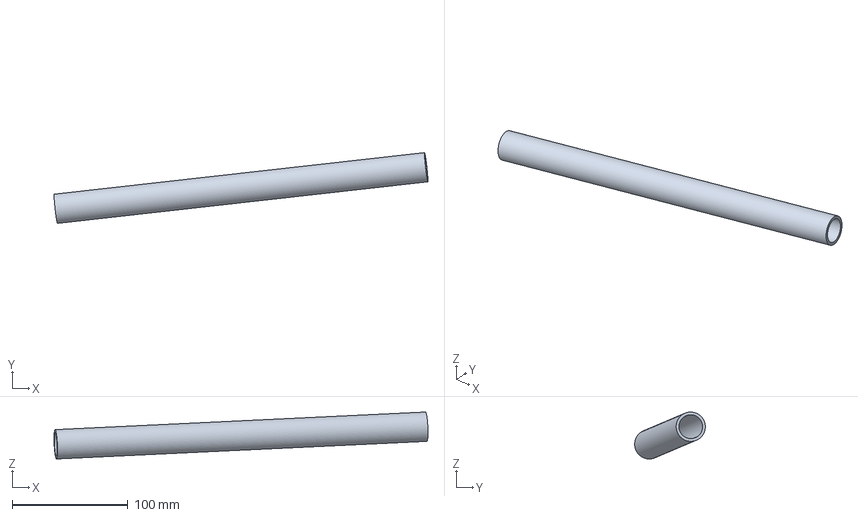
[picture p65: CAD file, 2026-10-11]
history/frame_v5_49.4kg/cad/parts/NM26-FRM-074_tube_A_MH_brace_support_upper_L_3of3.step
323.1 x 61.1 x 40.6 mm
