udayjain2102/nittanymotorsports/history/frame_v5_49.4kg/cad/parts/NM26-SUS-009_tie_rod_front_L.step

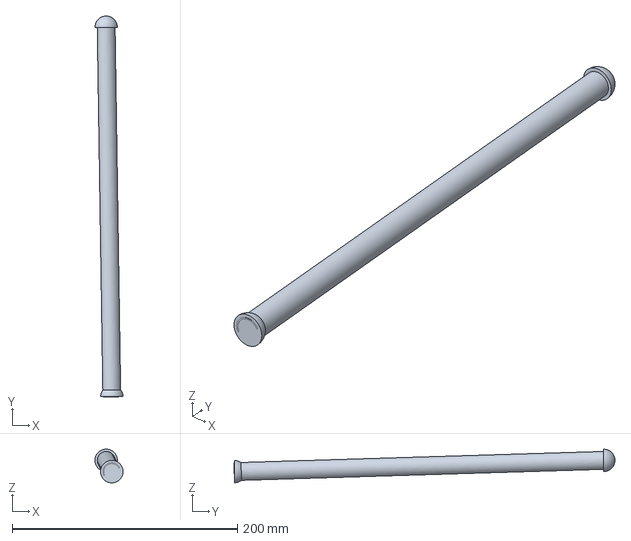
[picture p66: CAD file, 2026-10-11]
history/frame_v5_49.4kg/cad/parts/NM26-SUS-009_tie_rod_front_L.step
25.0 x 338.3 x 30.0 mm
