udayjain2102/nittanymotorsports/history/frame_v1_50.1kg/cad/parts/NM26-FRM-054_tube_B_FBH_support_lower_L_2of3.step

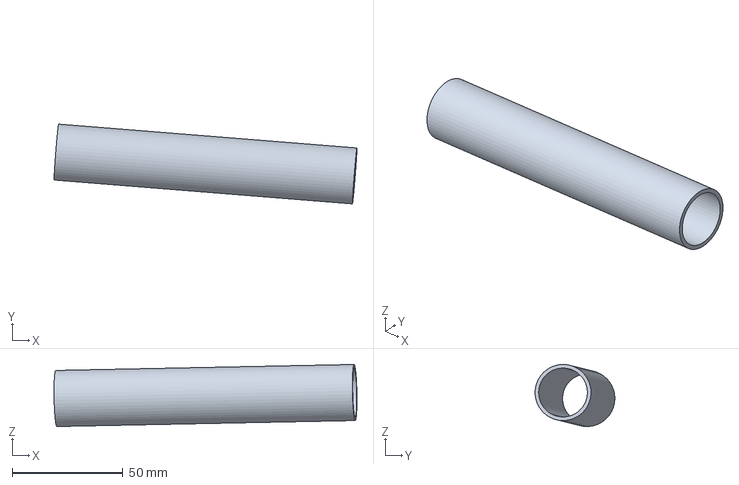
[picture p67: CAD file, 2026-09-30]
history/frame_v1_50.1kg/cad/parts/NM26-FRM-054_tube_B_FBH_support_lower_L_2of3.step
137.1 x 36.1 x 28.1 mm
