udayjain2102/nittanymotorsports/history/frame_v5_49.4kg/cad/parts/NM26-FRM-116_tube_C_Rear_bulkhead_C_2of2.step

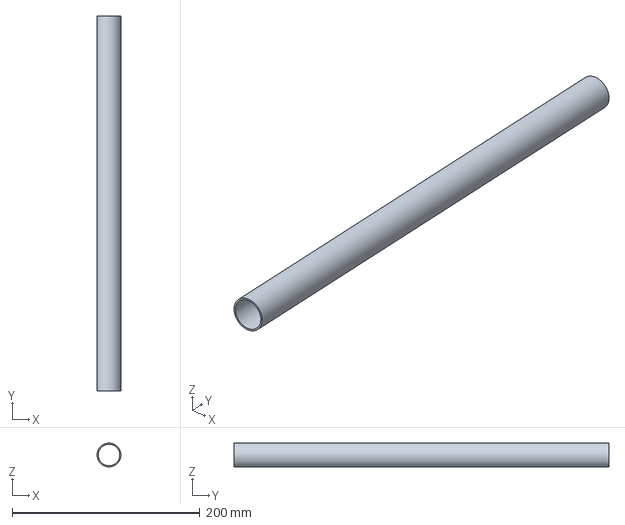
[picture p68: CAD file, 2026-10-11]
history/frame_v5_49.4kg/cad/parts/NM26-FRM-116_tube_C_Rear_bulkhead_C_2of2.step
25.4 x 400.0 x 25.4 mm
