udayjain2102/nittanymotorsports/history/frame_v1_50.1kg/cad/parts/NM26-FRM-064_tube_C_FBH_support_diagonal_L_2of2.step

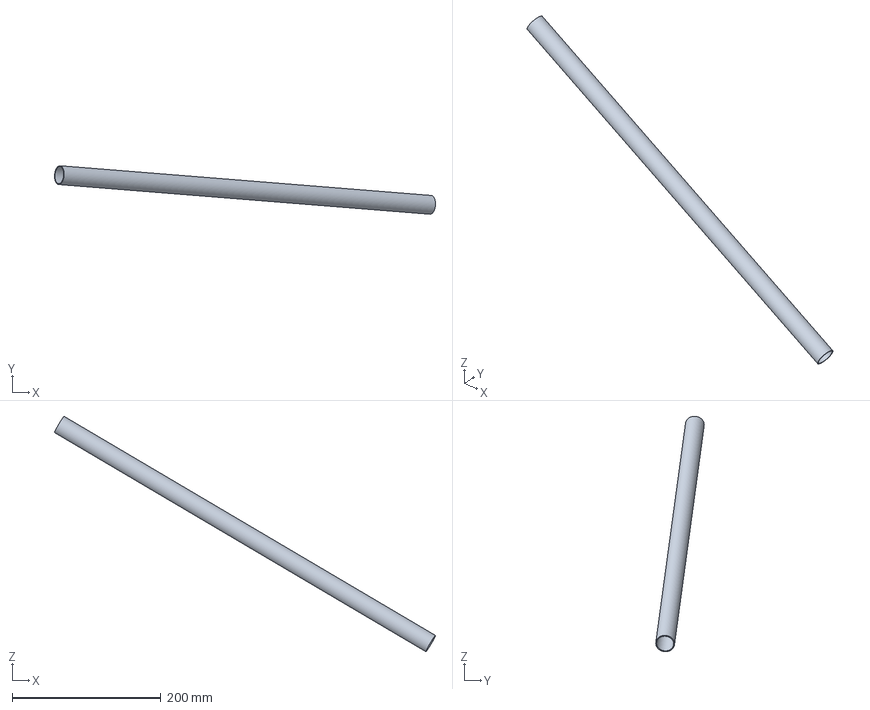
[picture p69: CAD file, 2026-09-30]
history/frame_v1_50.1kg/cad/parts/NM26-FRM-064_tube_C_FBH_support_diagonal_L_2of2.step
513.0 x 65.3 x 316.9 mm
