udayjain2102/nittanymotorsports/history/frame_v1_50.1kg/cad/parts/NM26-AER-007_wing_strut_L.step

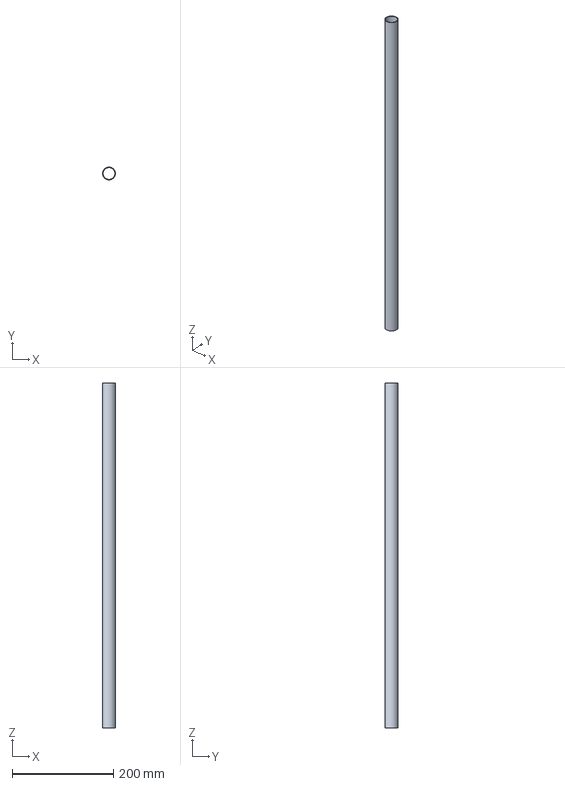
[picture p70: CAD file, 2026-09-30]
history/frame_v1_50.1kg/cad/parts/NM26-AER-007_wing_strut_L.step
25.4 x 25.4 x 680.0 mm
