udayjain2102/nittanymotorsports/history/frame_v5_49.4kg/cad/parts/NM26-RTG-019_wire_primary_master_switch_to_brake_light.step

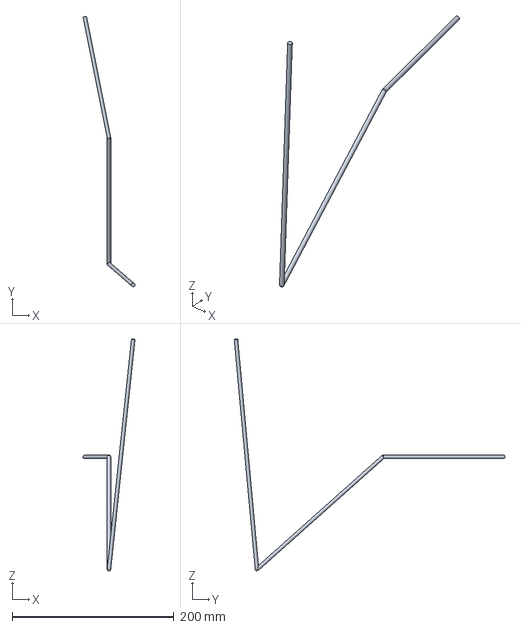
[picture p71: CAD file, 2026-10-11]
history/frame_v5_49.4kg/cad/parts/NM26-RTG-019_wire_primary_master_switch_to_brake_light.step
64.3 x 334.6 x 287.0 mm
