udayjain2102/nittanymotorsports/history/frame_v1_50.1kg/cad/parts/NM26-FRM-160_pickup_tab_front_lower_wishbone_at_front_ring_L.step

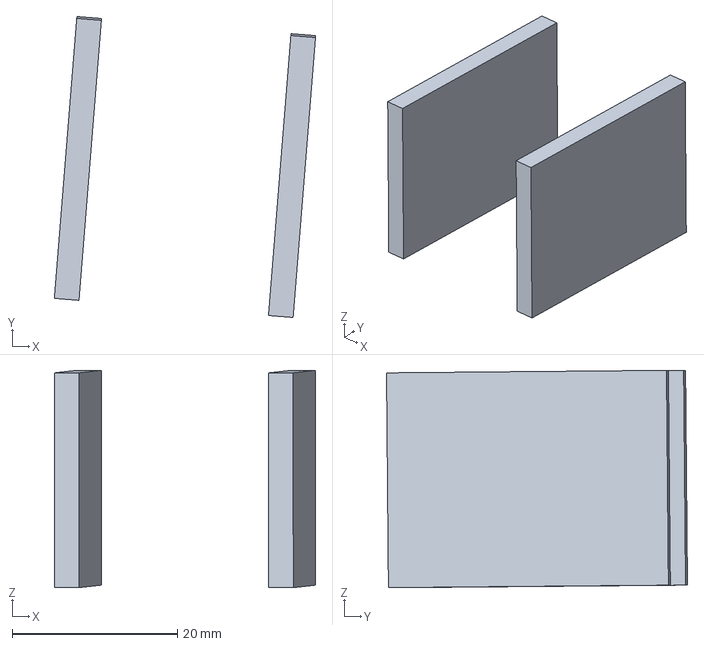
[picture p72: CAD file, 2026-09-30]
history/frame_v1_50.1kg/cad/parts/NM26-FRM-160_pickup_tab_front_lower_wishbone_at_front_ring_L.step
31.6 x 36.4 x 26.3 mm
