udayjain2102/nittanymotorsports/history/frame_v5_49.4kg/cad/parts/NM26-FRM-058_tube_A_FBH_support_lower_L.step

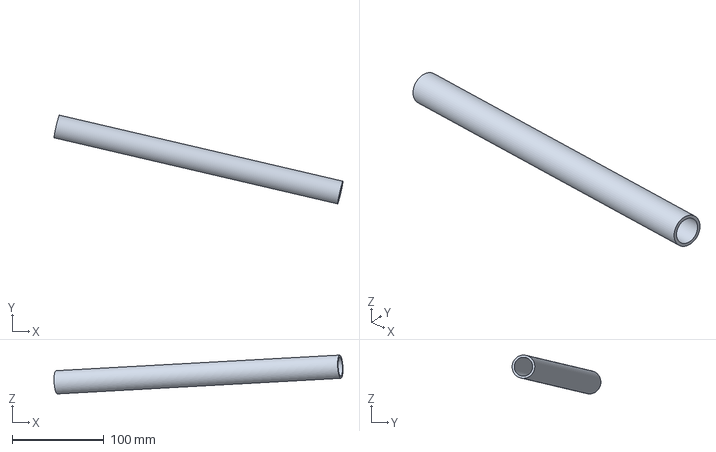
[picture p73: CAD file, 2026-10-11]
history/frame_v5_49.4kg/cad/parts/NM26-FRM-058_tube_A_FBH_support_lower_L.step
314.9 x 96.7 x 42.4 mm
