udayjain2102/nittanymotorsports/history/frame_v1_50.1kg/cad/parts/NM26-FRM-083_tube_B_MH_brace_support_lower_R_1of2.step

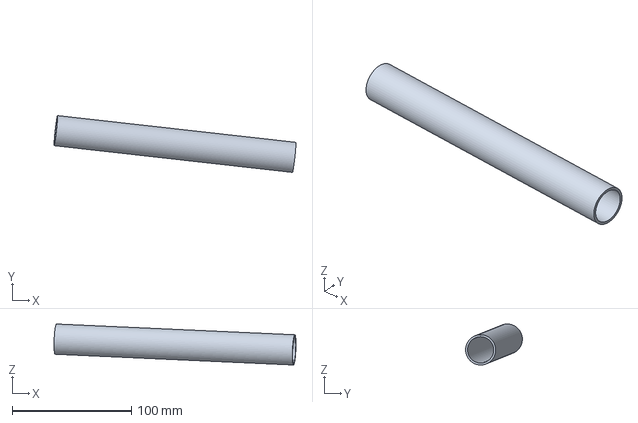
[picture p74: CAD file, 2026-09-30]
history/frame_v1_50.1kg/cad/parts/NM26-FRM-083_tube_B_MH_brace_support_lower_R_1of2.step
203.0 x 47.7 x 34.4 mm
