udayjain2102/nittanymotorsports/history/frame_v5_49.4kg/cad/parts/NM26-SUS-014_upper_a_arm_rear_R.step

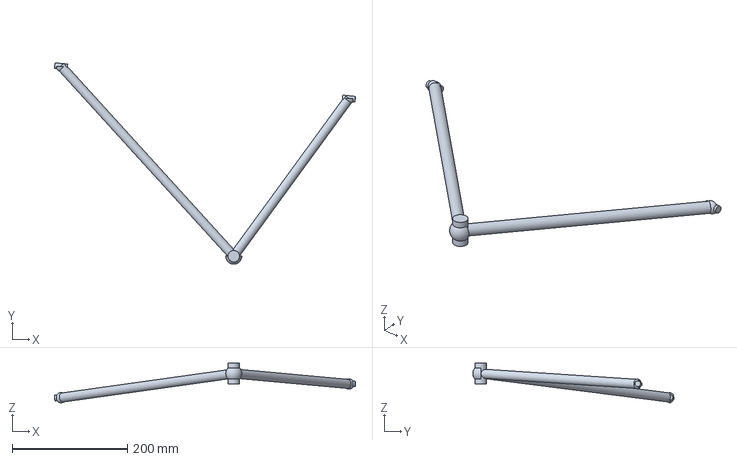
[picture p75: CAD file, 2026-10-11]
history/frame_v5_49.4kg/cad/parts/NM26-SUS-014_upper_a_arm_rear_R.step
523.0 x 350.1 x 69.0 mm
