udayjain2102/nittanymotorsports/history/frame_v1_50.1kg/cad/parts/NM26-FRM-022_tube_B_Lower_side_impact_L_3of3.step

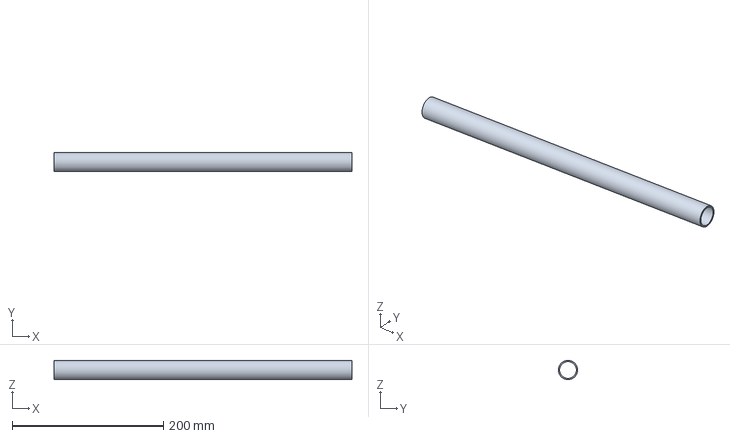
[picture p76: CAD file, 2026-09-30]
history/frame_v1_50.1kg/cad/parts/NM26-FRM-022_tube_B_Lower_side_impact_L_3of3.step
393.6 x 25.4 x 25.4 mm
