udayjain2102/nittanymotorsports/history/frame_v5_49.4kg/cad/parts/NM26-UPR-011_rim_13in_rear_R.step

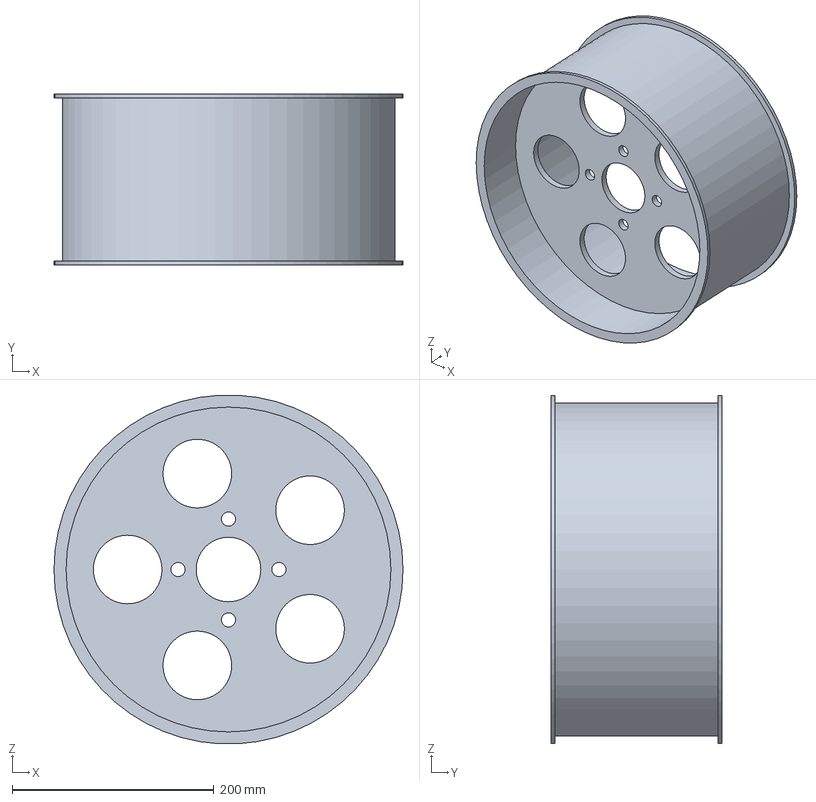
[picture p77: CAD file, 2026-10-11]
history/frame_v5_49.4kg/cad/parts/NM26-UPR-011_rim_13in_rear_R.step
346.0 x 170.0 x 345.5 mm
