udayjain2102/nittanymotorsports/history/frame_v1_50.1kg/cad/parts/NM26-FRM-079_tube_B_MH_brace_support_upper_R_1of3.step

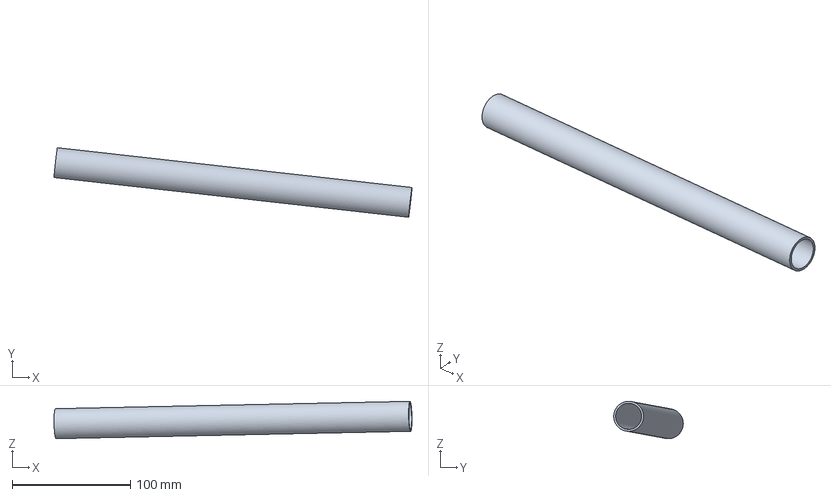
[picture p78: CAD file, 2026-09-30]
history/frame_v1_50.1kg/cad/parts/NM26-FRM-079_tube_B_MH_brace_support_upper_R_1of3.step
302.9 x 58.9 x 31.6 mm
