udayjain2102/nittanymotorsports/history/frame_v5_49.4kg/cad/parts/NM26-FRM-140_pickup_tab_front_upper_wishbone_at_front_ring_L.step

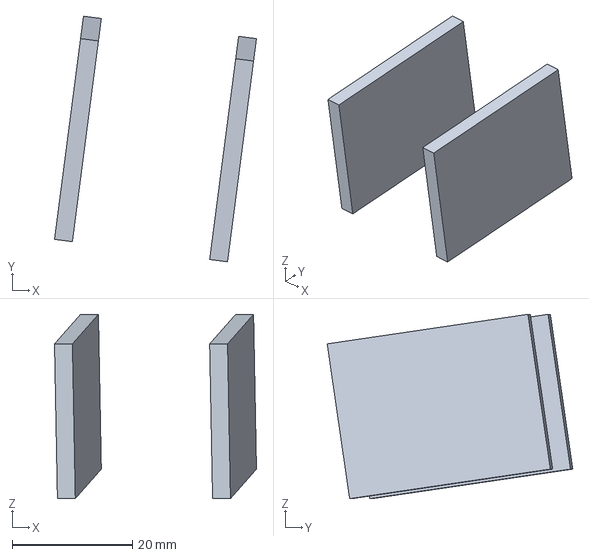
[picture p79: CAD file, 2026-10-11]
history/frame_v5_49.4kg/cad/parts/NM26-FRM-140_pickup_tab_front_upper_wishbone_at_front_ring_L.step
33.6 x 40.8 x 30.6 mm
