udayjain2102/nittanymotorsports/history/frame_v1_50.1kg/cad/parts/NM26-FRM-070_tube_J_Front_susp_ring_L_2of3.step

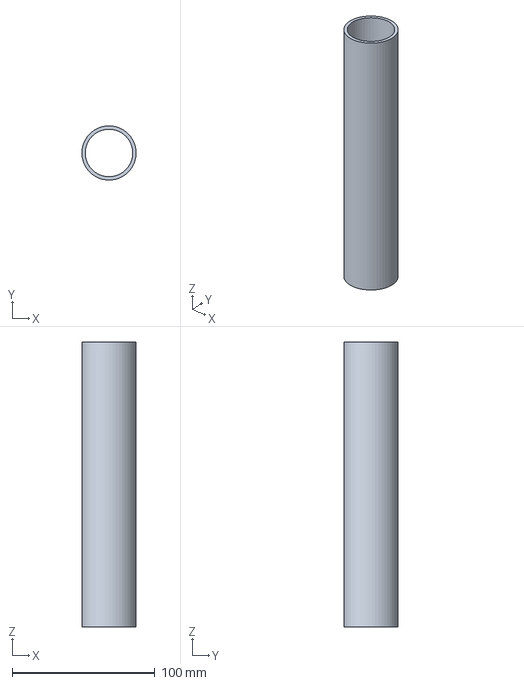
[picture p80: CAD file, 2026-09-30]
history/frame_v1_50.1kg/cad/parts/NM26-FRM-070_tube_J_Front_susp_ring_L_2of3.step
38.1 x 38.1 x 200.0 mm
