udayjain2102/nittanymotorsports/history/frame_v5_49.4kg/cad/parts/NM26-FRM-066_tube_J_Front_susp_ring_L_1of3.step

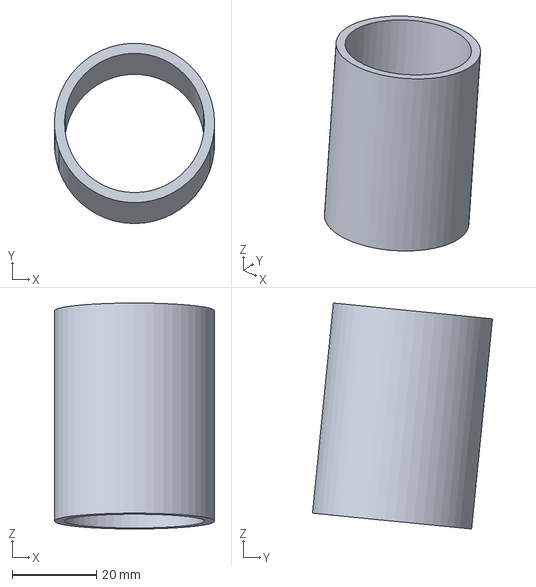
[picture p81: CAD file, 2026-10-11]
history/frame_v5_49.4kg/cad/parts/NM26-FRM-066_tube_J_Front_susp_ring_L_1of3.step
38.1 x 42.9 x 53.8 mm
