udayjain2102/nittanymotorsports/history/frame_v1_50.1kg/cad/parts/NM26-FRM-163_pickup_tab_front_upper_wishbone_at_front_bulkhead_L.step

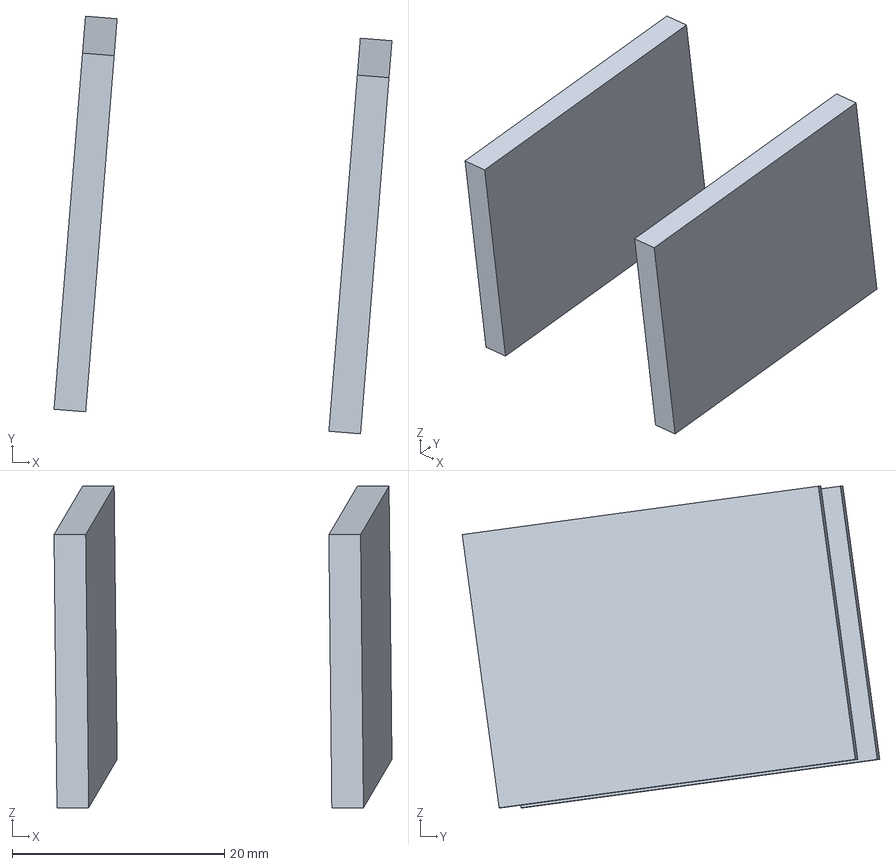
[picture p82: CAD file, 2026-09-30]
history/frame_v1_50.1kg/cad/parts/NM26-FRM-163_pickup_tab_front_upper_wishbone_at_front_bulkhead_L.step
31.9 x 39.4 x 30.3 mm
