udayjain2102/nittanymotorsports/history/frame_v5_49.4kg/cad/parts/NM26-SUS-023_rocker_plate_rear_L.step

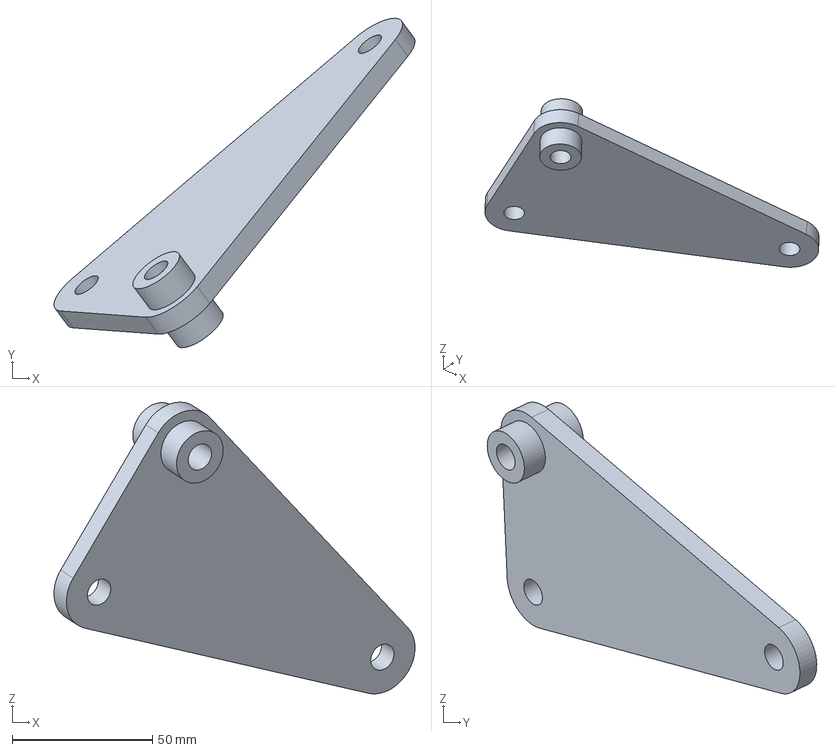
[picture p83: CAD file, 2026-10-11]
history/frame_v5_49.4kg/cad/parts/NM26-SUS-023_rocker_plate_rear_L.step
128.5 x 117.3 x 103.9 mm
