udayjain2102/nittanymotorsports/history/frame_v1_50.1kg/cad/parts/NM26-RTG-016_wire_ignition-ECU_to_coil.step

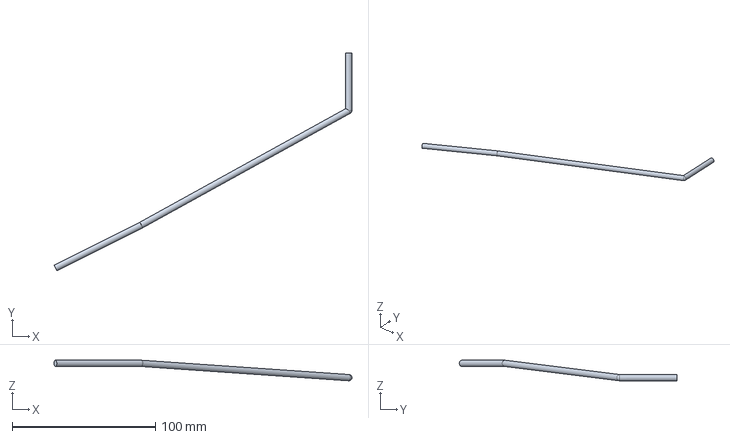
[picture p84: CAD file, 2026-09-30]
history/frame_v1_50.1kg/cad/parts/NM26-RTG-016_wire_ignition-ECU_to_coil.step
208.2 x 152.0 x 14.4 mm
