udayjain2102/nittanymotorsports/history/frame_v5_49.4kg/cad/parts/NM26-FRM-097_tube_B_Spool_carrier_brace_R_1of2.step

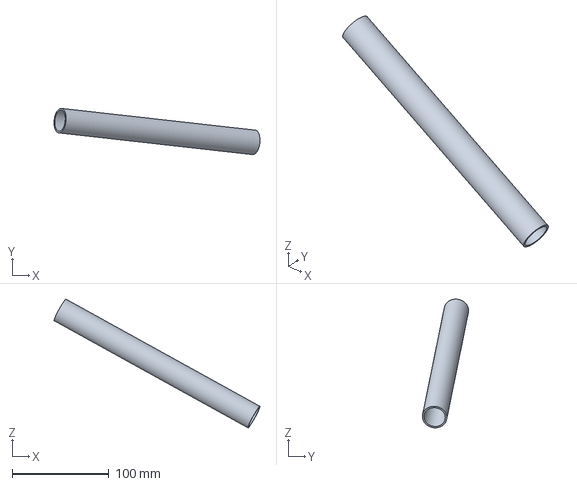
[picture p85: CAD file, 2026-10-11]
history/frame_v5_49.4kg/cad/parts/NM26-FRM-097_tube_B_Spool_carrier_brace_R_1of2.step
212.5 x 47.7 x 132.7 mm
