udayjain2102/nittanymotorsports/history/frame_v1_50.1kg/cad/parts/NM26-PWT-011_engine_oil_filter.step

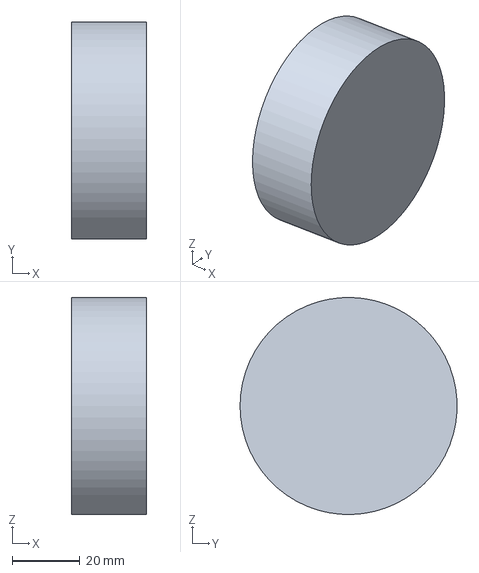
[picture p86: CAD file, 2026-09-30]
history/frame_v1_50.1kg/cad/parts/NM26-PWT-011_engine_oil_filter.step
22.0 x 64.0 x 64.0 mm
