udayjain2102/nittanymotorsports/history/frame_v5_49.4kg/cad/parts/NM26-SUS-024_coilover_shock_rear_L.step

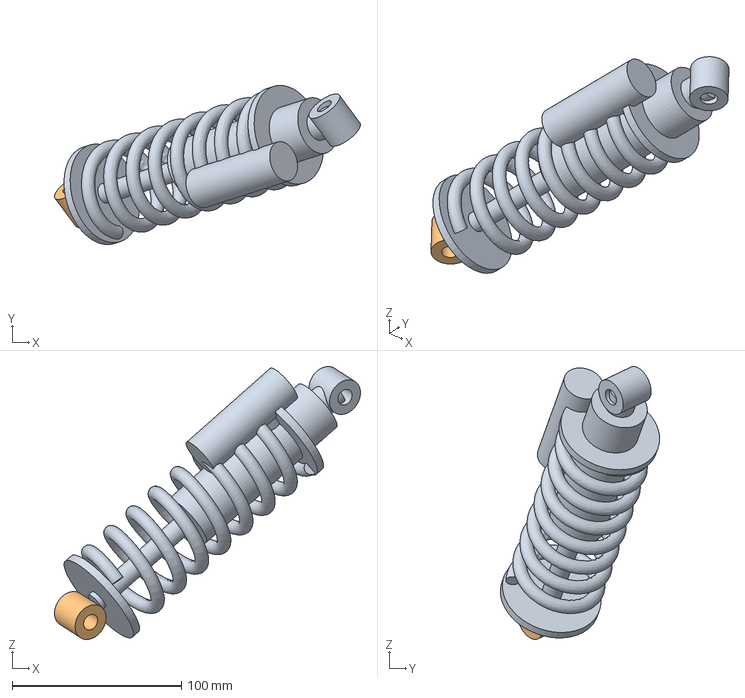
[picture p87: CAD file, 2026-10-11]
history/frame_v5_49.4kg/cad/parts/NM26-SUS-024_coilover_shock_rear_L.step
181.0 x 94.2 x 161.5 mm
