udayjain2102/nittanymotorsports/history/frame_v1_50.1kg/cad/parts/NM26-FRM-049_tube_B_Front_hoop_lower_brace_R.step

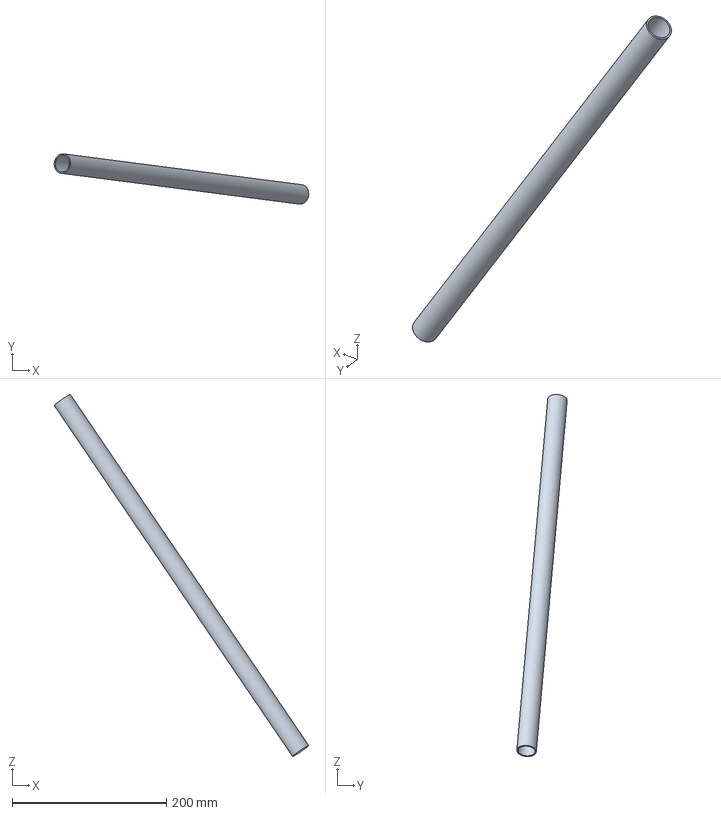
[picture p88: CAD file, 2026-09-30]
history/frame_v1_50.1kg/cad/parts/NM26-FRM-049_tube_B_Front_hoop_lower_brace_R.step
330.0 x 65.3 x 469.3 mm
