udayjain2102/nittanymotorsports/history/frame_v1_50.1kg/cad/parts/NM26-BRK-012_reservoir_rear.step

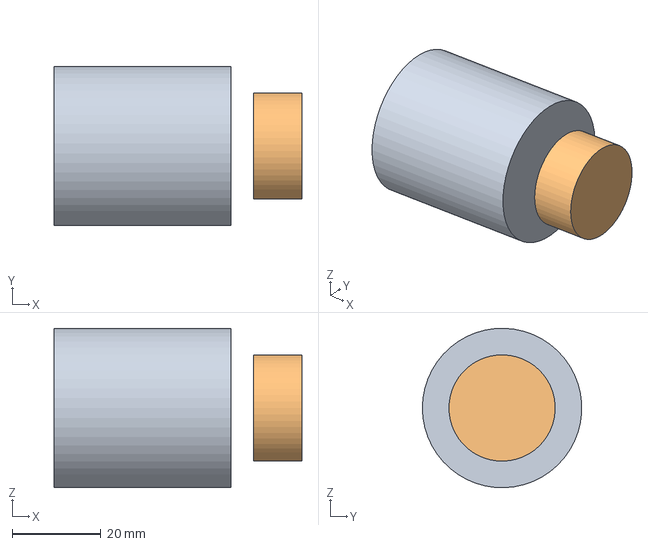
[picture p89: CAD file, 2026-09-30]
history/frame_v1_50.1kg/cad/parts/NM26-BRK-012_reservoir_rear.step
56.0 x 36.0 x 36.0 mm
