udayjain2102/nittanymotorsports/history/frame_v5_49.4kg/cad/parts/NM26-ELE-001_dash_panel.step

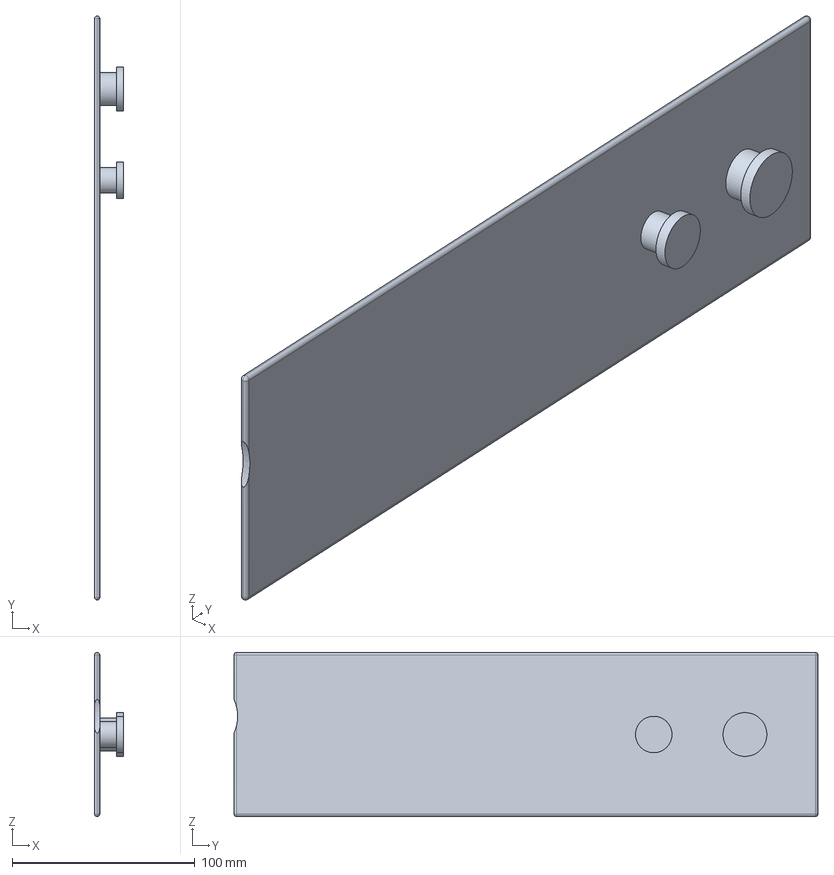
[picture p90: CAD file, 2026-10-11]
history/frame_v5_49.4kg/cad/parts/NM26-ELE-001_dash_panel.step
16.0 x 320.0 x 90.0 mm
