udayjain2102/nittanymotorsports/history/frame_v1_50.1kg/cad/parts/NM26-FRM-031_tube_B_Diagonal_side_impact_R_1of2.step

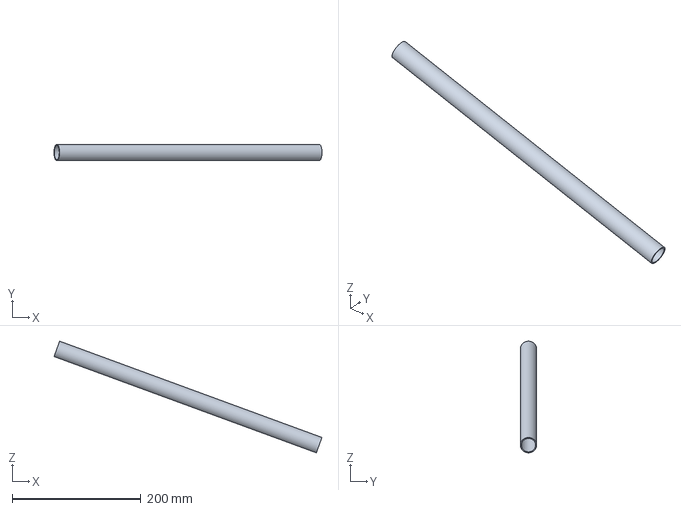
[picture p91: CAD file, 2026-09-30]
history/frame_v1_50.1kg/cad/parts/NM26-FRM-031_tube_B_Diagonal_side_impact_R_1of2.step
416.1 x 25.4 x 173.3 mm
