udayjain2102/nittanymotorsports/history/frame_v5_49.4kg/cad/parts/NM26-PWT-005_engine_head_and_cam_cover.step

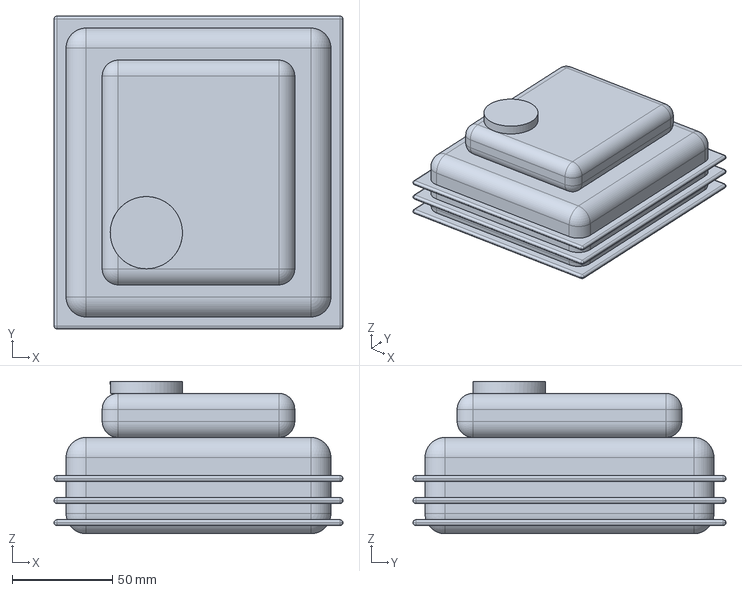
[picture p92: CAD file, 2026-10-11]
history/frame_v5_49.4kg/cad/parts/NM26-PWT-005_engine_head_and_cam_cover.step
144.0 x 156.0 x 76.0 mm
