udayjain2102/nittanymotorsports/history/frame_v1_50.1kg/cad/parts/NM26-FUL-002_fuel_line.step

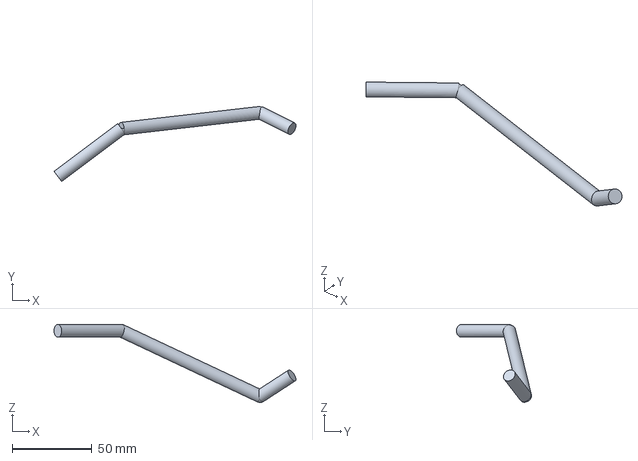
[picture p93: CAD file, 2026-09-30]
history/frame_v1_50.1kg/cad/parts/NM26-FUL-002_fuel_line.step
151.9 x 47.2 x 49.0 mm
