udayjain2102/nittanymotorsports/history/frame_v5_49.4kg/cad/parts/NM26-FRM-130_rocker_pivot_bushing_front_R.step

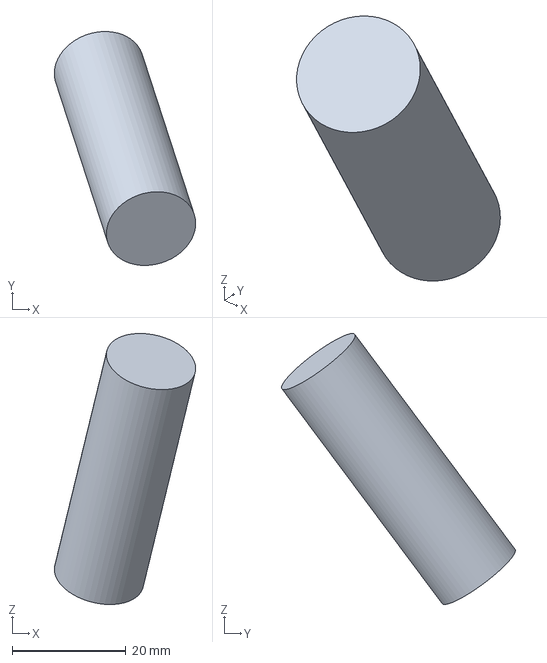
[picture p94: CAD file, 2026-10-11]
history/frame_v5_49.4kg/cad/parts/NM26-FRM-130_rocker_pivot_bushing_front_R.step
24.9 x 41.1 x 47.6 mm
