udayjain2102/nittanymotorsports/history/frame_v1_50.1kg/cad/parts/NM26-RTG-005_brake_line_rear_R.step

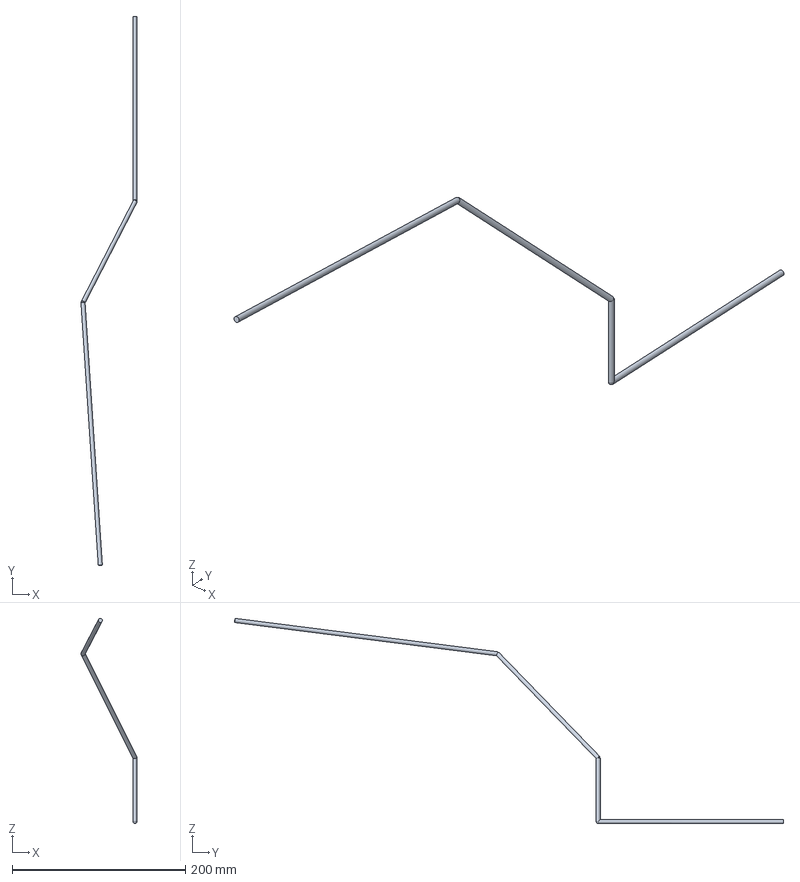
[picture p95: CAD file, 2026-09-30]
history/frame_v1_50.1kg/cad/parts/NM26-RTG-005_brake_line_rear_R.step
64.8 x 633.3 x 236.8 mm
