udayjain2102/nittanymotorsports/history/frame_v1_50.1kg/cad/parts/NM26-RTG-004_brake_line_rear_MC_to_tee.step

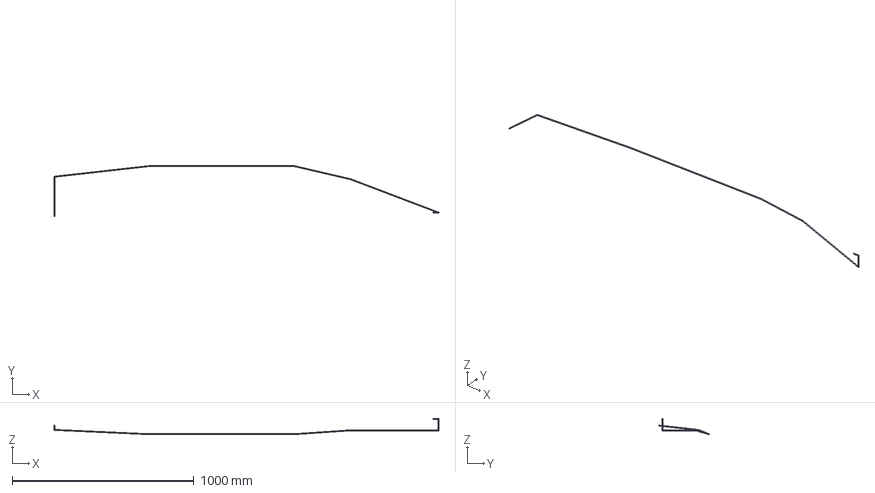
[picture p96: CAD file, 2026-09-30]
history/frame_v1_50.1kg/cad/parts/NM26-RTG-004_brake_line_rear_MC_to_tee.step
2119.5 x 278.7 x 89.3 mm
