udayjain2102/nittanymotorsports/history/frame_v5_49.4kg/cad/parts/NM26-UPR-003_hub_front_R.step

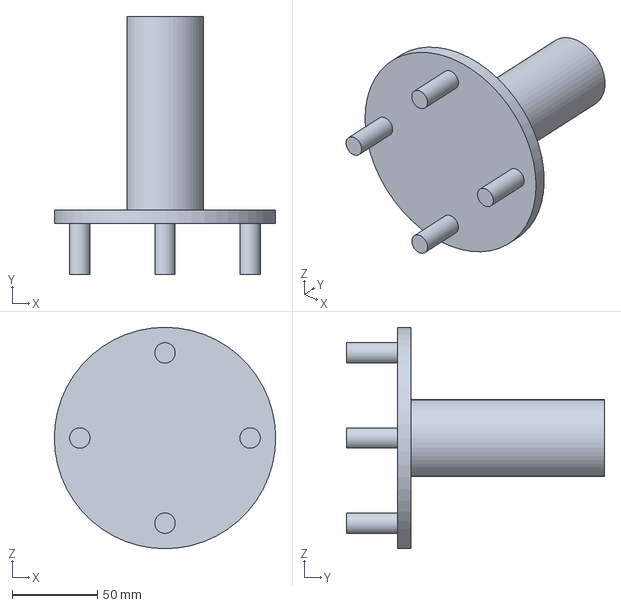
[picture p97: CAD file, 2026-10-11]
history/frame_v5_49.4kg/cad/parts/NM26-UPR-003_hub_front_R.step
130.0 x 151.5 x 130.0 mm
