udayjain2102/nittanymotorsports/history/frame_v1_50.1kg/cad/parts/NM26-RTG-010_wire_e-stop_to_bots.step

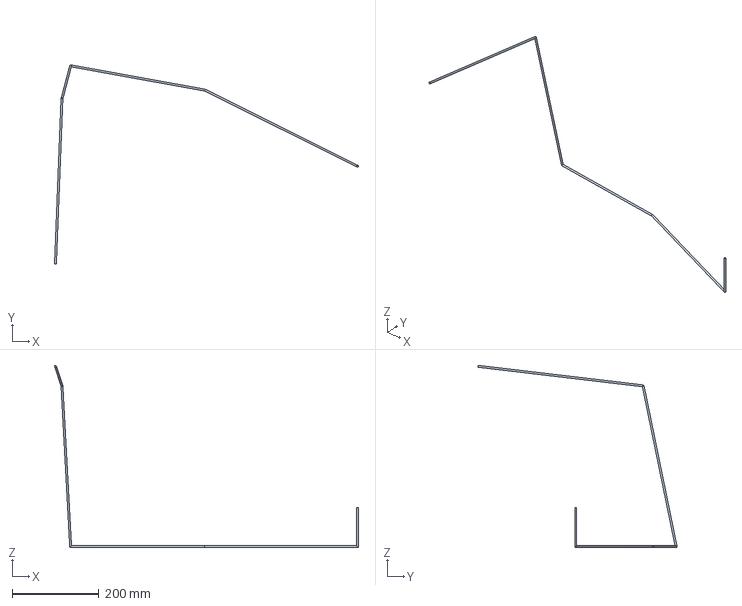
[picture p98: CAD file, 2026-09-30]
history/frame_v1_50.1kg/cad/parts/NM26-RTG-010_wire_e-stop_to_bots.step
699.4 x 458.4 x 419.4 mm
