udayjain2102/nittanymotorsports/history/frame_v5_49.4kg/cad/parts/NM26-WHL-001_tyre_front_R.step

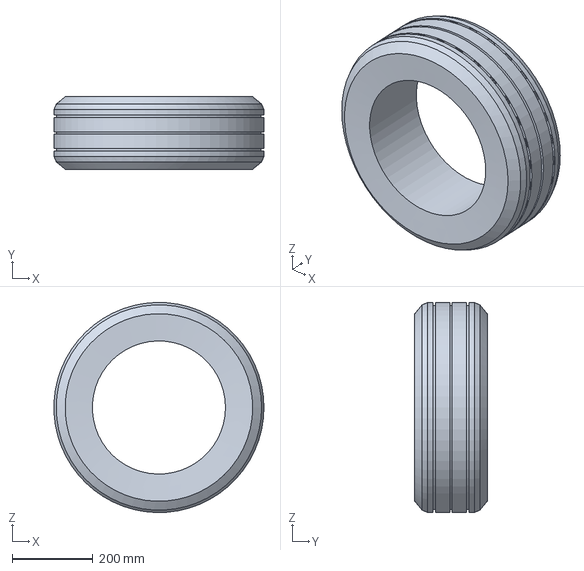
[picture p99: CAD file, 2026-10-11]
history/frame_v5_49.4kg/cad/parts/NM26-WHL-001_tyre_front_R.step
520.6 x 180.0 x 520.8 mm
