udayjain2102/nittanymotorsports/(list of files, cad)

Other CAD files:
history/frame_v5_49.4kg/cad/parts/NM26-FRM-072_tube_A_Main_hoop_brace_L.step
history/frame_v1_50.1kg/cad/parts/NM26-FRM-123_tube_H_Main_hoop_mid_cross_-_firewall_+_top_engine_mounts_R.step
history/frame_v1_50.1kg/cad/parts/NM26-FRM-074_tube_A_Main_hoop_brace_L.step
history/frame_v1_50.1kg/cad/parts/NM26-FRM-146_tube_H_Main_hoop_mid_cross_-_firewall_+_top_engine_mounts_C.step
history/frame_v5_49.4kg/cad/parts/NM26-FRM-012_tube_J_Main_hoop_L_3of4.step
history/frame_v5_49.4kg/cad/parts/NM26-FRM-007_tube_J_Main_hoop_R_1of4.step
history/frame_v5_49.4kg/cad/parts/NM26-FRM-092_tube_C_Main_hoop_bend_support_L.step
history/frame_v1_50.1kg/cad/parts/NM26-FRM-009_tube_H_Main_hoop_R_2of4.step
history/frame_v5_49.4kg/cad/parts/NM26-FRM-102_tube_H_Main_hoop_base_cross_+_front_engine_mounts_L.step
history/frame_v5_49.4kg/cad/parts/NM26-FRM-009_tube_J_Main_hoop_R_2of4.step
history/frame_v1_50.1kg/cad/parts/NM26-FRM-012_tube_H_Main_hoop_L_3of4.step
history/frame_v1_50.1kg/cad/parts/NM26-AER-008_wing_brace_to_main_hoop_L.step
history/frame_v5_49.4kg/cad/parts/NM26-FRM-014_tube_J_Main_hoop_L_4of4.step
history/frame_v5_49.4kg/cad/parts/NM26-FRM-101_tube_H_Main_hoop_base_cross_+_front_engine_mounts_R.step
history/frame_v1_50.1kg/cad/parts/NM26-FRM-120_tube_A_Main_hoop_base_cross_+_front_engine_mounts_L.step
history/frame_v5_49.4kg/cad/parts/NM26-FRM-124_tube_H_Main_hoop_mid_cross_-_firewall_+_top_engine_mounts_C.step
history/frame_v5_49.4kg/cad/parts/NM26-FRM-105_tube_H_Main_hoop_mid_cross_-_firewall_+_top_engine_mounts_R.step
history/frame_v5_49.4kg/cad/parts/NM26-FRM-074_tube_A_Main_hoop_brace_L.step
history/frame_v5_49.4kg/cad/parts/NM26-FRM-116_tube_J_Main_hoop_C.step
history/frame_v5_49.4kg/cad/parts/NM26-FRM-073_tube_A_Main_hoop_brace_R.step
history/frame_v1_50.1kg/cad/parts/NM26-FRM-014_tube_H_Main_hoop_L_4of4.step
history/frame_v1_50.1kg/cad/parts/NM26-FRM-007_tube_H_Main_hoop_R_1of4.step
history/frame_v5_49.4kg/cad/parts/NM26-FRM-093_tube_C_Main_hoop_bend_support_R.step
history/frame_v5_49.4kg/cad/parts/NM26-FRM-128_tube_H_Main_hoop_mid_cross_-_firewall_+_top_engine_mounts_C.step
history/frame_v1_50.1kg/cad/parts/NM26-FRM-124_tube_H_Main_hoop_mid_cross_-_firewall_+_top_engine_mounts_L.step
history/frame_v5_49.4kg/cad/parts/NM26-FRM-109_tube_H_Main_hoop_mid_cross_-_firewall_+_top_engine_mounts_R.step
history/frame_v5_49.4kg/cad/parts/NM26-FRM-105_tube_H_Main_hoop_base_cross_+_front_engine_mounts_R.step
history/frame_v5_49.4kg/cad/parts/NM26-FRM-110_tube_H_Main_hoop_mid_cross_-_firewall_+_top_engine_mounts_L.step
history/frame_v5_49.4kg/cad/parts/NM26-FRM-106_tube_H_Main_hoop_base_cross_+_front_engine_mounts_L.step
history/frame_v5_49.4kg/cad/parts/NM26-FRM-115_tube_H_Main_hoop_base_cross_+_front_engine_mounts_C.step
history/frame_v5_49.4kg/cad/parts/NM26-FRM-094_tube_C_Main_hoop_bend_support_L.step
history/frame_v5_49.4kg/cad/parts/NM26-AER-006_wing_brace_to_main_hoop_R.step
history/frame_v5_49.4kg/cad/parts/NM26-FRM-126_tube_A_Main_hoop_mid_cross_-_firewall_+_top_engine_mounts_C.step
history/frame_v5_49.4kg/cad/parts/NM26-FRM-104_tube_A_Main_hoop_base_cross_+_front_engine_mounts_L.step
history/frame_v5_49.4kg/cad/parts/NM26-FRM-114_tube_J_Main_hoop_C.step
history/frame_v5_49.4kg/cad/parts/NM26-AER-008_wing_brace_to_main_hoop_L.step
history/frame_v5_49.4kg/cad/parts/NM26-AER-001_rear_wing_main_plane.step
history/frame_v5_49.4kg/cad/parts/NM26-FRM-108_tube_A_Main_hoop_mid_cross_-_firewall_+_top_engine_mounts_L.step
history/frame_v5_49.4kg/cad/parts/NM26-FRM-107_tube_A_Main_hoop_mid_cross_-_firewall_+_top_engine_mounts_R.step
history/frame_v5_49.4kg/cad/parts/NM26-FRM-103_tube_A_Main_hoop_base_cross_+_front_engine_mounts_R.step
history/frame_v5_49.4kg/cad/parts/NM26-FRM-113_tube_A_Main_hoop_base_cross_+_front_engine_mounts_C.step
history/frame_v5_49.4kg/cad/parts/NM26-FRM-073_tube_B_Main_hoop_brace_R.step
history/frame_v5_49.4kg/cad/parts/NM26-STR-001_steering_wheel.step
history/frame_v1_50.1kg/cad/parts/NM26-UPR-004_rotor_drilled_front_R.step
history/frame_v1_50.1kg/cad/parts/NM26-UPR-011_rim_13in_rear_R.step
history/frame_v5_49.4kg/cad/parts/NM26-FRM-053_tube_A_FBH_support_lower_R_2of3.step
history/frame_v1_50.1kg/cad/parts/NM26-FRM-075_tube_B_MH_brace_support_upper_R_3of3.step
history/frame_v5_49.4kg/cad/parts/NM26-FRM-065_tube_J_Front_susp_ring_R_1of3.step
history/frame_v5_49.4kg/cad/parts/NM26-SUS-017_rocker_plate_rear_R.step
history/frame_v5_49.4kg/cad/parts/NM26-FRM-054_tube_A_FBH_support_lower_L_2of3.step
history/frame_v5_49.4kg/cad/parts/NM26-FRM-001_tube_H_Front_hoop_R_1of3.step
history/frame_v1_50.1kg/cad/parts/NM26-FRM-116_tube_B_Spool_carrier_brace_L_1of2.step
history/frame_v5_49.4kg/cad/parts/NM26-FRM-128_pickup_tab_front_upper_wishbone_at_front_bulkhead_R.step
history/frame_v1_50.1kg/cad/parts/NM26-AER-002_rear_wing_DRS_flap.step
history/frame_v1_50.1kg/cad/parts/NM26-AER-003_rear_wing_endplate_R.step
history/frame_v1_50.1kg/cad/parts/NM26-AER-004_rear_wing_endplate_L.step
history/frame_v1_50.1kg/cad/parts/NM26-AER-005_wing_strut_R.step
history/frame_v1_50.1kg/cad/parts/NM26-AER-009_wing_spar_C.step
history/frame_v1_50.1kg/cad/parts/NM26-AER-010_wing_strut_diagonal_C.step
history/frame_v1_50.1kg/cad/parts/NM26-AER-011_DRS_servo_15Nm.step
history/frame_v1_50.1kg/cad/parts/NM26-BDY-001_anti_intrusion_plate.step
history/frame_v1_50.1kg/cad/parts/NM26-BDY-002_impact_attenuator.step
history/frame_v1_50.1kg/cad/parts/NM26-BDY-003_firewall.step
history/frame_v1_50.1kg/cad/parts/NM26-BRK-001_caliper_front_R.step
history/frame_v1_50.1kg/cad/parts/NM26-BRK-002_caliper_front_L.step
history/frame_v1_50.1kg/cad/parts/NM26-BRK-003_caliper_rear_R.step
history/frame_v1_50.1kg/cad/parts/NM26-BRK-004_caliper_rear_L.step
history/frame_v1_50.1kg/cad/parts/NM26-BRK-006_brake_pedal.step
history/frame_v1_50.1kg/cad/parts/NM26-BRK-007_throttle_pedal.step
history/frame_v1_50.1kg/cad/parts/NM26-BRK-008_balance_bar.step
history/frame_v1_50.1kg/cad/parts/NM26-BRK-009_master_cyl_front_0.625in.step
history/frame_v1_50.1kg/cad/parts/NM26-BRK-010_reservoir_front.step
history/frame_v1_50.1kg/cad/parts/NM26-BRK-011_master_cyl_rear_0.750in.step
history/frame_v1_50.1kg/cad/parts/NM26-CKP-001_seat_shell.step
history/frame_v1_50.1kg/cad/parts/NM26-CKP-002_head_restraint.step
history/frame_v1_50.1kg/cad/parts/NM26-ELE-001_dash_panel.step
history/frame_v1_50.1kg/cad/parts/NM26-ELE-002_battery.step
history/frame_v1_50.1kg/cad/parts/NM26-ELE-003_primary_master_switch.step
history/frame_v1_50.1kg/cad/parts/NM26-ELE-004_e-stop.step
history/frame_v1_50.1kg/cad/parts/NM26-ELE-005_inertia_switch.step
history/frame_v1_50.1kg/cad/parts/NM26-ELE-006_kill_relay.step
history/frame_v1_50.1kg/cad/parts/NM26-ELE-007_brake_light.step
history/frame_v1_50.1kg/cad/parts/NM26-ELE-008_brake_overtravel_switch_BOTS.step
history/frame_v1_50.1kg/cad/parts/NM26-ELE-009_ignition_ECU.step
history/frame_v1_50.1kg/cad/parts/NM26-ELE-010_cooling_fan.step
history/frame_v1_50.1kg/cad/parts/NM26-FRM-001_tube_H_Front_hoop_R_1of3.step
history/frame_v1_50.1kg/cad/parts/NM26-FRM-002_tube_H_Front_hoop_L_1of3.step
history/frame_v1_50.1kg/cad/parts/NM26-FRM-003_tube_H_Front_hoop_R_2of3.step
history/frame_v1_50.1kg/cad/parts/NM26-FRM-004_tube_H_Front_hoop_L_2of3.step
history/frame_v1_50.1kg/cad/parts/NM26-FRM-005_tube_H_Front_hoop_R_3of3.step
history/frame_v1_50.1kg/cad/parts/NM26-FRM-006_tube_H_Front_hoop_L_3of3.step
history/frame_v1_50.1kg/cad/parts/NM26-FRM-015_tube_B_Upper_side_impact_R.step
history/frame_v1_50.1kg/cad/parts/NM26-FRM-016_tube_B_Upper_side_impact_L.step
history/frame_v1_50.1kg/cad/parts/NM26-FRM-017_tube_B_Lower_side_impact_R_1of3.step
history/frame_v1_50.1kg/cad/parts/NM26-FRM-018_tube_B_Lower_side_impact_L_1of3.step
history/frame_v1_50.1kg/cad/parts/NM26-FRM-020_tube_B_Lower_side_impact_L_2of3.step
history/frame_v1_50.1kg/cad/parts/NM26-FRM-021_tube_B_Lower_side_impact_R_3of3.step
history/frame_v1_50.1kg/cad/parts/NM26-FRM-023_tube_B_Anti-sub_floor_cross_R.step
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
