udayjain2102/nittanymotorsports/history/frame_v5_49.4kg/fusion_gd/setup_check.png

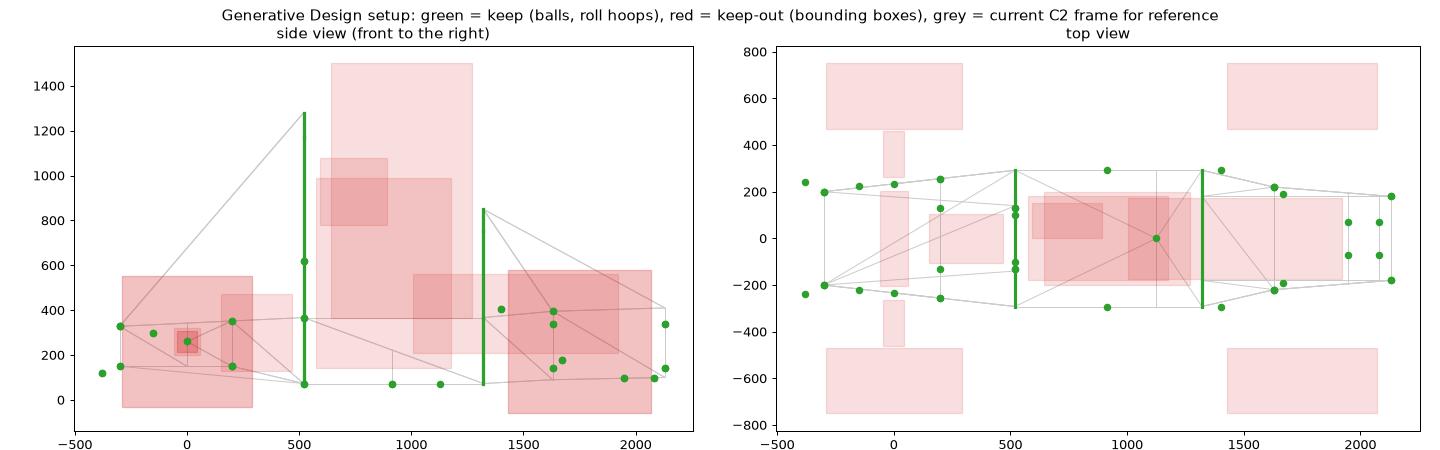
history/frame_v5_49.4kg/fusion_gd/setup_check.png
