udayjain2102/nittanymotorsports/history/frame_v5_49.4kg/SNAPSHOT.md

# frame_v5_49.4kg

The `mule/` folder exactly as it was at commit `551987f` (2026-10-10): Frame v5 (49.4 kg), the topology frame with CAD, shop data and quote package regenerated

Frozen copy for the build record; do not edit. Regenerating anything here does not change the current design in `mule/`.
