udayjain2102/nittanymotorsports/history/frame_v5_49.4kg/fusion_gd/LOADS.md

# Fusion Generative Design: NM26 frame study (generated by `fusion_gd.py`)

Curiosity study: Generative Design grows a solid, not a tube frame, so the result shows where the load paths
want to go. It is not buildable or rules-legal as-is (FSAE F.3 needs tubes of set sizes).

## Set-up
1. Upload both STEP files to the same Fusion folder; insert `NM26_GD_obstacles` into `NM26_GD_preserve`.
   Check the axes first: the main hoop top should sit at Y ≈ 1280 mm (X forward from the rear axle, Y up, Z right).
2. Generative Design workspace → **Preserve Geometry**: every body of `NM26_GD_preserve` (balls and hoop tubes).
3. **Obstacle Geometry**: every body of `NM26_GD_obstacles`.
4. Material: Steel AISI 4130 (or plain steel). Objective: minimise mass, safety factor 1.2. Manufacturing: Unrestricted.
5. One load case per section below: **Structural Constraints → Fixed** on the listed balls, **Structural Loads → Force**
   on each ball with the X/Y/Z components in newtons (X forward, Y up, Z right).

## Load case 1 torsion 1000 N*m
Fixed: rear_pickup_r_bot_L, rear_pickup_r_bot_R, rear_pickup_r_top_L, rear_pickup_r_top_R, rear_pickup_rr_bot_L, rear_pickup_rr_bot_R, rear_pickup_rr_top_L, rear_pickup_rr_top_R

| Preserve body | Fx (fwd) N | Fy (up) N | Fz (right) N |
|---|---|---|---|
| front_pickup_bh_lsus_L | 0 | -625 | 0 |
| front_pickup_bh_lsus_R | 0 | 625 | 0 |
| front_pickup_bh_sus_L | 0 | -625 | 0 |
| front_pickup_bh_sus_R | 0 | 625 | 0 |
| front_pickup_ring_lsus_L | 0 | -625 | 0 |
| front_pickup_ring_lsus_R | 0 | 625 | 0 |
| front_pickup_ring_sus_L | 0 | -625 | 0 |
| front_pickup_ring_sus_R | 0 | 625 | 0 |

## Load case 2 front right wheel 3g bump
Fixed: rear_pickup_r_bot_L, rear_pickup_r_bot_R, rear_pickup_r_top_L, rear_pickup_r_top_R, rear_pickup_rr_bot_L, rear_pickup_rr_bot_R, rear_pickup_rr_top_L, rear_pickup_rr_top_R

| Preserve body | Fx (fwd) N | Fy (up) N | Fz (right) N |
|---|---|---|---|
| front_pickup_bh_lsus_R | -237 | 2 | 229 |
| front_pickup_bh_sus_R | 243 | -24 | -200 |
| front_pickup_ring_lsus_R | 1189 | 30 | 3251 |
| front_pickup_ring_sus_R | -135 | -53 | -384 |
| front_rocker_pivot_R | 1533 | 1159 | -2259 |
| front_shock_mount_R | -2600 | 885 | -256 |
| rack_mount_R | 6 | -12 | -381 |

## Load case 3 rear right wheel corner+brake
Fixed: front_pickup_bh_lsus_L, front_pickup_bh_lsus_R, front_pickup_bh_sus_L, front_pickup_bh_sus_R, front_pickup_ring_lsus_L, front_pickup_ring_lsus_R, front_pickup_ring_sus_L, front_pickup_ring_sus_R

| Preserve body | Fx (fwd) N | Fy (up) N | Fz (right) N |
|---|---|---|---|
| rear_pickup_r_bot_R | 232 | -3 | 266 |
| rear_pickup_rr_bot_R | -112 | -2 | 162 |
| rear_pickup_rr_top_R | -235 | 21 | 321 |
| rear_rocker_pivot_R | 461 | 2037 | -33 |
| rear_shock_mount_R | -930 | -823 | -297 |
| rear_toe_link_R | -403 | -132 | -1738 |

## Load case 4 main hoop roll-over (AF4: 6 kN side, 5 kN aft, 9 kN down)
Fixed: front_pickup_bh_lsus_L, front_pickup_bh_lsus_R, front_pickup_bh_sus_L, front_pickup_bh_sus_R, front_pickup_ring_lsus_L, front_pickup_ring_lsus_R, front_pickup_ring_sus_L, front_pickup_ring_sus_R, rear_pickup_r_bot_L, rear_pickup_r_bot_R, rear_pickup_r_top_L, rear_pickup_r_top_R, rear_pickup_rr_bot_L, rear_pickup_rr_bot_R, rear_pickup_rr_top_L, rear_pickup_rr_top_R

| Preserve body | Fx (fwd) N | Fy (up) N | Fz (right) N |
|---|---|---|---|
| hoop_main (top cross) | -5000 | -9000 | 6000 |

## Load case 5 harness 20 g crash
Fixed: front_pickup_bh_lsus_L, front_pickup_bh_lsus_R, front_pickup_bh_sus_L, front_pickup_bh_sus_R, front_pickup_ring_lsus_L, front_pickup_ring_lsus_R, front_pickup_ring_sus_L, front_pickup_ring_sus_R, rear_pickup_r_bot_L, rear_pickup_r_bot_R, rear_pickup_r_top_L, rear_pickup_r_top_R, rear_pickup_rr_bot_L, rear_pickup_rr_bot_R, rear_pickup_rr_top_L, rear_pickup_rr_top_R

| Preserve body | Fx (fwd) N | Fy (up) N | Fz (right) N |
|---|---|---|---|
| mount_anti_sub | 0 | 1570 | 0 |
| mount_lap_L | 1663 | 2375 | 2016 |
| mount_lap_R | 1663 | 2375 | -2016 |
| mount_sb_L | 3496 | 499 | 0 |
| mount_sb_R | 3496 | 499 | 0 |

Load case 4 goes on the main hoop's top tube face. Simplifications: driver and engine are boxes/cylinders;
fixed supports stand in for the inertia relief the Python FEA uses, so stresses near the fixed balls read high.
