udayjain2102/nittanymotorsports/history/frame_v3_44.3kg/SNAPSHOT.md

# frame_v3_44.3kg

The `mule/` folder exactly as it was at commit `fce6480` (2026-10-01 18:03:18 -0400): Keep every version: restore old part files into history/frame_v2_46.4kg; history/ snapshots v1 and v2; snapshot.py; quote package reads the parts list

Frozen copy for the build record; do not edit. Regenerating anything here does not change the current design in `mule/`.
