udayjain2102/nittanymotorsports/history/frame_v2_46.4kg/fab/jig_node_coordinates.csv

node | X fwd from rear axle mm | height above table mm | Z right of centreline mm
r_bot_L | -300.0 | 49.7 | -200.0
r_top_L | -300.0 | 289.7 | -200.0
r_lsus_L | -300.0 | 89.7 | -200.0
r_sus_L | -300.0 | 279.7 | -200.0
r_bot_R | -300.0 | 49.7 | 200.0
r_top_R | -300.0 | 289.7 | 200.0
r_lsus_R | -300.0 | 89.7 | 200.0
r_sus_R | -300.0 | 279.7 | 200.0
sp_bot_L | 0.0 | 36.2 | -233.7
sp_top_L | 0.0 | 295.9 | -233.7
sp_mid_L | 0.0 | 89.7 | -233.7
sp_c_L | 0.0 | 200.2 | -233.7
sp_bot_R | 0.0 | 36.2 | 233.7
sp_top_R | 0.0 | 295.9 | 233.7
sp_mid_R | 0.0 | 89.7 | 233.7
sp_c_R | 0.0 | 200.2 | 233.7
rr_bot_L | 200.0 | 27.1 | -256.1
rr_top_L | 200.0 | 300.1 | -256.1
rr_lsus_L | 200.0 | 89.7 | -256.1
rr_sus_L | 200.0 | 279.7 | -256.1
em_rb_L | 200.0 | 27.1 | -130.0
em_rb_R | 200.0 | 27.1 | 130.0
rr_bot_R | 200.0 | 27.1 | 256.1
rr_top_R | 200.0 | 300.1 | 256.1
rr_lsus_R | 200.0 | 89.7 | 256.1
rr_sus_R | 200.0 | 279.7 | 256.1
mh_bot_L | 520.0 | 12.7 | -292.0
mh_sis_L | 520.0 | 306.7 | -292.0
mh_bar_L | 520.0 | 559.7 | -292.0
mh_sh_L | 520.0 | 1109.7 | -165.3
mh_top_L | 520.0 | 1219.7 | -140.0
em_fb_L | 520.0 | 12.7 | -130.0
em_ft_L | 520.0 | 306.7 | -130.0
sb_L | 520.0 | 559.7 | -100.0
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
