udayjain2102/nittanymotorsports/history/frame_v5_49.4kg/cad/view_engine.png

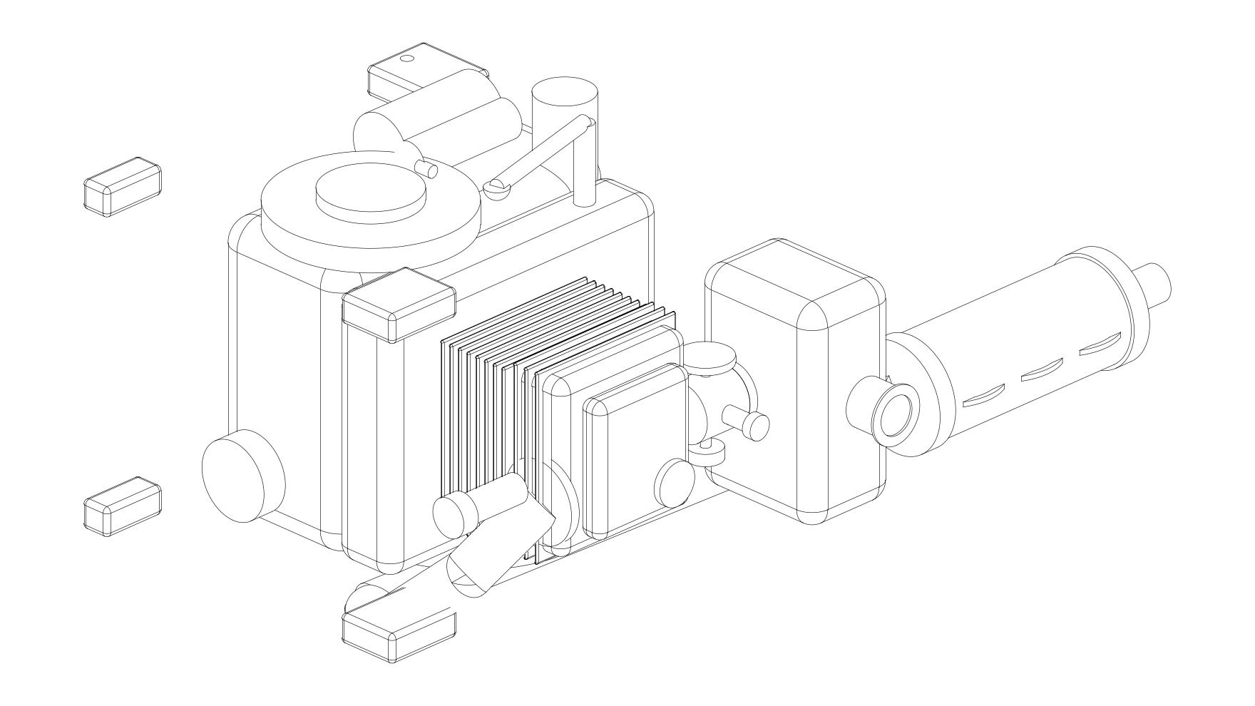
history/frame_v5_49.4kg/cad/view_engine.png
