udayjain2102/nittanymotorsports/history/frame_v5_49.4kg/cad/view_side.png

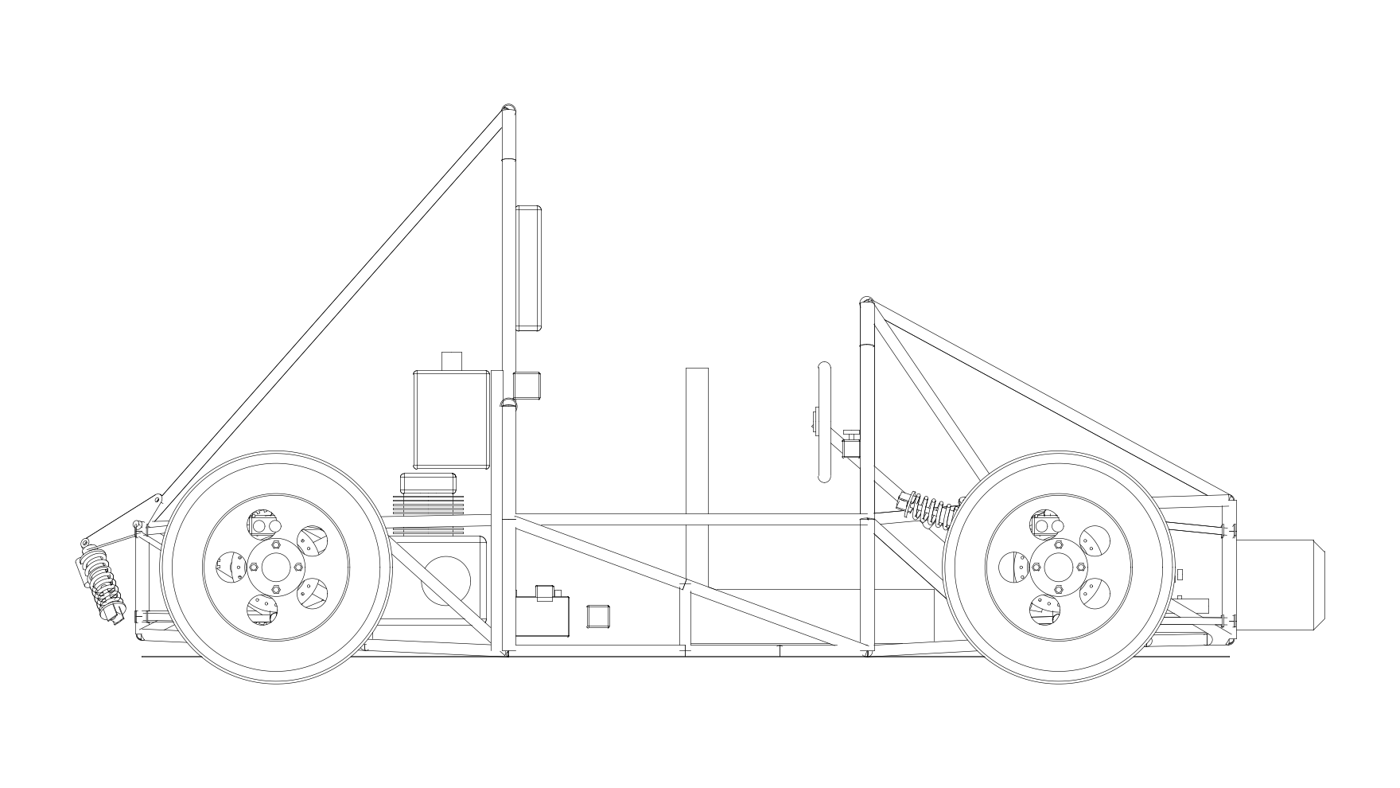
history/frame_v5_49.4kg/cad/view_side.png
