udayjain2102/nittanymotorsports/history/frame_v5_49.4kg/fab/jig_plan.png

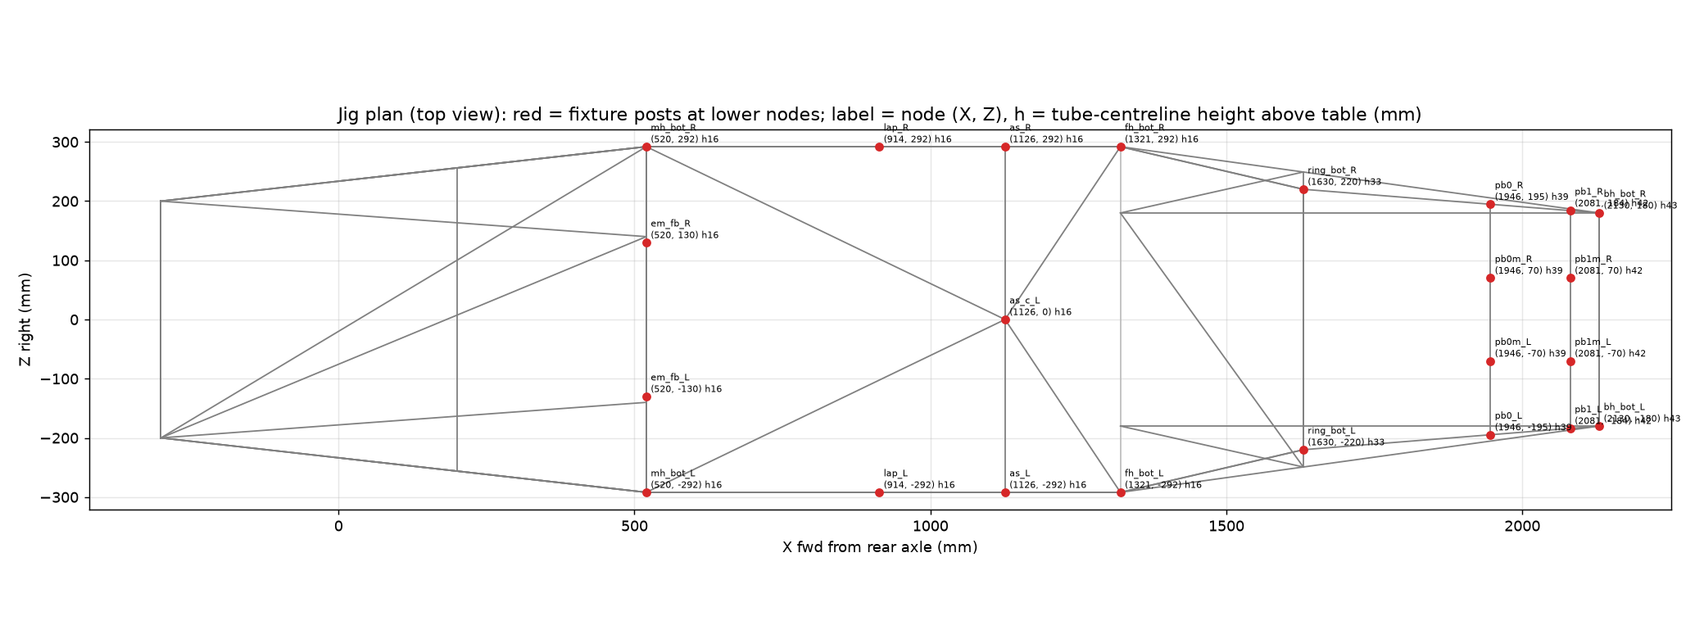
history/frame_v5_49.4kg/fab/jig_plan.png
