udayjain2102/nittanymotorsports/history/frame_v5_49.4kg/views/design_history.png

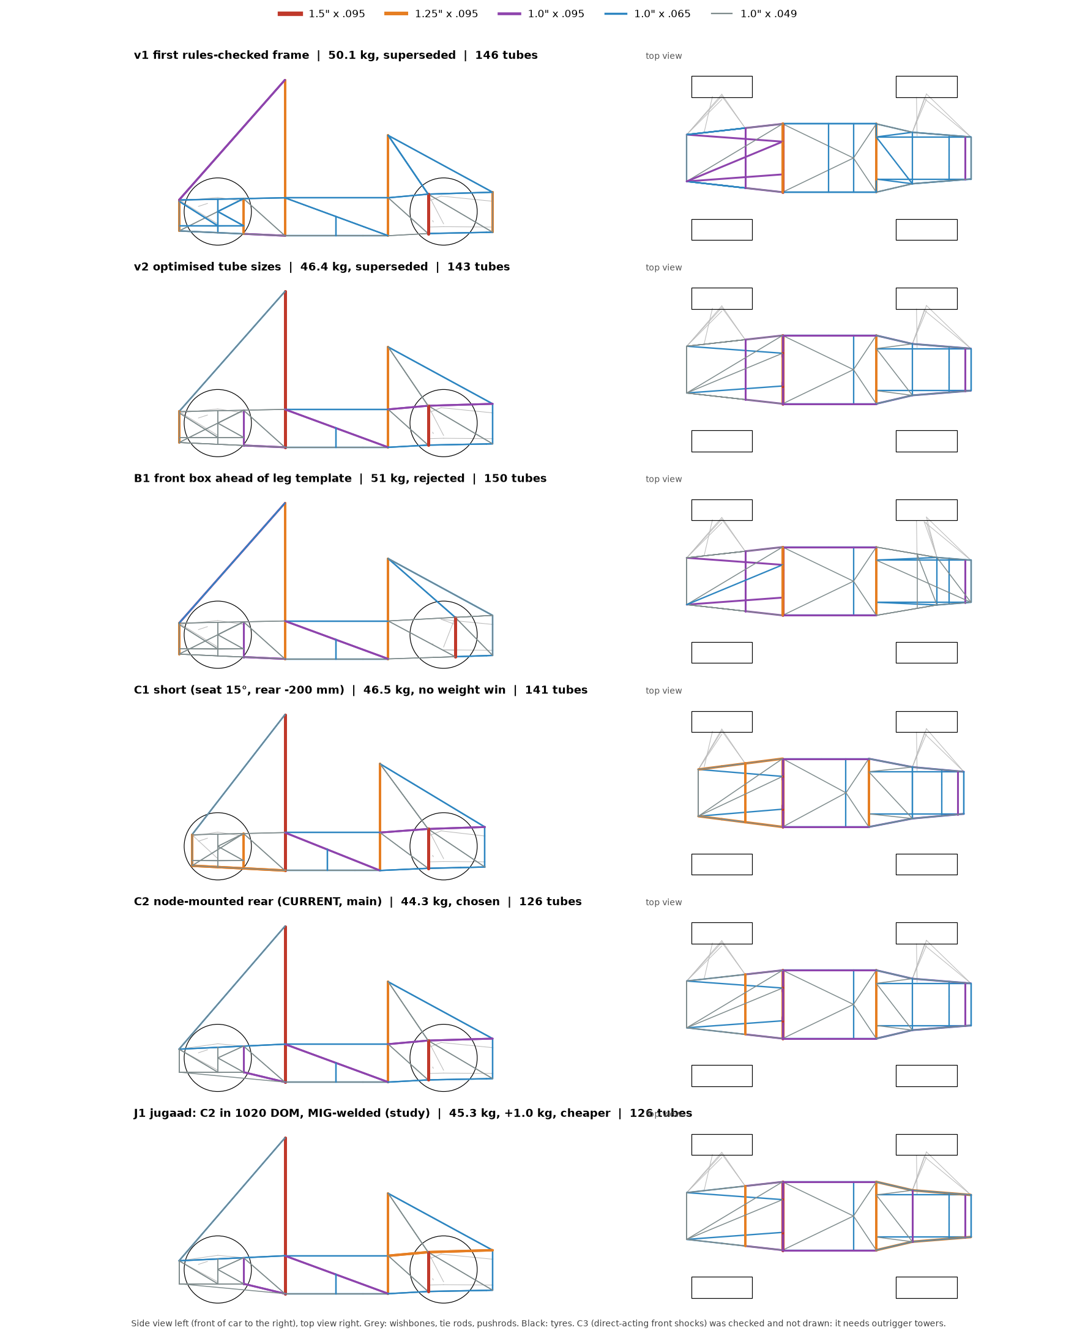
history/frame_v5_49.4kg/views/design_history.png
