udayjain2102/nittanymotorsports/history/frame_v5_49.4kg/views/mule_3view.png

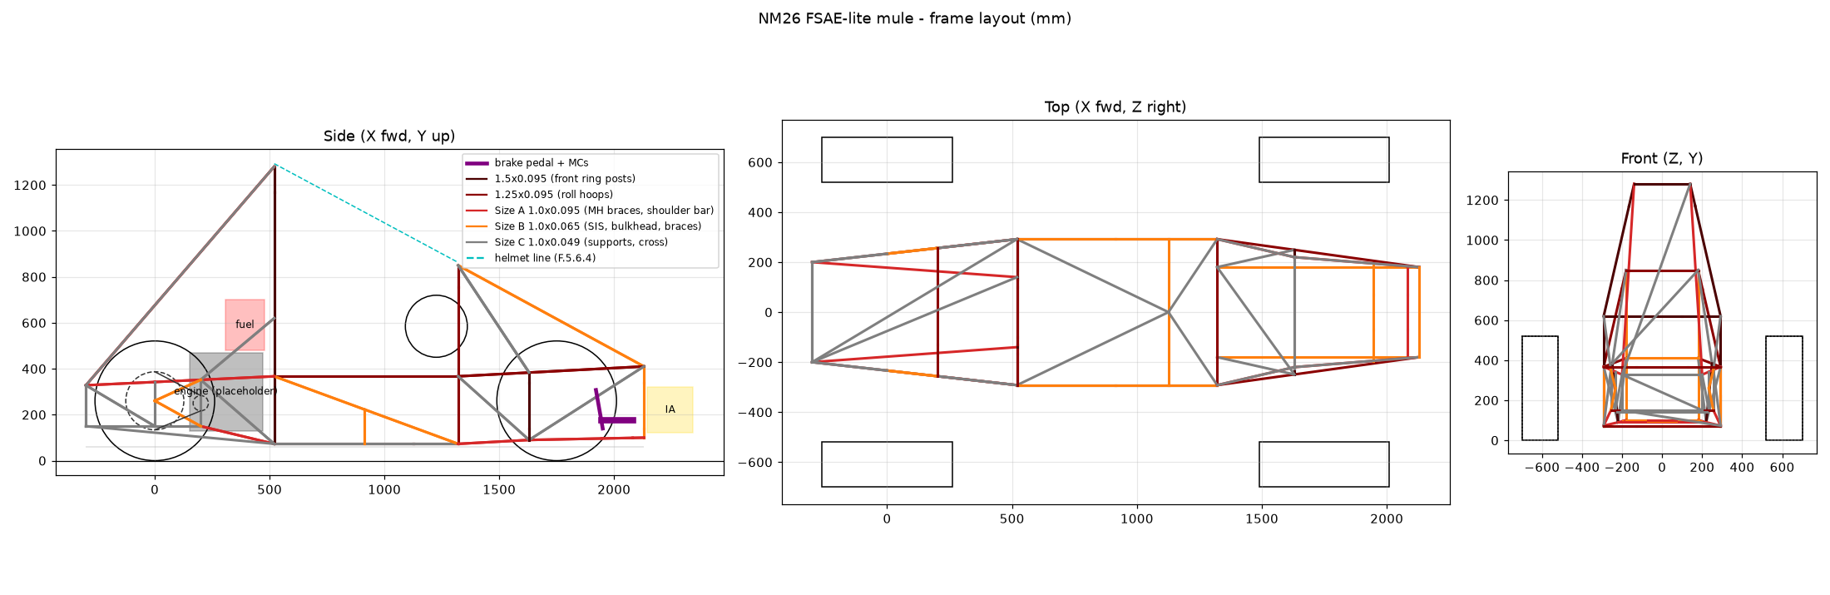
history/frame_v5_49.4kg/views/mule_3view.png
