udayjain2102/nittanymotorsports/history/frame_v5_49.4kg/views/suspension_corners.png

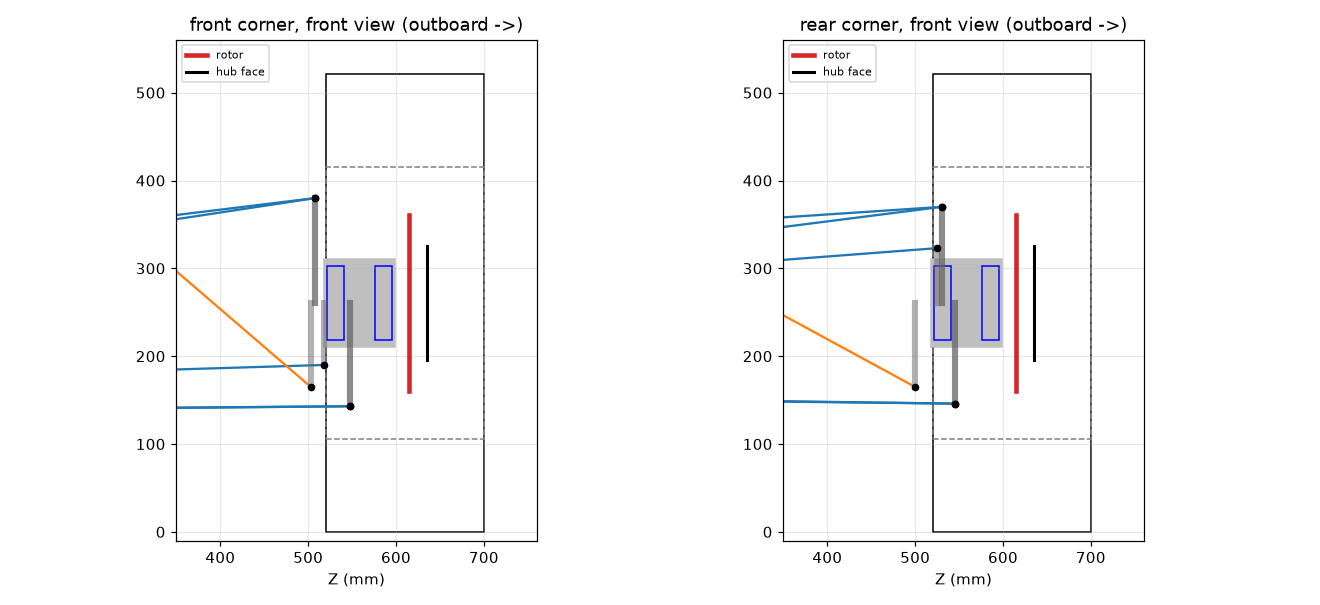
history/frame_v5_49.4kg/views/suspension_corners.png
