udayjain2102/nittanymotorsports/history/frame_v5_49.4kg/views/topo_search_best.png

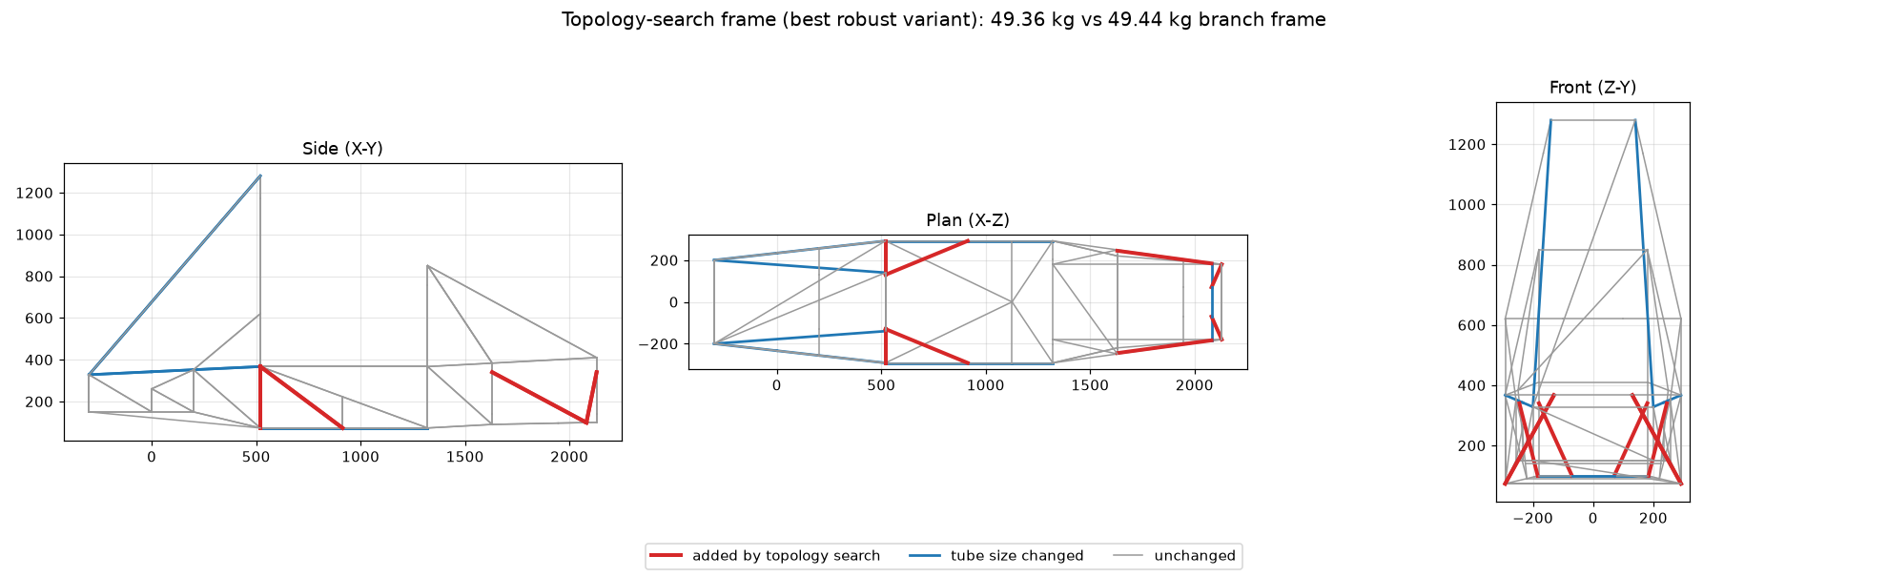
history/frame_v5_49.4kg/views/topo_search_best.png
