udayjain2102/nittanymotorsports/(commit log)

2026-09-30 Add NM26 FSAE-lite mule design package
    Parametric CAD (STEP), frame FEA, suspension/steering/brakes/powertrain/aero checks, rules checklist, build and test plans, project log. python report.py regenerates REPORT.md (165 design checks, 80 tests passing).
    [NM26_Frame_FEA.step, NM26_Mule.step, cut_sheet.csv, cutlist.csv, hoop_bends.csv, nodes.csv, parts.csv]
2026-09-30 Add cad/ export: assembly, per-part STEP files, views, parts list
    Exported before the rear wing and the 1220 mm rear track were added; mule/NM26_Mule.step is the current model.
    [NM26-BDY-001_anti_intrusion_plate.step, NM26-BDY-002_impact_attenuator.step, NM26-BDY-003_firewall.step, NM26-BDY-004_belly_pan_1.6mm.step, NM26-BRK-001_caliper_front_R.step, NM26-BRK-002_caliper_front_L.step, NM26-BRK-003_caliper_rear_R.step, NM26-BRK-004_caliper_rear_L.step]
2026-09-30 Unique CAD file names with descriptions, rear wing in the detailed CAD
    - cad_parts.py names every frame tube by size, role, side and position,
    and every tab by the frame point it is welded at; no two parts share a
    name (test enforced)
    - parts lists renamed to match their STEP files: NM26_Mule_parts.csv and
    cad/NM26_Assembly_parts.csv (new "contains" column for every part)
    - detailed CAD regenerated with the DRS rear wing (07_aero) and the
    1220 mm rear track
    - powertrain.py: rear toe link to CV half-shaft clearance check (54 mm)
    - root README lists what every file contains
    166 design checks and 80 tests pass (python report.py).
    [NM26-AER-001_rear_wing_main_plane.step, NM26-AER-002_rear_wing_DRS_flap.step, NM26-AER-003_rear_wing_endplate_R.step, NM26-AER-004_rear_wing_endplate_L.step, NM26-AER-005_wing_strut_R.step, NM26-AER-006_wing_brace_to_main_hoop_R.step, NM26-AER-007_wing_strut_L.step, NM26-AER-008_wing_brace_to_main_hoop_L.step]
2026-09-30 Make the repo easy to pick up: quick start, requirements, file guide
    - README: car picture, "I just want to..." table (CAD, parts, BOM, tests,
    requirements, history), quick start, how to change the design
    - requirements.txt: cadquery, numpy, matplotlib, pytest
    - .gitattributes marks STEP, SVG and generated reports as generated so
    diffs show real changes
    - Fusion location of the saved model: adi laptop files > Nittany
    Motorsports > NM26_Assembly_DRS_wing
2026-09-30 Detailed CAD pass: 15-part engine, real electrical/cockpit/fuel shapes, routing
    - new cad_detail.py: engine as 15 parts; realistic battery, switches,
    relay, seat, pedals, fuel cell; 23 routing runs (brake lines, throttle
    cable, 12 V harness) in a new 08_routing sub-assembly, cad/ROUTING.md
    - cad_parts.py hooks, 310 parts, all names unique; new engine and routing
    views; rear wing shown white; new hydraulic and wiring colours (RTG)
    - 166 design checks and 80 tests pass (python report.py)
    [NM26-AER-001_rear_wing_main_plane.step, NM26-AER-002_rear_wing_DRS_flap.step, NM26-AER-003_rear_wing_endplate_R.step, NM26-AER-004_rear_wing_endplate_L.step, NM26-AER-005_wing_strut_R.step, NM26-AER-006_wing_brace_to_main_hoop_R.step, NM26-AER-007_wing_strut_L.step, NM26-AER-008_wing_brace_to_main_hoop_L.step]
2026-09-30 Organise the folders: docs/, cad/simple/, fab/cutlist.csv, references/
    - documents (PDS, build plan, test plan, project log, report) -> mule/docs/
    - simple CAD model, its parts list and the frame FEA model -> mule/cad/simple/
    - cut list -> mule/fab/; third-party papers -> references/ (git-ignored)
    - scripts stay in mule/ (they import each other); output paths and README
    links updated; folder map in the root README
    - all outputs regenerated; 166 design checks and 80 tests pass
    [NM26_Frame_FEA.step, NM26_Mule.step, NM26_Mule_parts.csv, cutlist.csv]
2026-09-30 README: current Fusion model location after renaming the Fusion project files
2026-09-30 Phased budget plan: five funding steps of about $2,500 or less, about $6-9k to a driving car
    Kit engine + CVT first (upgrade to a used 450 later), used wheels, tyres and
    shocks, fabricated steel uprights, cheaper rack first, wing deferred. Price
    sources listed. BOM spring and rocker notes corrected to the current design.
2026-09-30 WORKDONE.md: overview of all work so far; info files brought up to date
    Root README links it and shows 166 checks; project log step 32 (Fusion
    tidy-up, budget plan) and the engine decision in open items; wing colour
    in the build plan is white.
2026-09-30 Engine decision before frame: kit-engine fit check, parts list
    powertrain.py Option A checks a Predator 420 + CVT on an adapter plate in the
    450 bay; at listed size it does not fit, so a used electric-start 450 is now
    recommended. WHATS_NEXT moves the engine choice ahead of the tube order.
    New docs/PARTS_LIST.md; budget, log and README updated.
2026-09-30 Engine chosen: CRF450R 2018+; fix flaky CI from singular FEA supports
    fea.inertia_relief picked 3-2-1 supports that all sat on the front bulkhead
    plane, leaving the stiffness matrix singular; CI runners on some CPUs got
    frame FoS 0.83 instead of 1.26. Now one node is clamped in 6 DOF (loads are
    already balanced). New test fails on the old code.
    ENGINE named CRF450R 2018+ with published 48 N*m torque (2017 is kick-start
    standard). WHATS_NEXT, PARTS_LIST, TEST_PLAN, PDS and log updated.
2026-09-30 test_loads: print every load case and BLAS config when the frame check fails
    Chasing a CI-only failure (frame FoS 0.829 vs 1.26 locally).
2026-09-30 Fix CI flake: rocker shock tangent was chosen by the last bit of rounding
    The two tangent solutions in rocker.design are mirror images with equal |B|;
    'pick the smaller' flipped the front rocker on some CI CPUs (frame FoS 0.83
    vs 1.26). TANGENT_SIDE now fixes the side per axle, as validated. Results
    unchanged. Log corrected: the FEA support fix was real but not the CI cause.
2026-09-30 Clearer file names: fab CSVs, simple-model views, suspension corners; fix .gitattributes paths
    Generators, tests and docs updated. No CAD files renamed or changed.
    [hoop_bend_program.csv, jig_node_coordinates.csv, tube_cut_sheet.csv, tube_order_list.csv]
2026-09-30 WHATS_NEXT.md: engine chosen, measure a CRF450R before tube, split step 3, supplier emails on hold until step 4
2026-09-30 CRF450R 2018+ gear ratios and engine mass from the 2017-18 service manual
    primary 66/28; gears 32/15, 29/17, 27/19, 23/19, 24/23; dry 30.9 kg.
    Top speed 117 km/h, accel 4.48 s; all checks pass. Test plan, PDS,
    build plan, READMEs, WORKDONE and WHATS_NEXT synced.
2026-10-01 Frame weight optimisation step 1: 50.1 -> 45.3 kg; shop quote package
    Optimiser over every frame load case right-sized tube groups down to their
    F.3.2.1 minimum and removed three non-required tubes (front bulkhead X-brace,
    front hoop base cross, lap-belt floor cross). 143 members, 78 pieces, torsion
    1886 N*m/deg, all 166 checks pass. Shortening the rear overhang was tried and
    not applied (saves ~0.2 kg). CAD, shop data and docs regenerated; previous
    frame tagged frame-v1-50kg.
    quote_package.py writes mule/quote/: frame weldment STEP, material list,
    cut sheet, bend programs, jig data and a cover note for the shop.
    [NM26-AER-001_rear_wing_main_plane.step, NM26-AER-002_rear_wing_DRS_flap.step, NM26-AER-003_rear_wing_endplate_R.step, NM26-AER-004_rear_wing_endplate_L.step, NM26-AER-005_wing_strut_R.step, NM26-AER-006_wing_brace_to_main_hoop_R.step, NM26-AER-007_wing_strut_L.step, NM26-AER-008_wing_brace_to_main_hoop_L.step]
2026-10-01 FRAME_RESEARCH.md: how lighter FSAE steel frames are built, with sources, applied to NM26
2026-10-01 Docs: reference-report lessons and stiffness target in FRAME_RESEARCH; WORKDONE section for 1 October frame work
2026-10-01 FRAME_RESEARCH: deep pass on documented frame geometry for the clean-sheet frame
2026-10-01 frame_rules.py: 34 checks for every geometric FSAE frame rule; RULES_MATRIX.md; no FSAE-lite skips
    Audit of all frame-relevant 2026 rules (V.1, F, T.1, T.2). New checks cover tube
    size per job, side-view triangulation (pin-jointed truss per side, structural tubes,
    straight tubes held straight through joints), hoops, braces, bent-member supports,
    mounts off the main hoop/braces, bulkhead and brace supports, side impact, shoulder
    bar, steering protection, hips in the Major Structure and open-wheel zones. Tests
    break each rule and confirm the check fails. Current frame passes: 200 checks, 88 tests.
2026-10-01 Docs sweep: full FSAE rules everywhere (no FSAE-lite), current frame results, CRF450R data, new files listed
2026-10-01 Reality gap: robustness.py + SIM_TO_REAL.md; frame margin restored (46.2 kg)
    robustness.py re-runs every frame case in 16 seeded tolerance samples (walls
    +/-10 %, joints +/-2 mm, joint flex 60-100 %) and checks tilt with mass errors.
    It found the optimised frame had no real-world slack in the 20 g harness case;
    shoulder bar back to 1.5" and side-impact diagonal to 1.0x0.095 fix it.
    SIM_TO_REAL.md maps NVIDIA's sim-to-real approach onto every NM26 model; test
    plan gains realistic twist pass mark, frame scan, shock check, real-to-sim column.
    210 checks, 91 tests.
    [NM26-AER-001_rear_wing_main_plane.step, NM26-AER-002_rear_wing_DRS_flap.step, NM26-AER-003_rear_wing_endplate_R.step, NM26-AER-004_rear_wing_endplate_L.step, NM26-AER-005_wing_strut_R.step, NM26-AER-006_wing_brace_to_main_hoop_R.step, NM26-AER-007_wing_strut_L.step, NM26-AER-008_wing_brace_to_main_hoop_L.step]
2026-10-01 CLEAN_SHEET.md: spec for the clean-sheet frame concepts (gates, A/B/C, B build steps)
2026-10-01 Fix roll-over model: AF4 support + welded-4130 criterion; frame_opt.py; frame re-sized (46.4 kg)
    The 6/5/9 kN roll-over cases held the car at its suspension pickups, hiding ~2.5x
    the hoop stress. Now AF4.1/4.2 support (hoop bottoms fixed; inertia relief agrees).
    Criterion (team choice A): welded 4130 at 85 % of ER70S-2 minimums, 340 MPa yield
    nominal FoS >= 1.0, 410 MPa ultimate under tube tolerances. frame_opt.py re-sizes
    every tube group under all gates and writes mule.py: main hoop 1.5", upper bulkhead
    supports 1.0x0.095, others smaller. 210 checks, 92 tests.
    [NM26-AER-001_rear_wing_main_plane.step, NM26-AER-002_rear_wing_DRS_flap.step, NM26-AER-003_rear_wing_endplate_R.step, NM26-AER-004_rear_wing_endplate_L.step, NM26-AER-005_wing_strut_R.step, NM26-AER-006_wing_brace_to_main_hoop_R.step, NM26-AER-007_wing_strut_L.step, NM26-AER-008_wing_brace_to_main_hoop_L.step]
2026-10-01 WHATS_NEXT, WORKDONE: C1 short done (46.5 kg, same mass as main, stiffer)
2026-10-01 C2 node-mounted rear: rear pickups on MH-brace-support rail nodes, rear posts no longer bend: 44.3 kg, 73 pieces, all checks pass
    Also: fab.py copes onto a >=20 deg same-size tube first; fea/aero take rear pickups from SUSP.
2026-10-01 WHATS_NEXT, WORKDONE: C2 node-mounted rear done (44.3 kg, best so far)
2026-10-01 Quote cover note: frame about 44 kg of tube
2026-10-01 Keep every version: restore old part files into history/frame_v2_46.4kg; history/ snapshots v1 and v2; snapshot.py; quote package reads the parts list
    [NM26-AER-001_rear_wing_main_plane.step, NM26-AER-002_rear_wing_DRS_flap.step, NM26-AER-003_rear_wing_endplate_R.step, NM26-AER-004_rear_wing_endplate_L.step, NM26-AER-005_wing_strut_R.step, NM26-AER-006_wing_brace_to_main_hoop_R.step, NM26-AER-007_wing_strut_L.step, NM26-AER-008_wing_brace_to_main_hoop_L.step]
2026-10-01 history/frame_v3_44.3kg: snapshot of the current design
    [NM26-AER-001_rear_wing_main_plane.step, NM26-AER-002_rear_wing_DRS_flap.step, NM26-AER-003_rear_wing_endplate_R.step, NM26-AER-004_rear_wing_endplate_L.step, NM26-AER-005_wing_strut_R.step, NM26-AER-006_wing_brace_to_main_hoop_R.step, NM26-AER-007_wing_strut_L.step, NM26-AER-008_wing_brace_to_main_hoop_L.step]
2026-10-01 Jugaad plan (cheapest rules-legal route, ~$4.0-8.3k), design history picture of every frame concept
2026-10-01 Jugaad plan re-priced with real engine and tube prices; 1020 not cheaper than 4130; budget tube line corrected
2026-10-01 WHATS_NEXT: NM26_Assembly_v5 (C2, 44.3 kg) uploaded to Fusion
2026-10-01 Fusion Generative Design frame study: preserve/obstacle STEPs, 5 load cases from the frame checks
    [NM26_GD_obstacles.step, NM26_GD_preserve.step]
2026-10-01 Docs: fix stale numbers from the audit (288 kg / 341 mm / 60.8° tilt, 28 rule checks, Fusion v5, C2 merged, Phase 1 and total budget re-priced, CV plunge 4.5 mm)
2026-10-01 WHATS_NEXT: frame audit findings to fix before ordering tube (F.3.4.2 welded allowable, F.5.2.3/F.5.6.3 bends, fab overhang, missing frontal/buckling cases)
2026-10-01 WHATS_NEXT: add the frame audit section (missed in the previous commit)
2026-10-01 Audit fixes 1/n: wing not fitted, mass budget completed, brakes re-sized, F.5.2.3 and F.5.6.3 checks fixed and met
    - aero.FITTED = False: wing off the base mule (mount points, frame case and checks kept). Tilt 60.8 -> 62.0 deg.
    - mass.py: AIP, IA, intake/restrictor, oil, chain guard, brake lines, bodywork, steel uprights (no extinguisher: VE.2.3.2).
    294 kg, 48.5 % front, CG 324 mm. loads.FRONT_SPLIT 0.45 -> 0.48.
    - brakes.py: compliance 0.6 -> 5 mm3/bar (estimate), ratio 4.5, rear MC 13/16, BOTS 55 mm, Wilwood 138 bar operating check.
    - frame_rules: F.5.2.3 needs same-size support within 30 deg of the bend plane; F.5.6.3 needs a side-view tube.
    ring_top moved onto the straight upper FBH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
2026-10-02 Audit fixes 2/n (gates, before re-size): buckling, frontal 95 kN, inertia-relief roll-over, 100 kg harness driver, fresh tolerance samples, T.1.3.2 legs, F.5.2.1, tube clash check, honest lap sim, fa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
    Frame not yet re-sized: frame_opt, robustness and TEST_PLAN tests still fail on this commit.
    [hoop_bend_program.csv, jig_node_coordinates.csv, tube_cut_sheet.csv]
2026-10-02 Audit fixes 3/n: frame re-sized against every new gate (50.23 kg, 4130, crash cases at F.3.4.2 300 MPa); real tube radii in checks; load cases 310 kg; CAD wing guarded
2026-10-02 Audit fixes 4/n: frame 50.44 kg passes every gate (optimiser margin 1.08 on fresh samples); all CAD, shop data, quote package and REPORT regenerated: 228/228 checks, 97/97 tests
    Old part STEPs kept in cad/parts (never delete); the CAD test now checks every listed part exists.
    [NM26-BDY-001_anti_intrusion_plate.step, NM26-BDY-002_impact_attenuator.step, NM26-BDY-003_firewall.step, NM26-BDY-004_belly_pan_1.6mm.step, NM26-BRK-001_caliper_front_R.step, NM26-BRK-002_caliper_front_L.step, NM26-BRK-003_caliper_rear_R.step, NM26-BRK-004_caliper_rear_L.step]
2026-10-02 Audit fixes 5/n: docs brought to the post-audit design (50.4 kg frame, 301 kg car, wing off, 267 bar, 228 checks / 97 tests); PROJECT_LOG and WORKDONE entries
2026-10-02 SIM_TO_REAL: brake lock-force band for the re-sized brakes
2026-10-02 history: frame_v4_50.4kg snapshot (post-audit design)
    [NM26-AER-001_rear_wing_main_plane.step, NM26-AER-002_rear_wing_DRS_flap.step, NM26-AER-003_rear_wing_endplate_R.step, NM26-AER-004_rear_wing_endplate_L.step, NM26-AER-005_wing_strut_R.step, NM26-AER-006_wing_brace_to_main_hoop_R.step, NM26-AER-007_wing_strut_L.step, NM26-AER-008_wing_brace_to_main_hoop_L.step]
2026-10-02 Fusion v6 uploaded (50.4 kg, no wing); DRS wiring dropped from the detailed CAD when the wing isn't fitted
    [NM26-BDY-001_anti_intrusion_plate.step, NM26-BDY-002_impact_attenuator.step, NM26-BDY-003_firewall.step, NM26-BDY-004_belly_pan_1.6mm.step, NM26-BRK-001_caliper_front_R.step, NM26-BRK-002_caliper_front_L.step, NM26-BRK-003_caliper_rear_R.step, NM26-BRK-004_caliper_rear_L.step]
2026-10-04 docs/VERSIONS.md: what changed between every frame version and every Fusion upload; Fusion v7 uploaded (clean, no DRS wire)
2026-10-04 Docs sweep: module descriptions, build-plan brake and wing items, frame research table and file indexes brought to the post-audit design; WORKDONE section for 2-3 Oct
2026-10-11 Topology experiment: remove FBH front-bay diagonal and upper spool post (50.44 -> 49.44 kg); close two frame_rules gaps
2026-10-11 Topology search with added diagonals and re-sizing: no robust gain (49.36 vs 49.44 kg); add leg-clearance and engine-envelope checks
2026-10-11 Frame v5 (49.4 kg): regenerate CAD, shop data and quote package for the topology frame; docs moved to 49.4 kg; 232/232 checks, 97/97 tests
    [NM26-BDY-001_anti_intrusion_plate.step, NM26-BDY-002_impact_attenuator.step, NM26-BDY-003_firewall.step, NM26-BDY-004_belly_pan_1.6mm.step, NM26-BRK-001_caliper_front_R.step, NM26-BRK-002_caliper_front_L.step, NM26-BRK-003_caliper_rear_R.step, NM26-BRK-004_caliper_rear_L.step]
2026-10-11 history: frame_v5_49.4kg snapshot (topology frame)
    [NM26-AER-001_rear_wing_main_plane.step, NM26-AER-002_rear_wing_DRS_flap.step, NM26-AER-003_rear_wing_endplate_R.step, NM26-AER-004_rear_wing_endplate_L.step, NM26-AER-005_wing_strut_R.step, NM26-AER-006_wing_brace_to_main_hoop_R.step, NM26-AER-007_wing_strut_L.step, NM26-AER-008_wing_brace_to_main_hoop_L.step]
2026-10-12 Docs sweep for frame v5 (49.4 kg): current numbers in README, WORKDONE, WHATS_NEXT, test plan, PDS, budget and frame research; topology scripts in the file index
2026-10-12 BUILD_PLAN: torsion 2399 N·m/deg for frame v5
2026-10-12 Fusion v8 uploaded (frame v5, 49.4 kg); Fusion v4 relabelled as the 50.1 kg frame to match VERSIONS.md
2026-10-12 Fusion version clean-up: near-duplicate uploads renamed _superseded (Assembly v6, Mule_simple v2, sideways concept import); Mule_simple v1-v3 differences recorded
